Meshack-Kinyua/Omarichet_Versionngs/Omarichet EduSat/Electrical/PCB Designs v2/README.md

# Omarichet Edusat PCB Designs V2

This folder contains work related to the next set of designs for the Omarichet Edusat.
It takes into consideration feedback as well as test data on the previous work done on the version 1.
This designs are aimed at being close to the final product design as possible. 
Considerations will be taken on matters regarding the User experience and intuitive use of the kit.

## Objectives
* Make changes and improvements on the component choices.
* Make changes on the layout.
* Improve on the silkscreen labels.
* Added connectors to allow quick connection of the Boards to the various accessoriess.

**Note**
Specific Objectives and requirements will provided in the folders with the speccific board being worked on.
