Meshack-Kinyua/Omarichet_Versionngs/Omarichet EduSat/Electrical/PCB designs/Omarichet Sensor Shield v1.32 Gearbox Constraints/GearboxDesignConstraints.txt

Minimum Track width 0.7mm
Minimum clearance between tracks 0.8mm
Minimum Via size 0.3mm
