Meshack-Kinyua/Omarichet_Versionngs/EduSat v1/EPSv2/Project Outputs for EduSAT EPSv2/EduSAT-EPSv2_Pads_Top.pdf

EduSAT-EPSv2_Pads_Top (Current screen) Scale=1.00 Sat Jul 13 14:36:50 2024

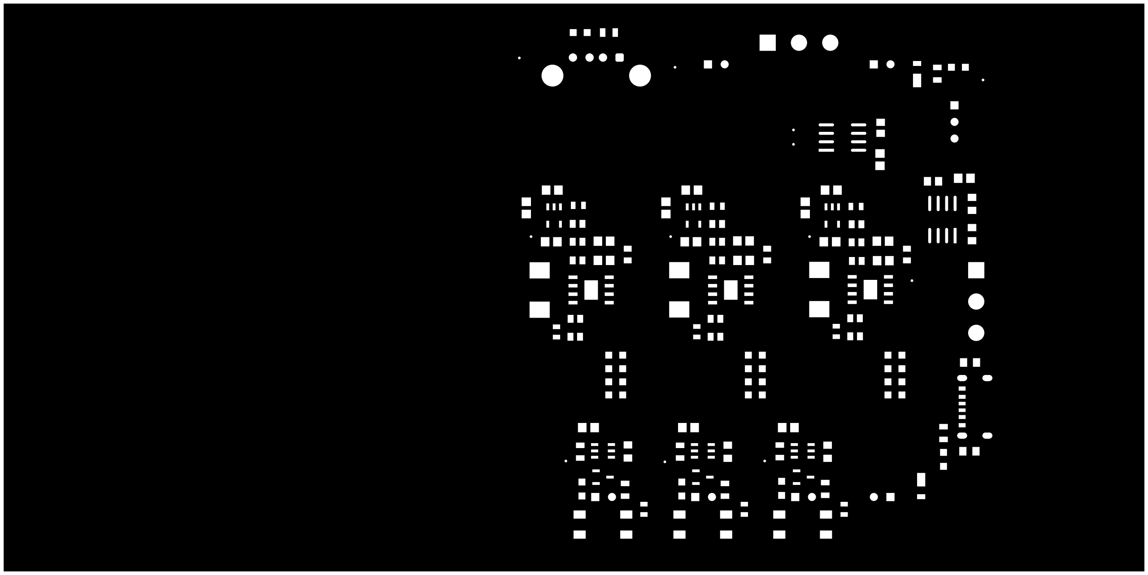
[picture p2: figure]
