Meshack-Kinyua/Omarichet_Versionngs/Omarichet EduSat/Electrical/Datasheets/Adafruit GPS/Schematic.png

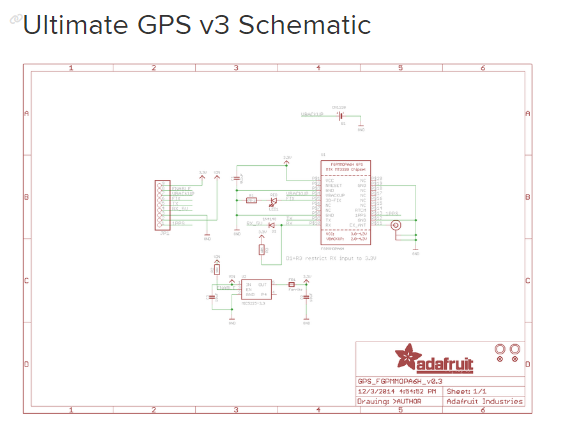
Omarichet EduSat/Electrical/Datasheets/Adafruit GPS/Schematic.png
