Meshack-Kinyua/Omarichet_Versionngs/Omarichet EduSat/Electrical/Omarichet Sensor Shield 2.png

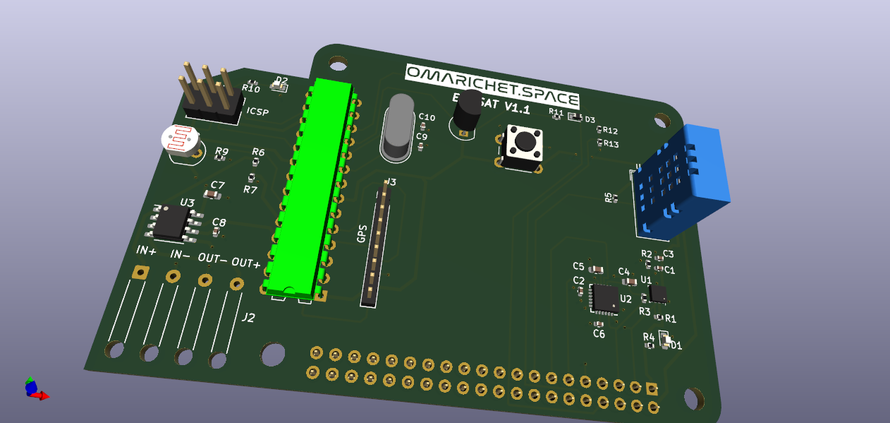
Omarichet EduSat/Electrical/Omarichet Sensor Shield 2.png
