Meshack-Kinyua/Omarichet_Versionngs/Omarichet EduSat/Electrical/PCB designs/Omarichet Sensor Shield v1.32 Gearbox Constraints/Omarichet Sensor Shield 1.3.png

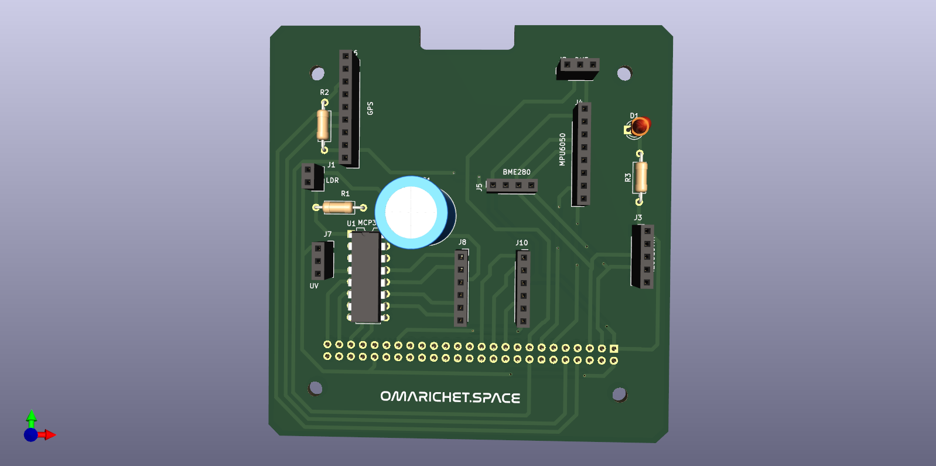
Omarichet EduSat/Electrical/PCB designs/Omarichet Sensor Shield v1.32 Gearbox Constraints/Omarichet Sensor Shield 1.3.png
