Meshack-Kinyua/Omarichet_Versionngs/Omarichet EduSat/Electrical/PCB designs/PCB Images/Omarichet Sensor shield Design.png

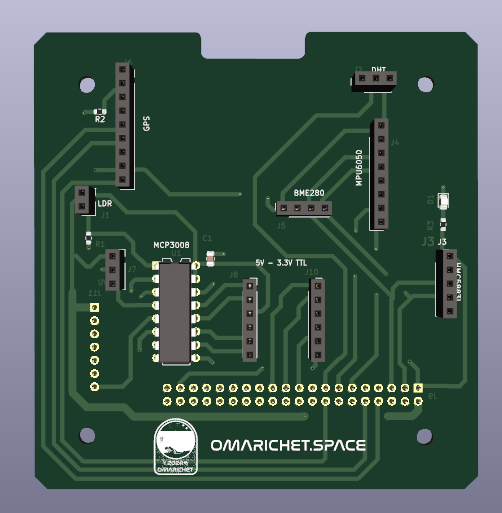
Omarichet EduSat/Electrical/PCB designs/PCB Images/Omarichet Sensor shield Design.png
