Meshack-Kinyua/Omarichet_Versionngs/Omarichet EduSat/Electrical/Simulations/RPI UART voltage divider/TX to TXD.png

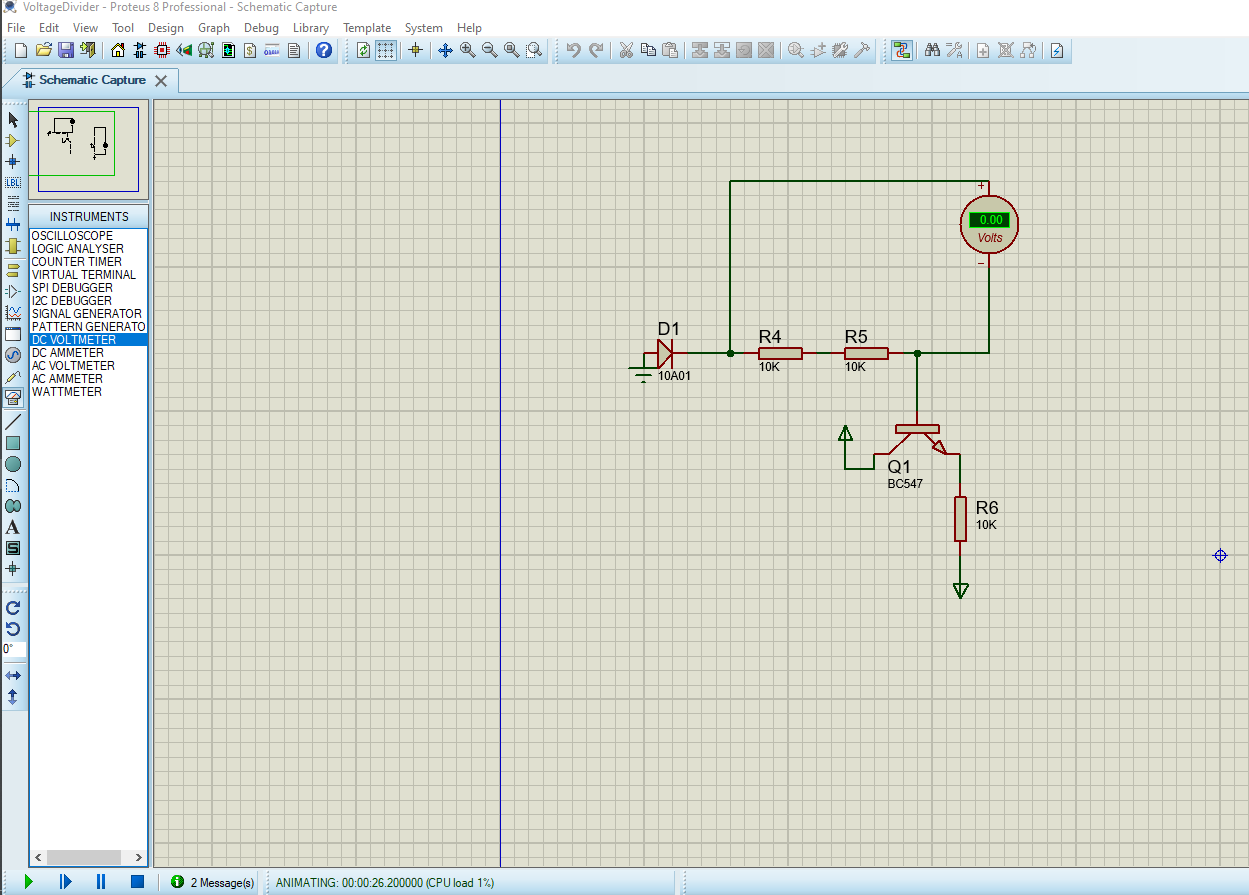
Omarichet EduSat/Electrical/Simulations/RPI UART voltage divider/TX to TXD.png
