Meshack-Kinyua/Omarichet_Versionngs/Omarichet EduSat/Electrical/Simulations/RPI UART voltage divider/TXD to TX.png

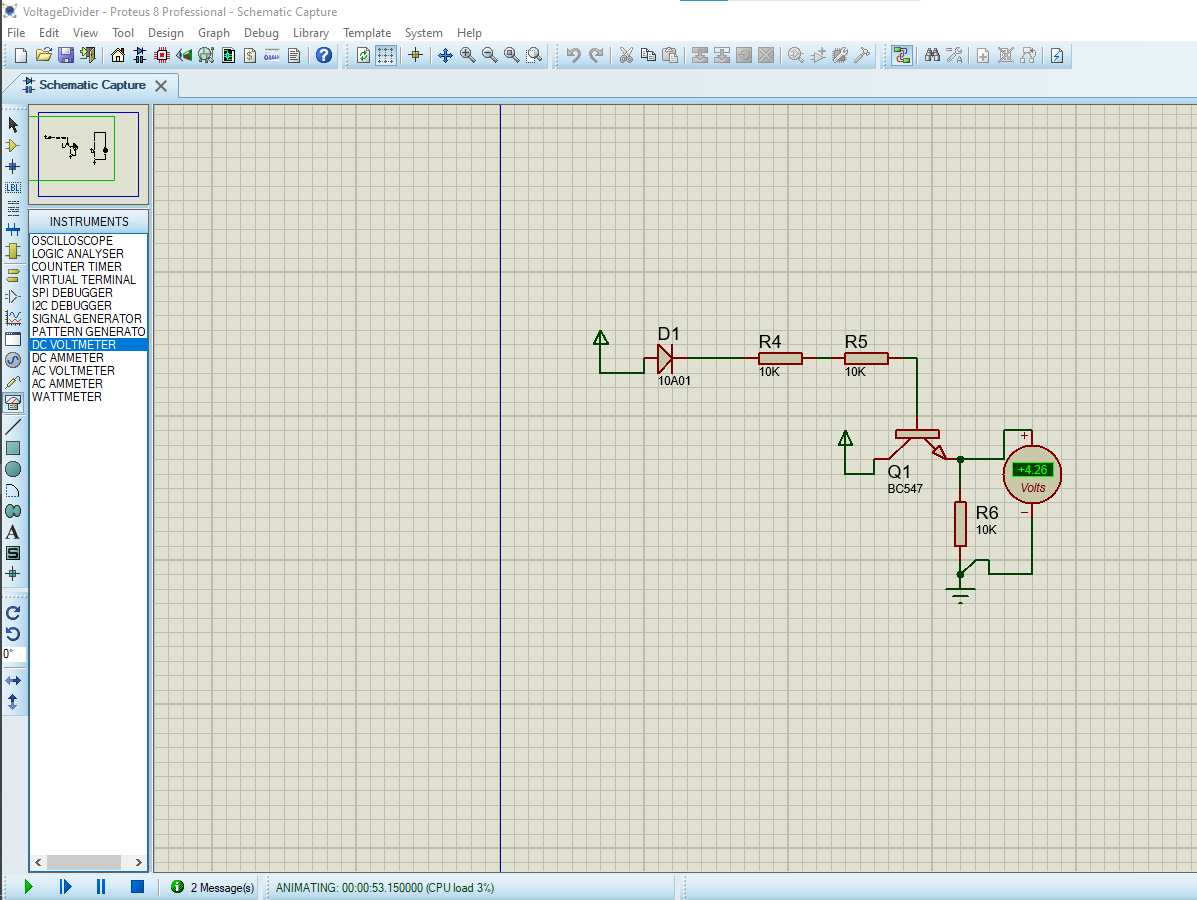
Omarichet EduSat/Electrical/Simulations/RPI UART voltage divider/TXD to TX.png
