Meshack-Kinyua/Omarichet_Versionngs/EduSat v1/EPSv2/Project Outputs for EduSAT EPSv2/BOM.PDF

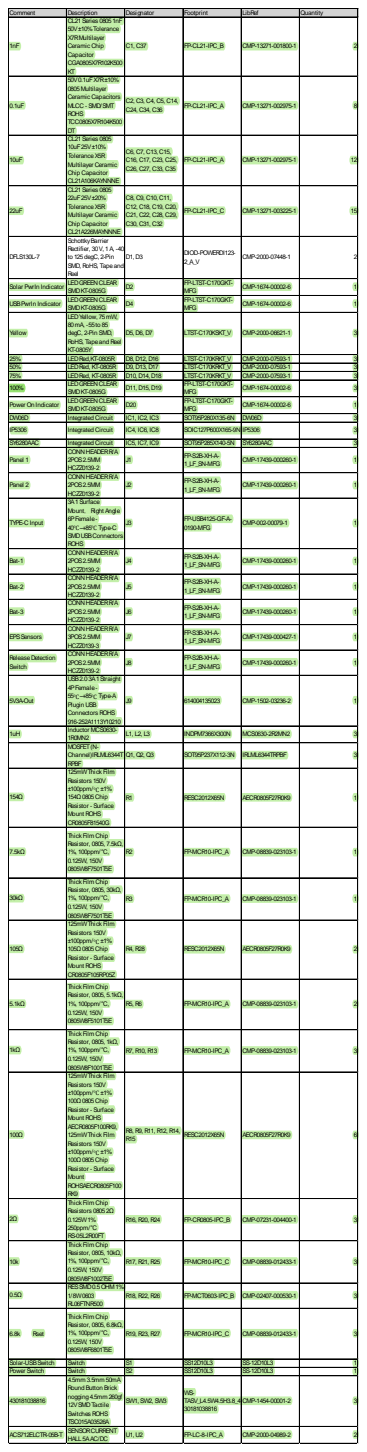
[picture p9: page 1]

0.1uF | 50V0.1uFX7R±10% 0805Multilayer Ceramic Capacitors MLCC - SMD/SMT ROHS TCC0805X7R104K500 DT | C2, C3, C4, C5, C14, C24, C34, C36 | FP-CL21-IPC_A | CMP-13271-002975-1 | | 8

10uF | CL21Series 0805 10uF25V±10% ToleranceX5R Multilayer Ceramic Chip Capacitor CL21A106KAYNNNE | C6, C7, C13, C15, C16, C17, C23, C25, C26, C27, C33, C35 | FP-CL21-IPC_A | CMP-13271-002975-1 | 12

22uF | CL21Series 0805 22uF25V±20% ToleranceX5R Multilayer Ceramic Chip Capacitor CL21A226MAYNNNE | C8, C9, C10, C11, C12, C18, C19, C20, C21, C22, C28, C29, C30, C31, C32 | FP-CL21-IPC_C | CMP-13271-003225-1 | 15

DFLS130L-7 | SchottkyBarrier Rectifier, 30V, 1A, -40 to 125degC, 2-Pin SMD, RoHS, Tapeand Reel | D1, D3 | DIOD-POWERDI123-2_A_V | CMP-2000-07448-1 | | 2

Solar PwrIn Indicator | LEDGREEN CLEAR SMDKT-0805G | D2 | FP-LTST-C170GKT-MFG | CMP-1674-00002-6 | | 1

USBPwrIn Indicator | LEDGREEN CLEAR SMDKT-0805G | D4 | FP-LTST-C170GKT-MFG | CMP-1674-00002-6 | | 1

Yellow | LEDYellow, 75mW, 80mA, -55to 85 degC, 2-Pin SMD, RoHS, Tapeand Reel KT-0805Y | D5, D6, D7 | LTST-C170KSKT_V | CMP-2000-06621-1 | | 3

25% | LEDRed,KT-0805R | D8, D12, D16 | LTST-C170KRKT_V | CMP-2000-07593-1 | | 3
50% | LEDRed, KT-0805R | D9, D13, D17 | LTST-C170KRKT_V | CMP-2000-07593-1 | | 3
75% | LEDRed, KT-0805R | D10, D14, D18 | LTST-C170KRKT_V | CMP-2000-07593-1 | | 3
100% | LEDGREEN CLEAR SMDKT-0805G | D11, D15, D19 | FP-LTST-C170GKT-MFG | CMP-1674-00002-6 | | 3

Power On Indicator | LEDGREEN CLEAR SMDKT-0805G | D20 | FP-LTST-C170GKT-MFG | CMP-1674-00002-6 | | 1

DW06D | Integrated Circuit | IC1, IC2, IC3 | SOT95P280X135-6N | DW06D | | 3

IP5306 | Integrated Circuit | IC4, IC6, IC8 | SOIC127P600X165-9N IP5306 | | | 3

SY6280AAC | Integrated Circuit | IC5, IC7, IC9 | SOT95P285X140-5N | SY6280AAC | | 3
Panel 1 | CONN HEADERR/A 2POS2.5MM HCZZ0139-2 | J1 | FP-S2B-XH-A-1_LF_SN-MFG | CMP-17439-000260-1 | | 1

Panel 2 | CONN HEADERR/A 2POS2.5MM HCZZ0139-2 | J2 | FP-S2B-XH-A-1_LF_SN-MFG | CMP-17439-000260-1 | | 1

TYPE-C Input | 3A1Surface Mount，Right Angle 6PFemale-40℃~+85℃ Type-C SMDUSBConnectors ROHS | J3 | FP-USB4125-GF-A-0190-MFG | CMP-002-00079-1 | | 1

Bat-1 | CONN HEADERR/A 2POS2.5MM HCZZ0139-2 | J4 | FP-S2B-XH-A-1_LF_SN-MFG | CMP-17439-000260-1 | | 1

Bat-2 | CONN HEADERR/A 2POS2.5MM HCZZ0139-2 | J5 | FP-S2B-XH-A-1_LF_SN-MFG | CMP-17439-000260-1 | | 1

Bat-3 | CONN HEADERR/A 2POS2.5MM HCZZ0139-2 | J6 | FP-S2B-XH-A-1_LF_SN-MFG | CMP-17439-000260-1 | | 1

EPSSensors | CONN HEADERR/A 3POS2.5MM HCZZ0139-3 | J7 | FP-S3B-XH-A-1_LF_SN-MFG | CMP-17439-000427-1 | | 1

ReleaseDetection Switch | CONN HEADERR/A 2POS2.5MM HCZZ0139-2 | J8 | FP-S2B-XH-A-1_LF_SN-MFG | CMP-17439-000260-1 | | 1

5V3A-Out | USB2.03A1Straight 4PFemale-55℃~+85℃ Type-A Plugin USB Connectors ROHS 916-252A1113Y10210 | J9 | 614004135023 | CMP-1502-03236-2 | | 1

1uH | Inductor MCS0630-1R0MN2 | L1, L2, L3 | INDPM7366X300N | MCS0630-2R2MN2 | | 3

MOSFET(N-Channel)IRLML6344T RPBF | Q1, Q2, Q3 | SOT95P237X112-3N | IRLML6344TRPBF | | 3

154Ω | 125mWThick Film Resistors 150V ±100ppm/℃ ±1% 154Ω0805Chip Resistor - Surface Mount ROHS CR0805F81540G | R1 | RESC2012X65N | AECR0805F27R0K9 | | 1

7.5kΩ | Thick Film Chip Resistor, 0805, 7.5kΩ, 1%, 100ppm/°C, 0.125W, 150V 0805W8F7501T5E | R2 | FP-MCR10-IPC_A | CMP-08839-023103-1 | | 1

30kΩ | Thick Film Chip Resistor, 0805, 30kΩ, 1%, 100ppm/°C, 0.125W, 150V 0805W8F7501T5E | R3 | FP-MCR10-IPC_A | CMP-08839-023103-1 | | 1

105Ω | 125mWThick Film Resistors 150V ±100ppm/℃ ±1% 105Ω0805Chip Resistor - Surface Mount ROHS CR0805F105RP05Z | R4, R28 | RESC2012X65N | AECR0805F27R0K9 | | 2

5.1kΩ | Thick Film Chip Resistor, 0805, 5.1kΩ, 1%, 100ppm/°C, 0.125W, 150V 0805W8F5101T5E | R5, R6 | FP-MCR10-IPC_A | CMP-08839-023103-1 | | 2

1kΩ | Thick Film Chip Resistor, 0805, 1kΩ, 1%, 100ppm/°C, 0.125W, 150V 0805W8F1001T5E | R7, R10, R13 | FP-MCR10-IPC_A | CMP-08839-023103-1 | | 3

100Ω | 125mWThick Film Resistors 150V ±100ppm/℃ ±1% 100Ω0805Chip Resistor - Surface Mount ROHS AECR0805F100RK9, 125mWThick Film Resistors 150V ±100ppm/℃ ±1% 100Ω0805Chip Resistor - Surface Mount ROHSAECR0805F100 RK9 | R8, R9, R11, R12, R14, R15 | RESC2012X65N | AECR0805F27R0K9 | | 6

2Ω | Thick Film Chip Resistors 08052Ω 0.125W1% 250ppm/°C RS-05L2R00FT | R16, R20, R24 | FP-CR0805-IPC_B | CMP-07231-004400-1 | | 3

10k | Thick Film Chip Resistor, 0805, 10kΩ, 1%, 100ppm/°C, 0.125W, 150V 0805W8F1002T5E | R17, R21, R25 | FP-MCR10-IPC_C | CMP-08839-012433-1 | | 3

0.5Ω | RESSMD0.5OHM1% 1/8W0603 RL06FTNR500 | R18, R22, R26 | FP-MCT0603-IPC_B | CMP-02407-000530-1 | | 3

6.8k Rset | Thick Film Chip Resistor, 0805, 6.8kΩ, 1%, 100ppm/°C, 0.125W, 150V 0805W8F6801T5E | R19, R23, R27 | FP-MCR10-IPC_C | CMP-08839-012433-1 | | 3

Solar-USBSwitch | Switch | S1 | SS12D10L3 | SS-12D10L3 | | 1
Power Switch | Switch | S2 | SS12D10L3 | SS-12D10L3 | | 1
430181038816 | 4.5mm 3.5mm 50mA Round Button Brick nogging4.5mm 260gf 12VSMDTactile Switches ROHS TSC015A03526A | SW1, SW2, SW3 | WS-TASV_L4.5W4.5H3.8_4 30181038816 | CMP-1454-00001-2 | | 3

ACS712ELCTR-05B-T | SENSORCURRENT HALL5AAC/DC | U1, U2 | FP-LC-8-IPC_A | CMP-2000-04989-2 | | 2
