Meshack-Kinyua/Omarichet_Versionngs/EduSat v2/EPSv3/Resources/Footprints/1043/1043.step

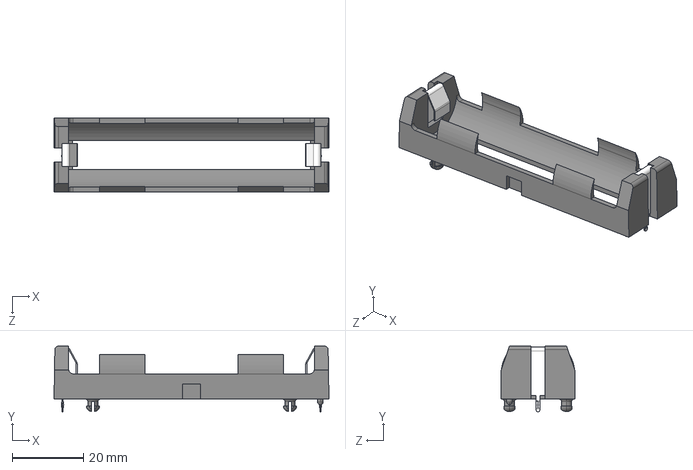
[picture p10: CAD file, 2024-10-04]
EduSat v2/EPSv3/Resources/Footprints/1043/1043.step
77.1 x 18.4 x 20.7 mm
