Meshack-Kinyua/Omarichet_Versionngs/EduSat v2/EPSv3/Resources/Footprints/DFLS130L-7/DFLS130L-7.step

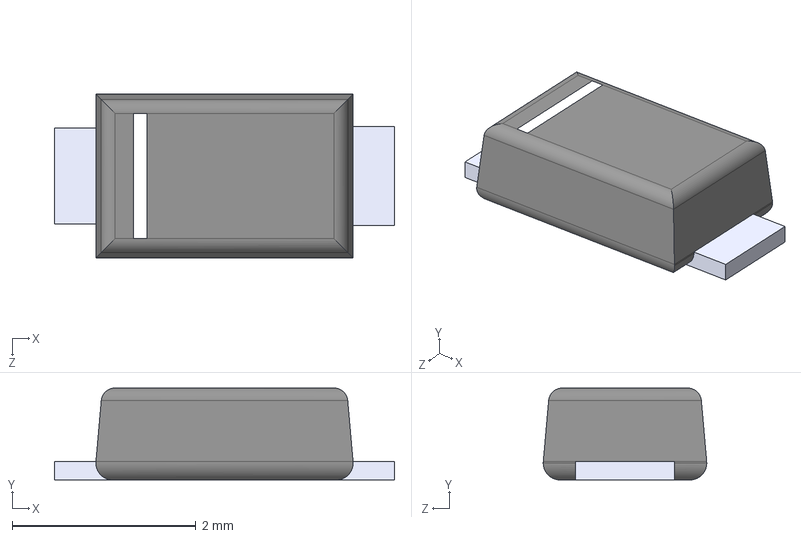
[picture p11: CAD file, 2024-10-02]
EduSat v2/EPSv3/Resources/Footprints/DFLS130L-7/DFLS130L-7.step
3.70 x 1.00 x 1.78 mm
