Meshack-Kinyua/Omarichet_Versionngs/EduSat v2/EPSv3/Resources/Footprints/IP5306/IP5306.step

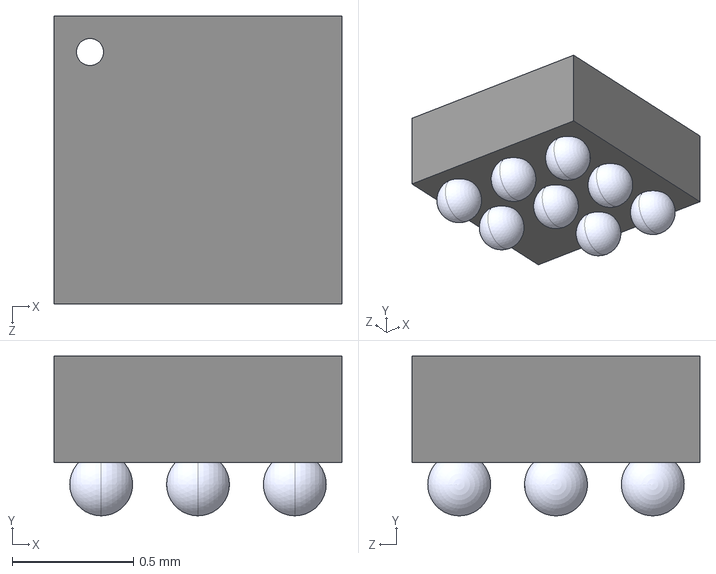
[picture p12: CAD file, 2024-10-02]
EduSat v2/EPSv3/Resources/Footprints/IP5306/IP5306.step
1.19 x 0.66 x 1.19 mm
