Meshack-Kinyua/Omarichet_Versionngs/EduSat v2/EPSv3/Resources/Footprints/LIB_MCS0630-100MN1/MCS0630-100MN1/3D/MCS0630-100MN1.stp

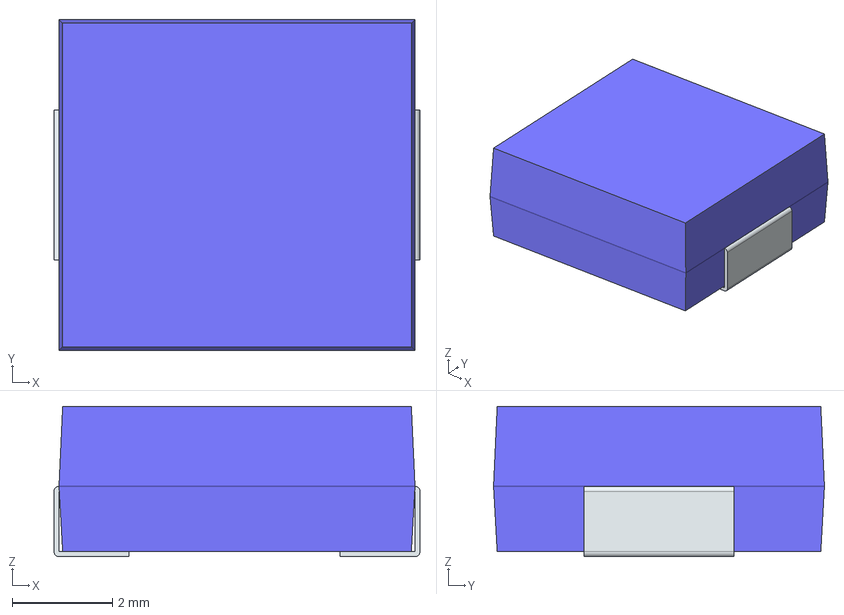
[picture p13: CAD file, 2024-10-02]
EduSat v2/EPSv3/Resources/Footprints/LIB_MCS0630-100MN1/MCS0630-100MN1/3D/MCS0630-100MN1.stp
7.30 x 6.60 x 3.00 mm
FilletPin1
FilletPin2
