Meshack-Kinyua/Omarichet_Versionngs/EduSat v2/EPSv3/Resources/Footprints/LIB_PTS647SM50SMTR2LFS/PTS647SM50SMTR2LFS/3D/PTS647SM50SMTR2LFS.stp

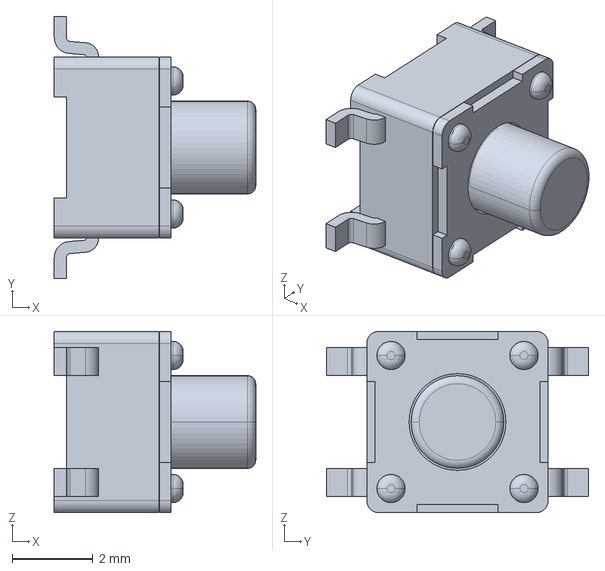
[picture p14: CAD file, 2024-10-02]
EduSat v2/EPSv3/Resources/Footprints/LIB_PTS647SM50SMTR2LFS/PTS647SM50SMTR2LFS/3D/PTS647SM50SMTR2LFS.stp
5.00 x 6.50 x 4.50 mm
