Meshack-Kinyua/Omarichet_Versionngs/EduSat v2/EPSv3/Resources/Footprints/LIB_SS-12D10L3/SS-12D10L3/3D/SS-12D10L3.stp

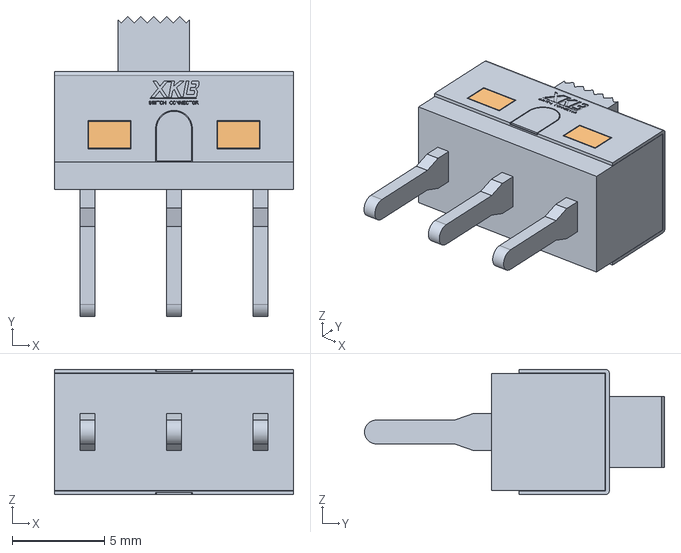
[picture p15: CAD file, 2024-08-22]
EduSat v2/EPSv3/Resources/Footprints/LIB_SS-12D10L3/SS-12D10L3/3D/SS-12D10L3.stp
13.0 x 16.3 x 6.80 mm
