Meshack-Kinyua/Omarichet_Versionngs/EduSat v2/EPSv3/Resources/STEP Files/DW06D.stp

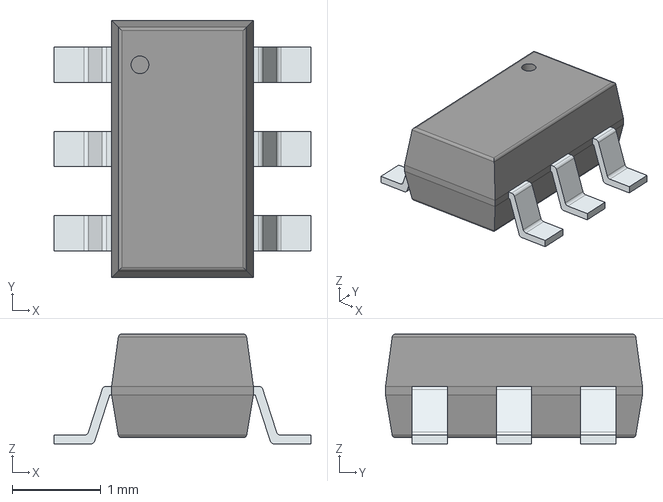
[picture p16: CAD file, 2024-10-02]
EduSat v2/EPSv3/Resources/STEP Files/DW06D.stp
2.90 x 2.90 x 1.24 mm
PinsArrayLR
