Meshack-Kinyua/Omarichet_Versionngs/EduSat v2/OBCv1/Resources/ESP32-WROOM-32E__4MB_/ESP32-WROOM-32E__4MB_.step

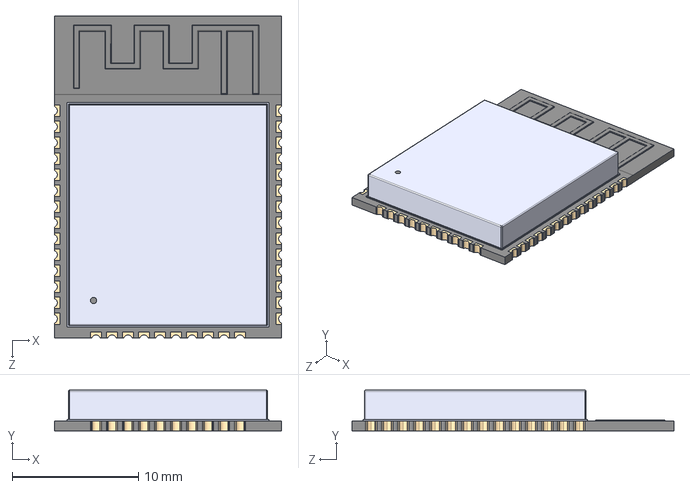
[picture p17: CAD file, 2024-08-21]
EduSat v2/OBCv1/Resources/ESP32-WROOM-32E__4MB_/ESP32-WROOM-32E__4MB_.step
18.0 x 3.25 x 25.5 mm
