Meshack-Kinyua/Omarichet_Versionngs/EduSat v2/OBCv1/Resources/RA-02--3DModel-STEP-269445.STEP

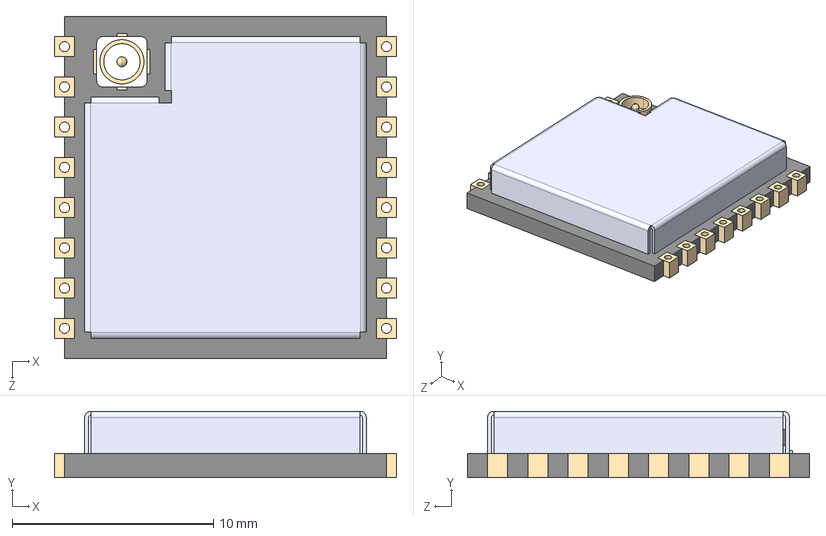
[picture p18: CAD file, 2024-08-21]
EduSat v2/OBCv1/Resources/RA-02--3DModel-STEP-269445.STEP
17.0 x 3.30 x 17.0 mm
