Meshack-Kinyua/Omarichet_Versionngs/EduSat v2/OBCv1/Resources/TF-01A/TF-01A.step

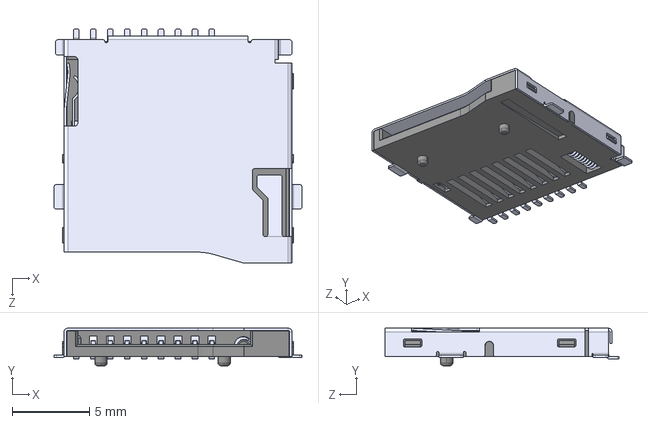
[picture p19: CAD file, 2024-08-21]
EduSat v2/OBCv1/Resources/TF-01A/TF-01A.step
16.1 x 2.45 x 15.2 mm
