Meshack-Kinyua/Omarichet_Versionngs/Omarichet EduSat/Electrical/PCB designs/Omarichet Sensor Shield V1.5/Resources/Kicad resources/TP4366E/3D/TP4366E.stp

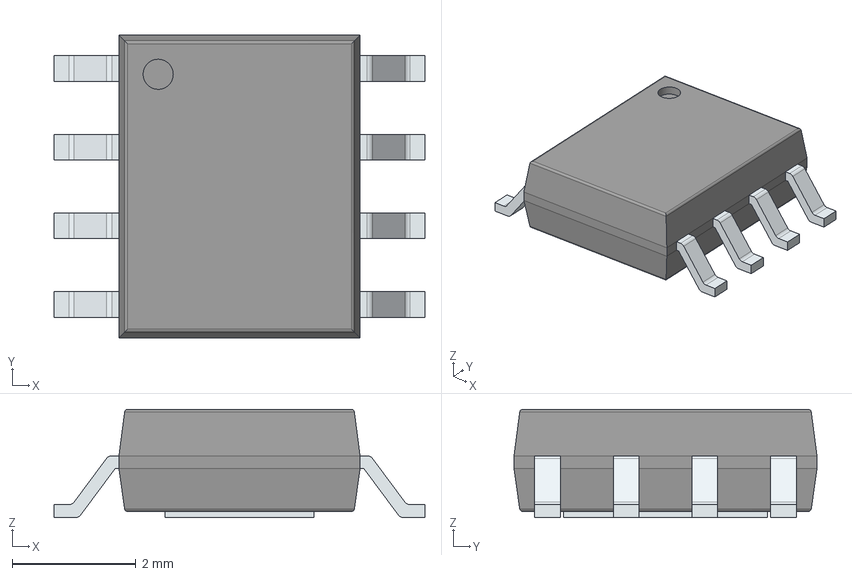
[picture p20: CAD file, 2024-07-20]
Omarichet EduSat/Electrical/PCB designs/Omarichet Sensor Shield V1.5/Resources/Kicad resources/TP4366E/3D/TP4366E.stp
6.00 x 4.90 x 1.75 mm
PinsArrayLR
ThermalPad
