Meshack-Kinyua/Omarichet_Versionngs/Omarichet EduSat/Electrical/PCB designs/Omarichet Sensor Shield V1.5/Resources/Kicad resources/XB7608AJ/3D/XB7608A.stp

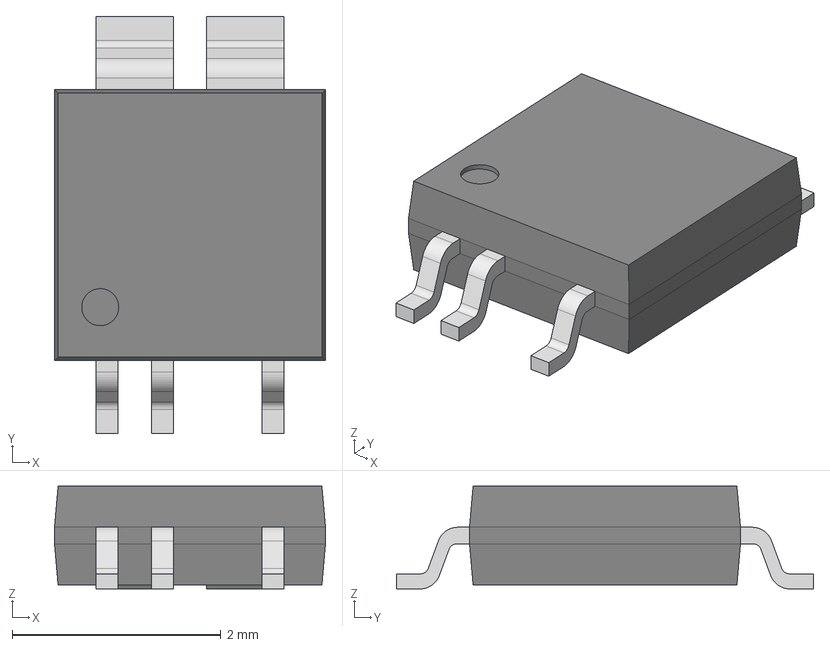
[picture p21: CAD file, 2024-07-20]
Omarichet EduSat/Electrical/PCB designs/Omarichet Sensor Shield V1.5/Resources/Kicad resources/XB7608AJ/3D/XB7608A.stp
2.60 x 4.00 x 0.988 mm
