Meshack-Kinyua/Omarichet_Versionngs/Omarichet EduSat/Mechanical/HEPTA-based/spacer_women_25 v2 v1.stl

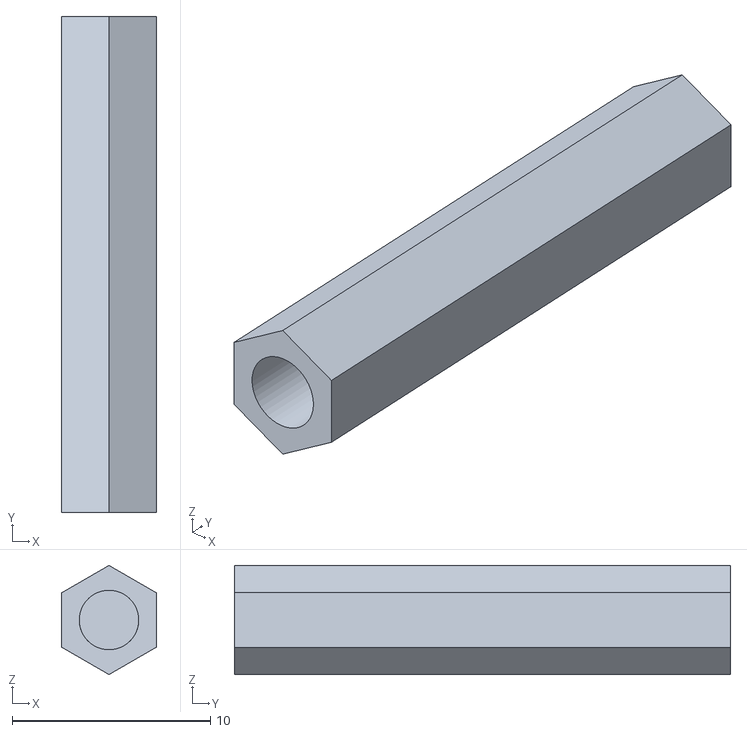
[picture p22: CAD file, 2024-07-20]
Omarichet EduSat/Mechanical/HEPTA-based/spacer_women_25 v2 v1.stl
4.76 x 25.0 x 5.50
