Meshack-Kinyua/Omarichet_Versionngs/Omarichet EduSat/Mechanical/Omarichet v1/Session 7 CubeSat_Body_2.stl

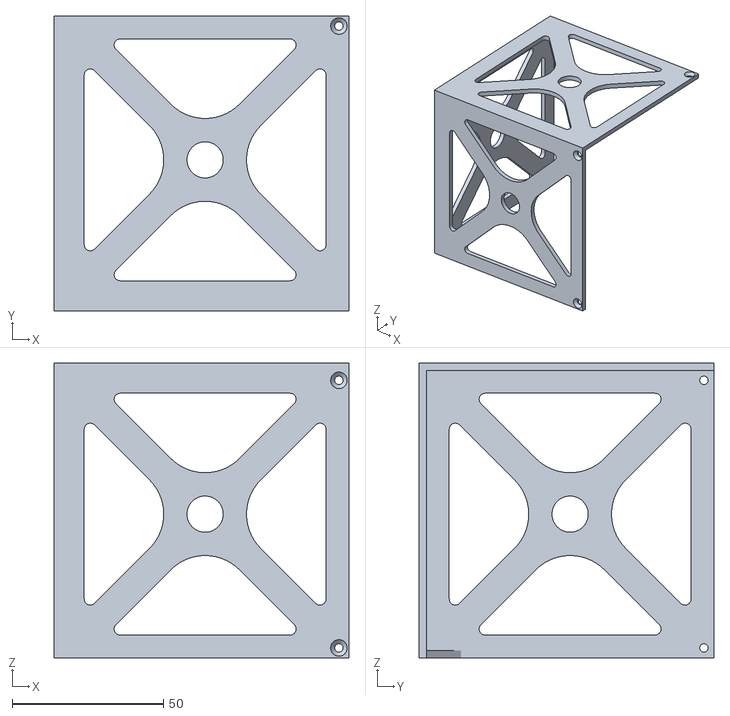
[picture p23: CAD file, 2024-07-20]
Omarichet EduSat/Mechanical/Omarichet v1/Session 7 CubeSat_Body_2.stl
97.6 x 97.6 x 97.6
