Meshack-Kinyua/Omarichet_Versionngs/EduSat v2/OBCv1/Resources/USB4105-GF-A--3DModel-STEP-510211.STEP

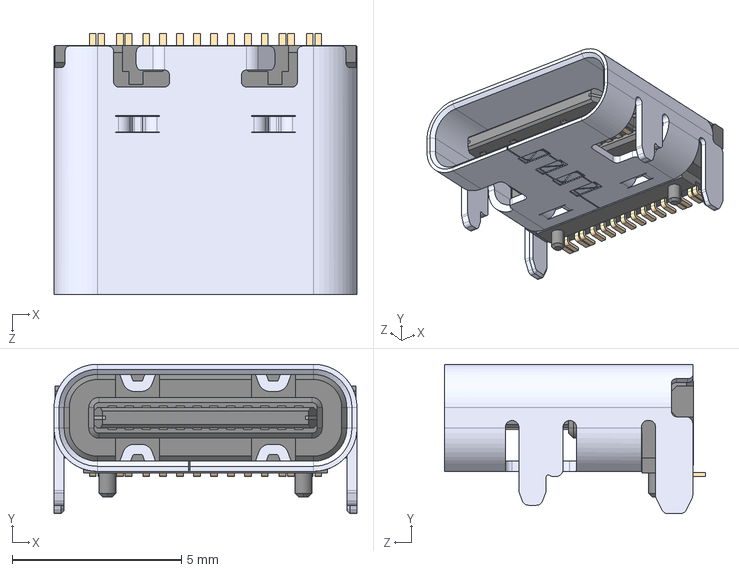
[picture p24: CAD file, 2024-08-21]
EduSat v2/OBCv1/Resources/USB4105-GF-A--3DModel-STEP-510211.STEP
8.94 x 4.41 x 7.71 mm
