Meshack-Kinyua/Omarichet_Versionngs/Omarichet EduSat/Mechanical/HEPTA-based/bottom_Panel v5.stl

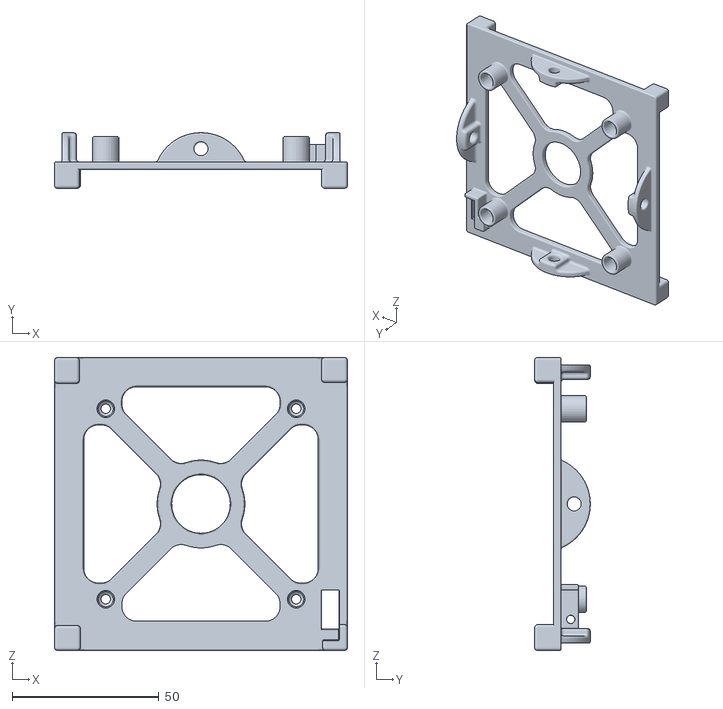
[picture p25: CAD file, 2024-07-20]
Omarichet EduSat/Mechanical/HEPTA-based/bottom_Panel v5.stl
100.0 x 19.0 x 100.0
