Meshack-Kinyua/Omarichet_Versionngs/Omarichet EduSat/Mechanical/Omarichet v1/Session 7 CubeSat.stl

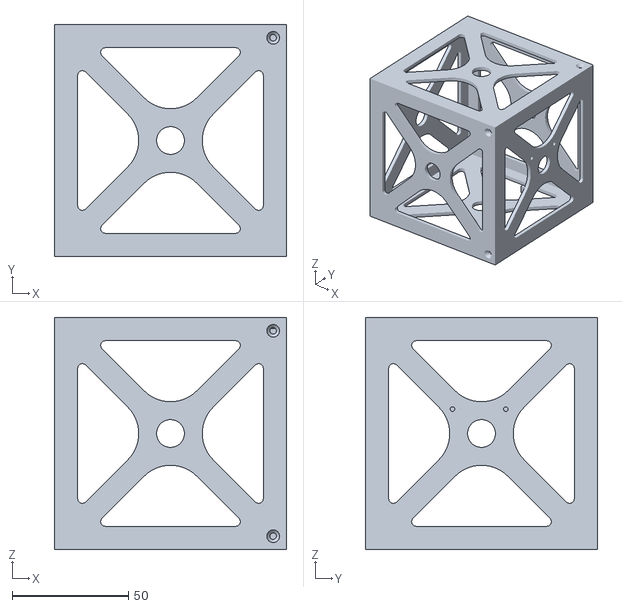
[picture p26: CAD file, 2024-07-20]
Omarichet EduSat/Mechanical/Omarichet v1/Session 7 CubeSat.stl
100.0 x 100.0 x 100.0
