Meshack-Kinyua/Omarichet_Versionngs/EduSat v2/EPSv3/Resources/STEP Files/IRLML6344TRPBF.step

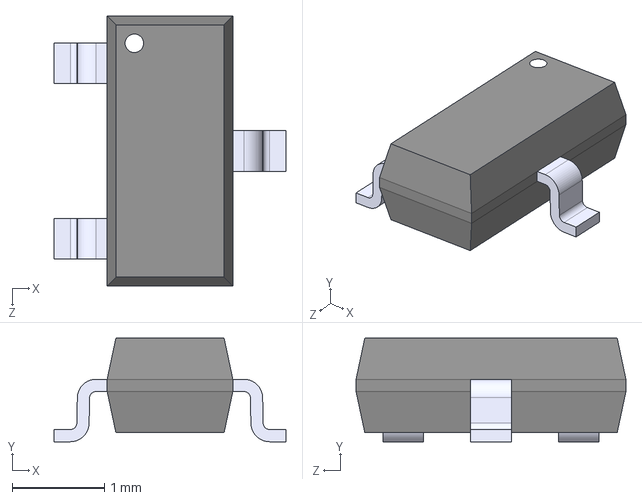
[picture p27: CAD file, 2024-09-27]
EduSat v2/EPSv3/Resources/STEP Files/IRLML6344TRPBF.step
2.51 x 1.12 x 2.92 mm
