Meshack-Kinyua/Omarichet_Versionngs/Omarichet EduSat/Electrical/PCB designs/Omarichet Sensor Shield V1.5/Resources/Kicad resources/USB Micro B -629105150521 (rev1).stp

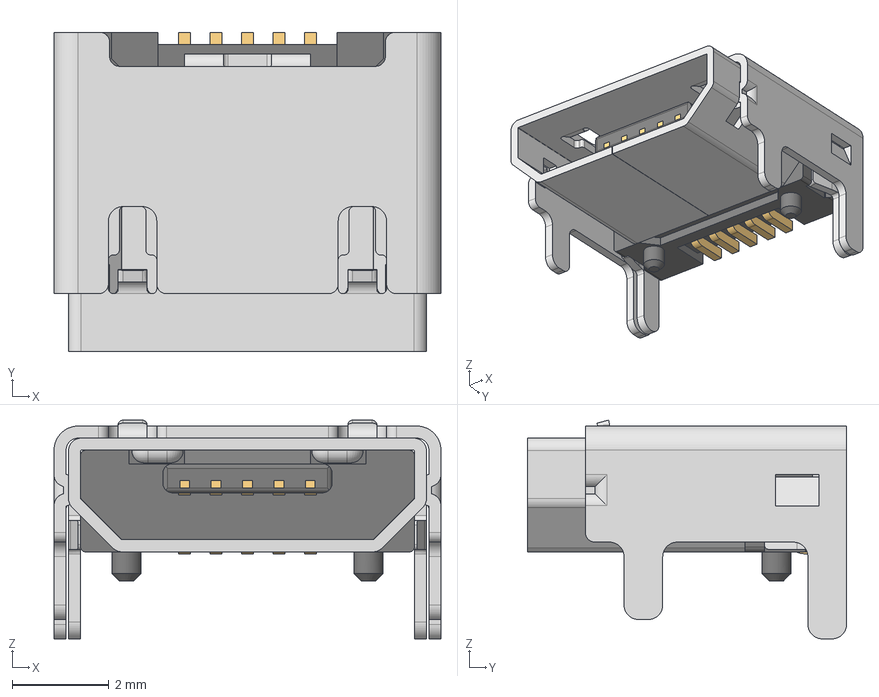
[picture p28: CAD file, 2024-07-20]
Omarichet EduSat/Electrical/PCB designs/Omarichet Sensor Shield V1.5/Resources/Kicad resources/USB Micro B -629105150521 (rev1).stp
8.00 x 6.60 x 4.52 mm
629105150521_Housing
629105150521_Pin1 x 4
629105150521_Pin2
629105150521_Shielding2
629105150521_Shielding
