Meshack-Kinyua/Omarichet_Versionngs/Omarichet EduSat/Mechanical/HEPTA-based/spacer_men_25 v2 v1.stl

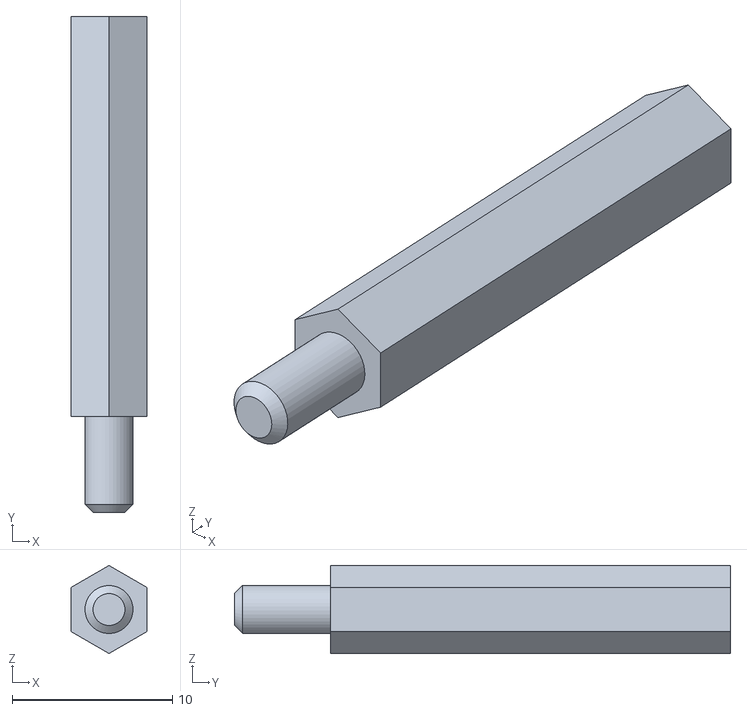
[picture p29: CAD file, 2024-07-20]
Omarichet EduSat/Mechanical/HEPTA-based/spacer_men_25 v2 v1.stl
4.76 x 31.0 x 5.50
