Meshack-Kinyua/Omarichet_Versionngs/Omarichet EduSat/Mechanical/Omarichet v1/Session 7 CubeSat_Body_1.stl

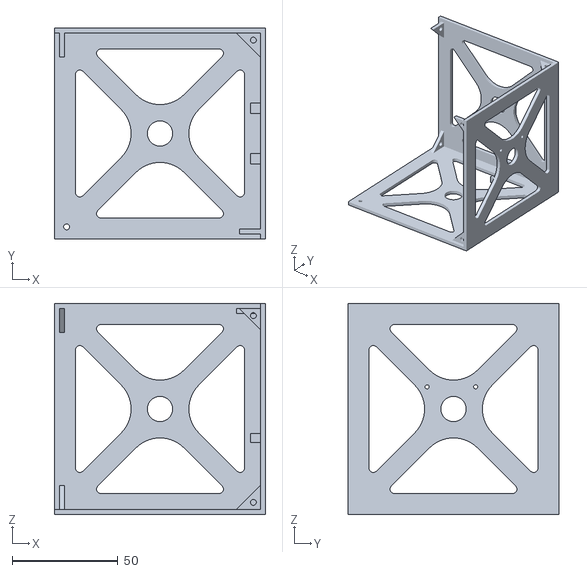
[picture p30: CAD file, 2024-07-20]
Omarichet EduSat/Mechanical/Omarichet v1/Session 7 CubeSat_Body_1.stl
100.0 x 100.0 x 100.0
