Meshack-Kinyua/Omarichet_Versionngs/EduSat v2/EPSv3/Resources/STEP Files/1042.step

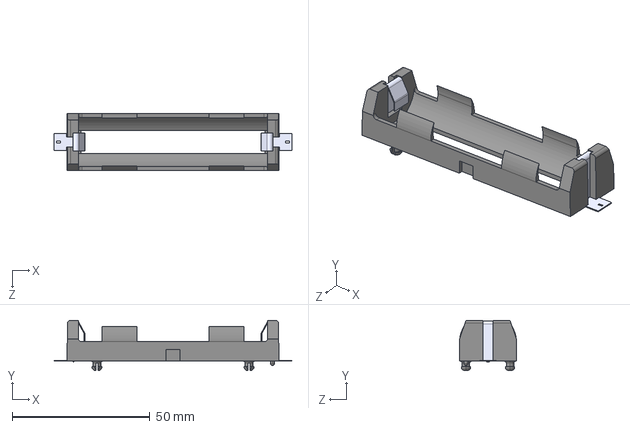
[picture p31: CAD file, 2024-09-27]
EduSat v2/EPSv3/Resources/STEP Files/1042.step
86.5 x 18.3 x 20.7 mm
