Meshack-Kinyua/Omarichet_Versionngs/Omarichet EduSat/Mechanical/HEPTA-based/upper_Panel v5.stl

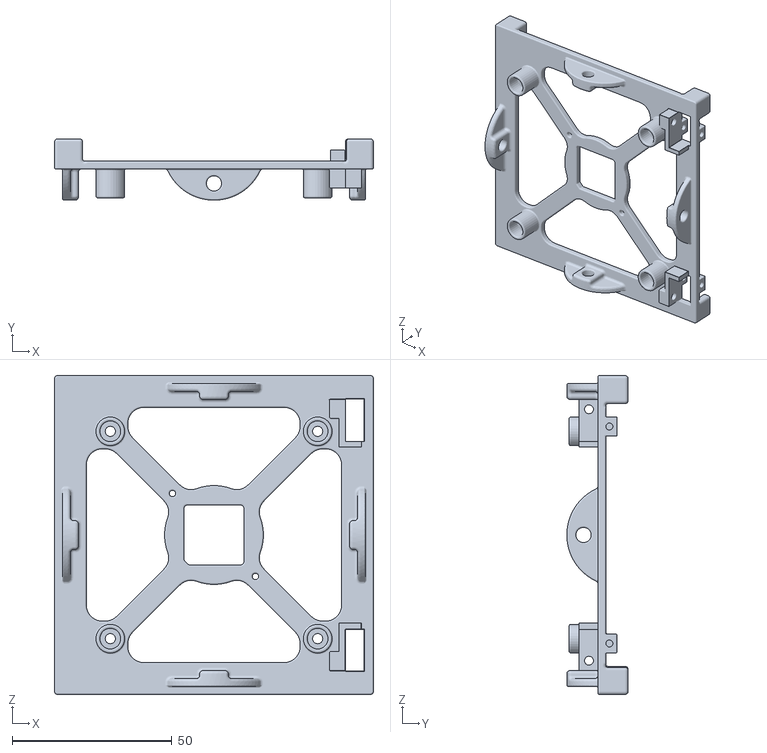
[picture p32: CAD file, 2024-07-20]
Omarichet EduSat/Mechanical/HEPTA-based/upper_Panel v5.stl
100.0 x 19.2 x 100.0
