Meshack-Kinyua/Omarichet_Versionngs/EduSat v2/EPSv3/Resources/STEP Files/IP5306.stp

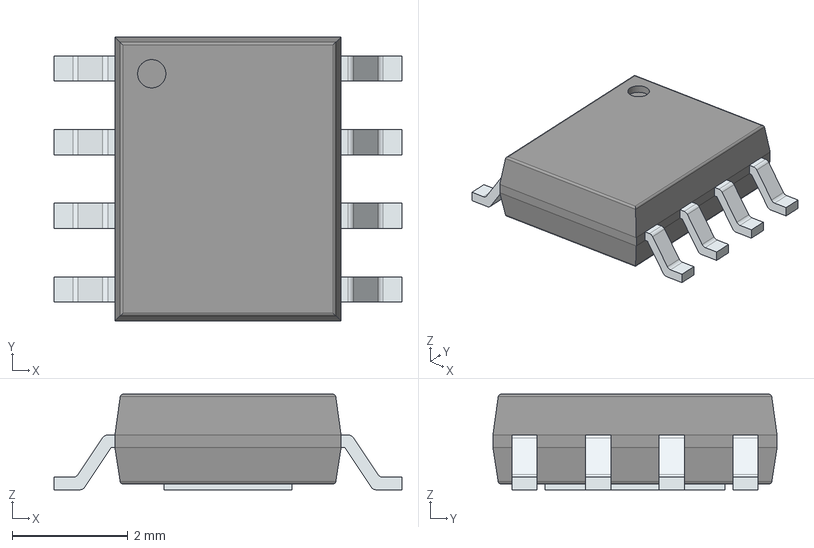
[picture p33: CAD file, 2024-08-22]
EduSat v2/EPSv3/Resources/STEP Files/IP5306.stp
6.00 x 4.90 x 1.65 mm
PinsArrayLR
ThermalPad
