Meshack-Kinyua/Omarichet_Versionngs/Omarichet EduSat/Mechanical/HEPTA-based/spacer_men_16 v2 v1.stl

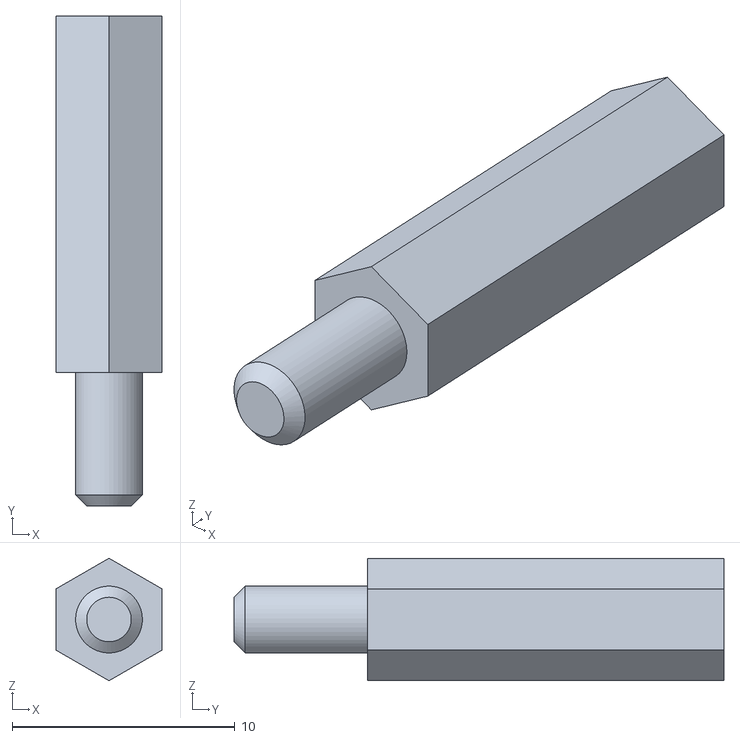
[picture p34: CAD file, 2024-07-20]
Omarichet EduSat/Mechanical/HEPTA-based/spacer_men_16 v2 v1.stl
4.76 x 22.0 x 5.50
