Meshack-Kinyua/Omarichet_Versionngs/Omarichet EduSat/Mechanical/HEPTA-based/Onebody_SidePanel v3.stl

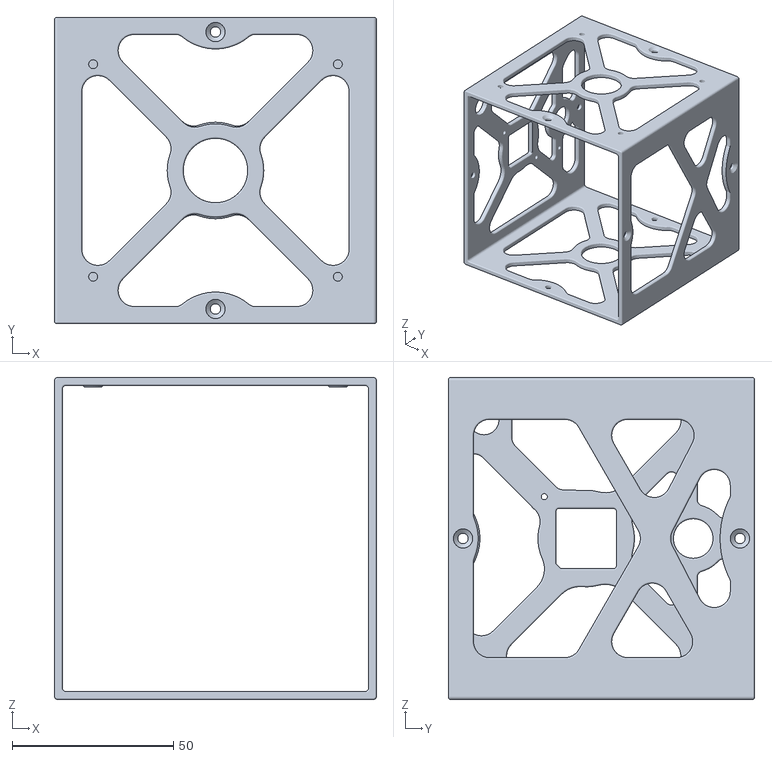
[picture p35: CAD file, 2024-07-20]
Omarichet EduSat/Mechanical/HEPTA-based/Onebody_SidePanel v3.stl
100.0 x 95.0 x 100.0
