Meshack-Kinyua/Omarichet_Versionngs/(list of files, cad)

Other CAD files:
EduSat v1/EPSv2/ALTIUM_EMBEDDED_MODELS/430181038816.stp
EduSat v1/EPSv2/ALTIUM_EMBEDDED_MODELS/614004135023.stp
EduSat v1/EPSv2/ALTIUM_EMBEDDED_MODELS/AECR0805F27R0K9.stp
EduSat v1/EPSv2/ALTIUM_EMBEDDED_MODELS/Cap_Samsung_CL21B273KBANNNC_eec.STEP
EduSat v1/EPSv2/ALTIUM_EMBEDDED_MODELS/Conn_GCT_USB4125-GF-A-0190_eec.STEP
EduSat v1/EPSv2/ALTIUM_EMBEDDED_MODELS/Conn_JST_S2B-XH-A-1_LF_SN_eec.STEP
EduSat v1/EPSv2/ALTIUM_EMBEDDED_MODELS/Conn_JST_S3B-XH-A-1_LF_SN_eec.STEP
EduSat v1/EPSv2/ALTIUM_EMBEDDED_MODELS/DW06D.stp
EduSat v1/EPSv2/ALTIUM_EMBEDDED_MODELS/Diode_Lite-On_LTST-C170GKT_eec.STEP
EduSat v1/EPSv2/ALTIUM_EMBEDDED_MODELS/IC_Allegro_MicroSystems_LLC_ACS713ELCTR-30A-T_eec.STEP
EduSat v1/EPSv2/ALTIUM_EMBEDDED_MODELS/IRLML6344TRPBF.stp
EduSat v1/EPSv2/ALTIUM_EMBEDDED_MODELS/MCS0630-2R2MN2.stp
EduSat v1/EPSv2/ALTIUM_EMBEDDED_MODELS/Res_Bourns_CR0805AFW-22R1EAS_eec.STEP
EduSat v1/EPSv2/ALTIUM_EMBEDDED_MODELS/Res_Rohm_MCR10ERTJ510_eec.STEP
EduSat v1/EPSv2/ALTIUM_EMBEDDED_MODELS/SY6280AAC.stp
EduSat v1/EPSv2/PCBModel.dxf
EduSat v1/EPSv2/Project Outputs for EduSAT EPSv2/Top_pads.dxf
EduSat v1/SensorBoardv2/ALTIUM_EMBEDDED_MODELS/61300311821.stp
EduSat v1/SensorBoardv2/ALTIUM_EMBEDDED_MODELS/61300511821.stp
EduSat v1/SensorBoardv2/ALTIUM_EMBEDDED_MODELS/61300611821.stp
EduSat v1/SensorBoardv2/ALTIUM_EMBEDDED_MODELS/61300811821.stp
EduSat v1/SensorBoardv2/ALTIUM_EMBEDDED_MODELS/61300911821.stp
EduSat v1/SensorBoardv2/ALTIUM_EMBEDDED_MODELS/61301221821.stp
EduSat v1/SensorBoardv2/ALTIUM_EMBEDDED_MODELS/AECR0805F27R0K9.stp
EduSat v1/SensorBoardv2/ALTIUM_EMBEDDED_MODELS/Cap_Samsung_CL21B273KBANNNC_eec.STEP
EduSat v1/SensorBoardv2/ALTIUM_EMBEDDED_MODELS/Conn_JST_B2B-XH-A_LF_SN_eec.STEP
EduSat v1/SensorBoardv2/ALTIUM_EMBEDDED_MODELS/Conn_JST_S3B-XH-A-1_LF_SN_eec.STEP
EduSat v1/SensorBoardv2/ALTIUM_EMBEDDED_MODELS/Conn_TE_Connectivity_7-534206-0_eec.STEP
EduSat v1/SensorBoardv2/ALTIUM_EMBEDDED_MODELS/Res_Rohm_MCR10ERTJ510_eec.STEP
EduSat v1/SensorBoardv2/ALTIUM_EMBEDDED_MODELS/step_temp.STEP
EduSat v2/EPSv3/Resources/Footprints/LIB_MCS0630-100MN1/MCS0630-100MN1/Allegro/indpm7366x300n.psm
EduSat v2/EPSv3/Resources/Footprints/LIB_MCS0630-100MN1/MCS0630-100MN1/DEHDL/mcs0630_100mn1/chips/chips.prt
EduSat v2/EPSv3/Resources/Footprints/LIB_PTS647SM50SMTR2LFS/PTS647SM50SMTR2LFS/Allegro/pts647sm50smtr2lfs.psm
EduSat v2/EPSv3/Resources/Footprints/LIB_PTS647SM50SMTR2LFS/PTS647SM50SMTR2LFS/DEHDL/pts647sm50smtr2lfs/chips/chips.prt
EduSat v2/EPSv3/Resources/Footprints/LIB_SS-12D10L3/SS-12D10L3/Allegro/ss12d10l3.psm
EduSat v2/EPSv3/Resources/Footprints/LIB_SS-12D10L3/SS-12D10L3/DEHDL/ss_12d10l3/chips/chips.prt
Omarichet EduSat/Electrical/PCB designs/Omarichet Sensor Shield V1.5/Resources/Kicad resources/105057-0001.stp
Omarichet EduSat/Electrical/PCB designs/Omarichet Sensor Shield V1.5/Resources/Kicad resources/67643-3911.stp
