Meshack-Kinyua/Omarichet_Versionngs/Omarichet EduSat/Electrical/SolderedComponents.docx

Component | No. | Unit Price | Total Price
10u Capacitor | 3 | 10 | 30
Lm7805 Regulator | 1 | 30 | 30
ACS712-05B | 1 | 300 | 300
LED | 2 | 5 | 10
1x40 Male Pin Header Connectors | 2 | 25 | 50
2x40 Male Pin Header connectors | 1 | 30 | 30
2x50 Female Pin Socket connectors (Stackable) | 2 | 30 | 60
2x50 Female Pin Socket connectors | 1 | 30 | 30
10u Capacitor | 3 | 10 | 30
Total | | | 570/=

Soldered Components for 1 unit of the Edusat
