Meshack-Kinyua/Omarichet_Versionngs/Omarichet EduSat/Electrical/Datasheets/Adafruit GPS/Fabrication Print.png

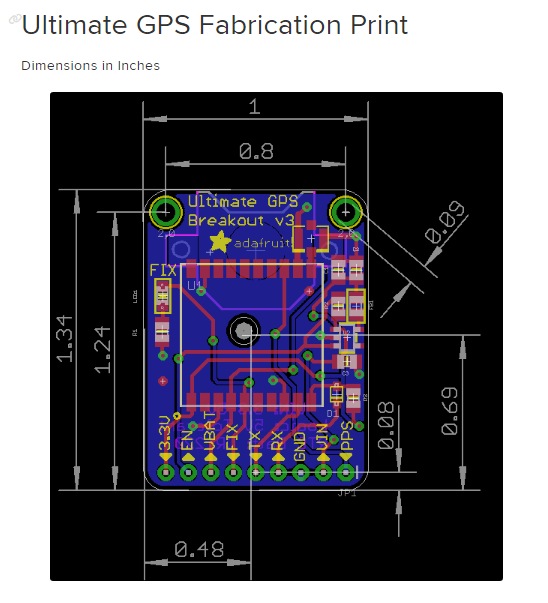
Omarichet EduSat/Electrical/Datasheets/Adafruit GPS/Fabrication Print.png
