Meshack-Kinyua/Omarichet_Versionngs/EduSat v1/system-diagrams/edusat-sensor-board-block-diagram-v1.pdf

# EduSat Sensor Board Block Diagrams v1

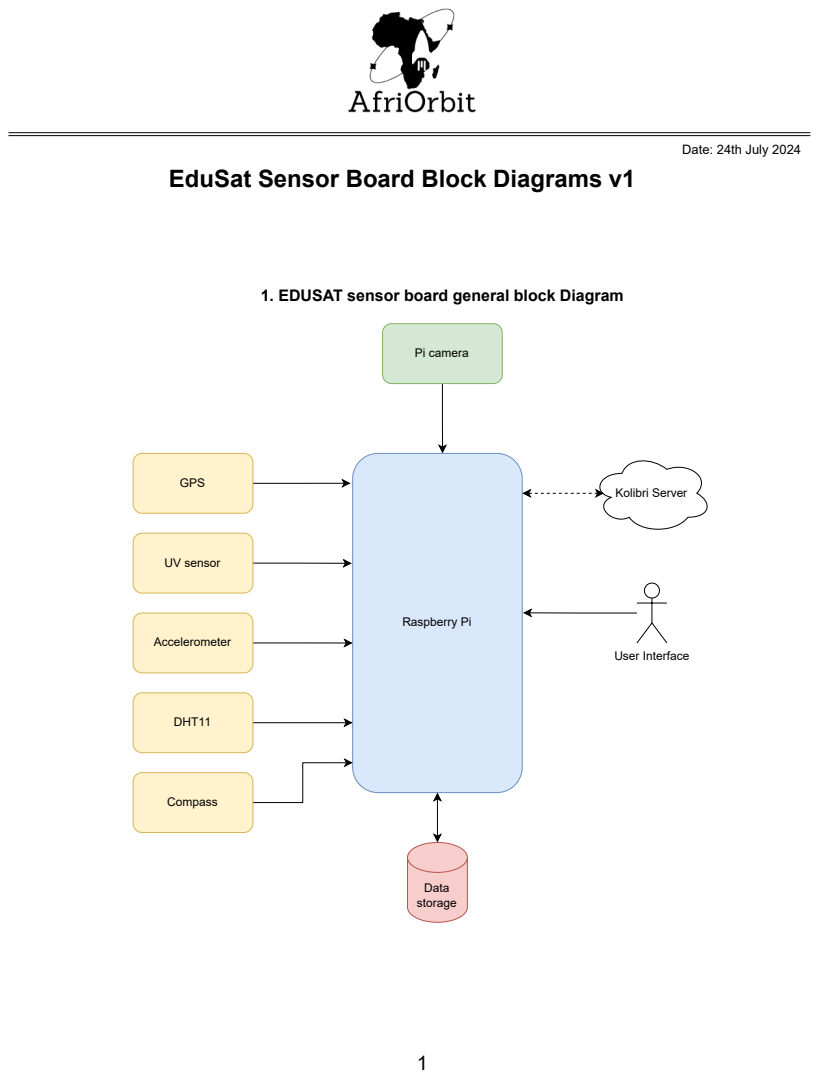
[picture p37: page 1]
Raspberry Pi; Pi camera; GPS; UV sensor; Accelerometer; Kolibri Server; DHT11; Data storage; User Interface; Compass; Date: 24th July 2024

1. EDUSAT sensor board general block Diagram

# 2. Sensor board functional block diagram

5V

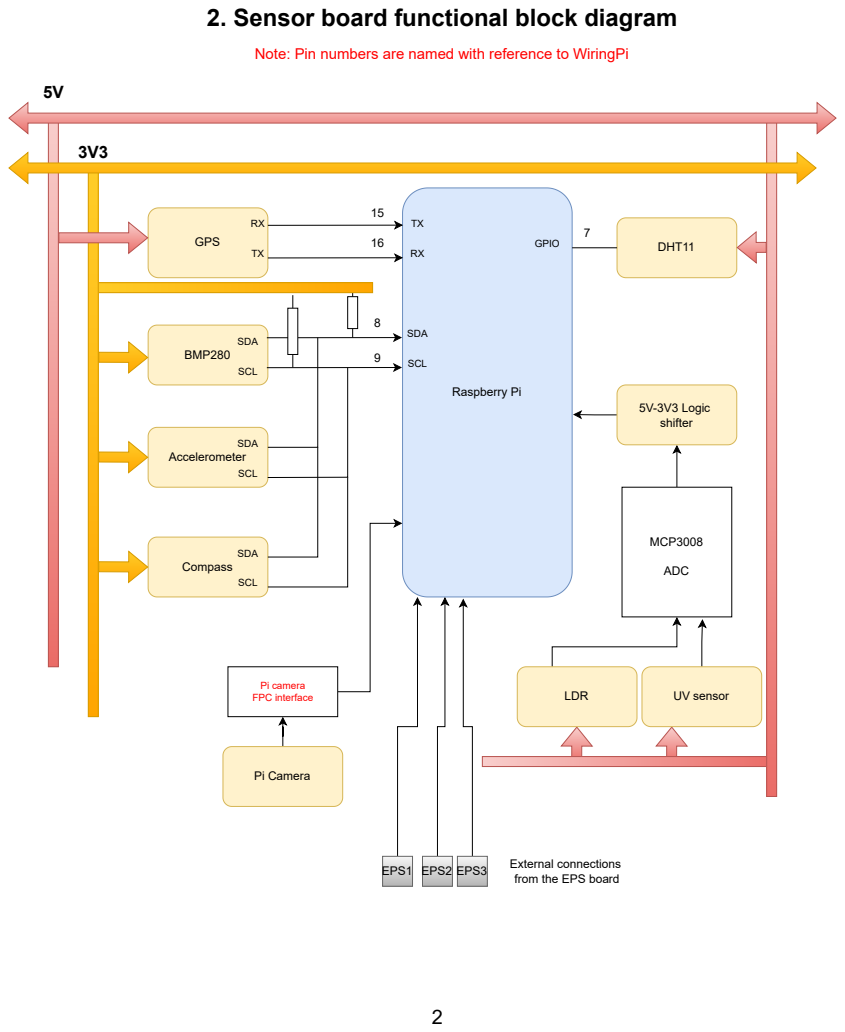
[picture p38: page 2]
BMP280; Raspberry Pi; GPS; Accelerometer; Compass; SDA; SCL; DHT11 GPIO; Pi Camera; Pi camera FPC interface; LDR; MCP3008; ADC; 5V-3V3 Logic shifter; UV sensor; EPS1; EPS2; EPS3; External connections

Note: Pin numbers are named with reference to WiringPi

from the EPS board

## Method 1: Raspberry Pi Mosquitto server

# EduSat sensor-data presentation schemes

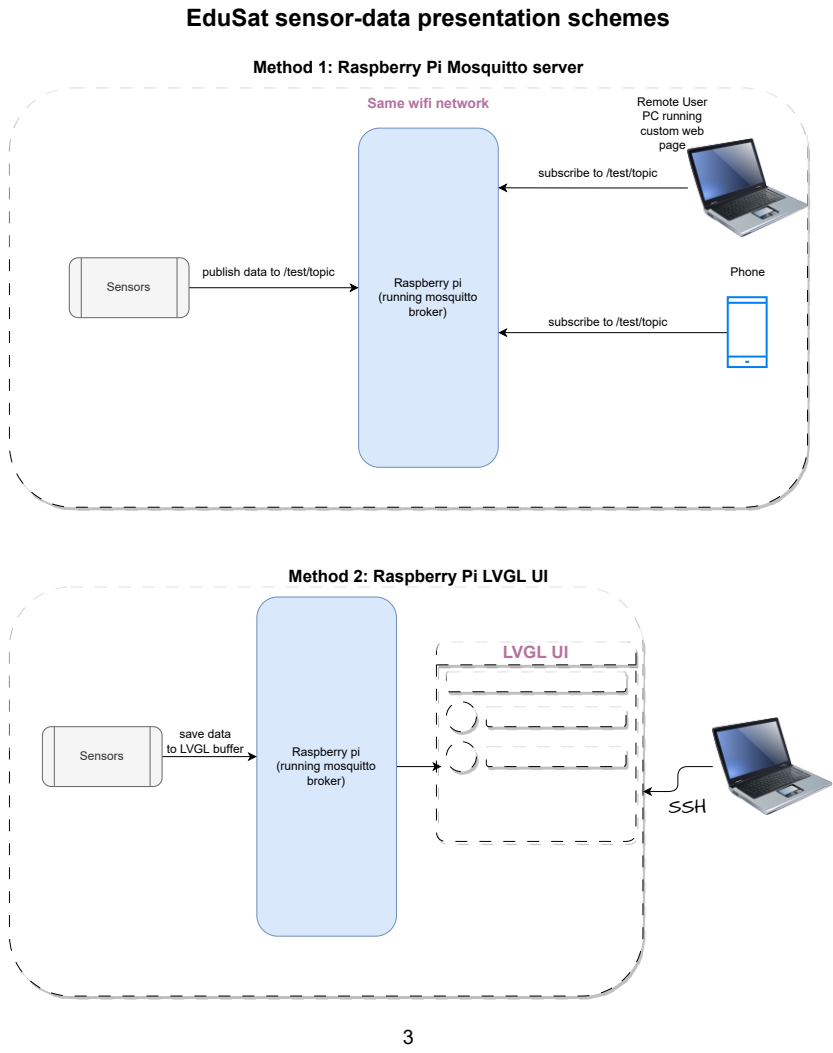
[picture p39: page 3]
Raspberry pi (running mosquitto broker); Sensors; Remote User PC running custom web page; Phone; LVGL UI; SSH

Same wifi network

subscribe to /test/topic

publish data to /test/topic

Method 2: Raspberry Pi LVGL UI

save data
to LVGL buffer
