Meshack-Kinyua/Omarichet_Versionngs/EduSat v1/EPSv2/Project Outputs for EduSAT EPSv2/Top_pads.pdf

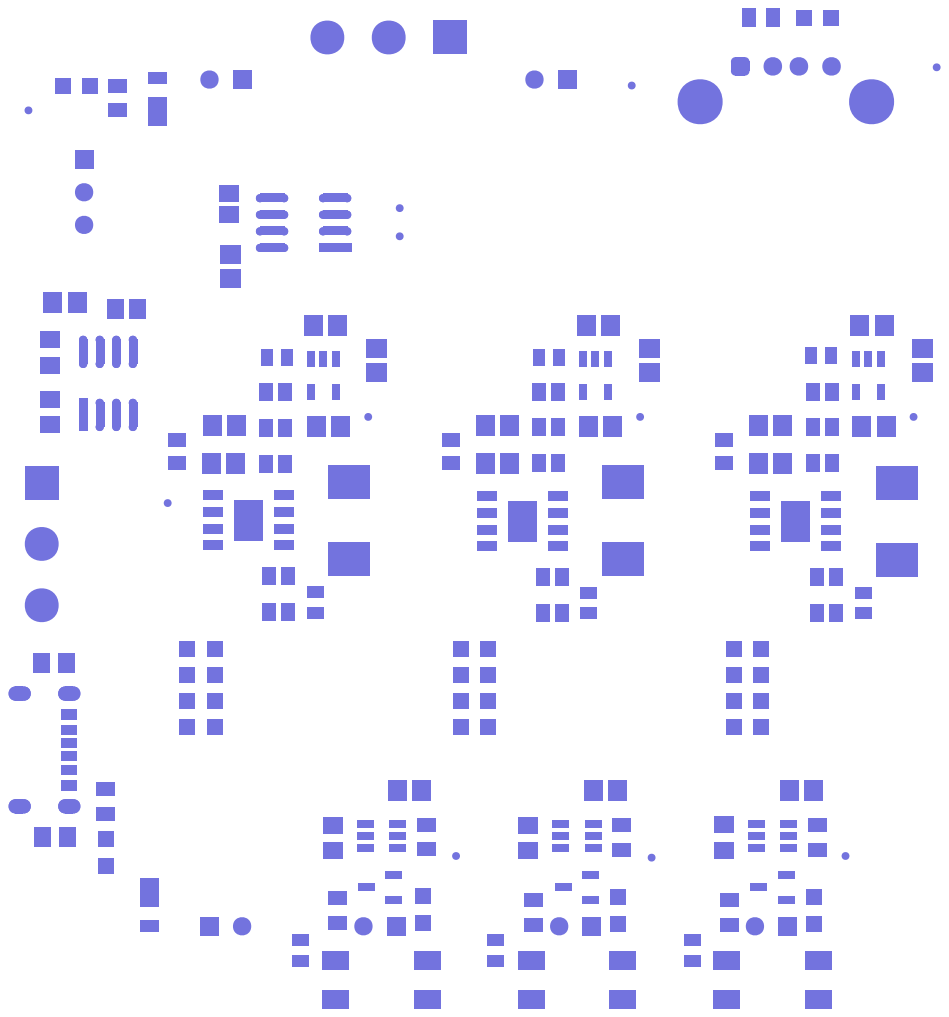
[picture p40: page 1]
