Meshack-Kinyua/Omarichet_Versionngs/(list of files, drawings)

Other design files:
EduSat v1/EPSv2/BatteryConn&Protection.SchDoc
EduSat v1/EPSv2/Charging&1AOut1.SchDoc
EduSat v1/EPSv2/Charging&1AOut2.SchDoc
EduSat v1/EPSv2/Charging&1AOut3.SchDoc
EduSat v1/EPSv2/EduSAT EPSv2.PrjPcb
EduSat v1/EPSv2/EduSAT-EPSv2.SchDoc
EduSat v1/EPSv2/PowerInput&Switch.SchDoc
EduSat v1/EPSv2/PowerOutput&Switch.SchDoc
EduSat v1/SensorBoardv2/EduSAT-Sensor.PrjPcb
EduSat v1/SensorBoardv2/SensorBoard.PcbDoc
EduSat v1/SensorBoardv2/SensorSchem.SchDoc
EduSat v2/EPSv3/Resources/Footprints/LIB_MCS0630-100MN1/MCS0630-100MN1/Altium/INDPM7366X300N.PcbLib
EduSat v2/EPSv3/Resources/Footprints/LIB_MCS0630-100MN1/MCS0630-100MN1/Altium/MCS0630-100MN1.SchLib
EduSat v2/EPSv3/Resources/Footprints/LIB_PTS647SM50SMTR2LFS/PTS647SM50SMTR2LFS/Altium/PTS647SM50SMTR2LFS.PcbLib
EduSat v2/EPSv3/Resources/Footprints/LIB_PTS647SM50SMTR2LFS/PTS647SM50SMTR2LFS/Altium/PTS647SM50SMTR2LFS.SchLib
EduSat v2/EPSv3/Resources/Footprints/LIB_SS-12D10L3/SS-12D10L3/Altium/SS12D10L3.PcbLib
EduSat v2/EPSv3/Resources/Footprints/LIB_SS-12D10L3/SS-12D10L3/Altium/SS-12D10L3.SchLib
