Meshack-Kinyua/Omarichet_Versionngs/EduSat v2/EPSv3/EPSv3.kicad_pcb

## KiCad design EduSat v2/EPSv3/EPSv3.kicad_pcb (2024-11-27)

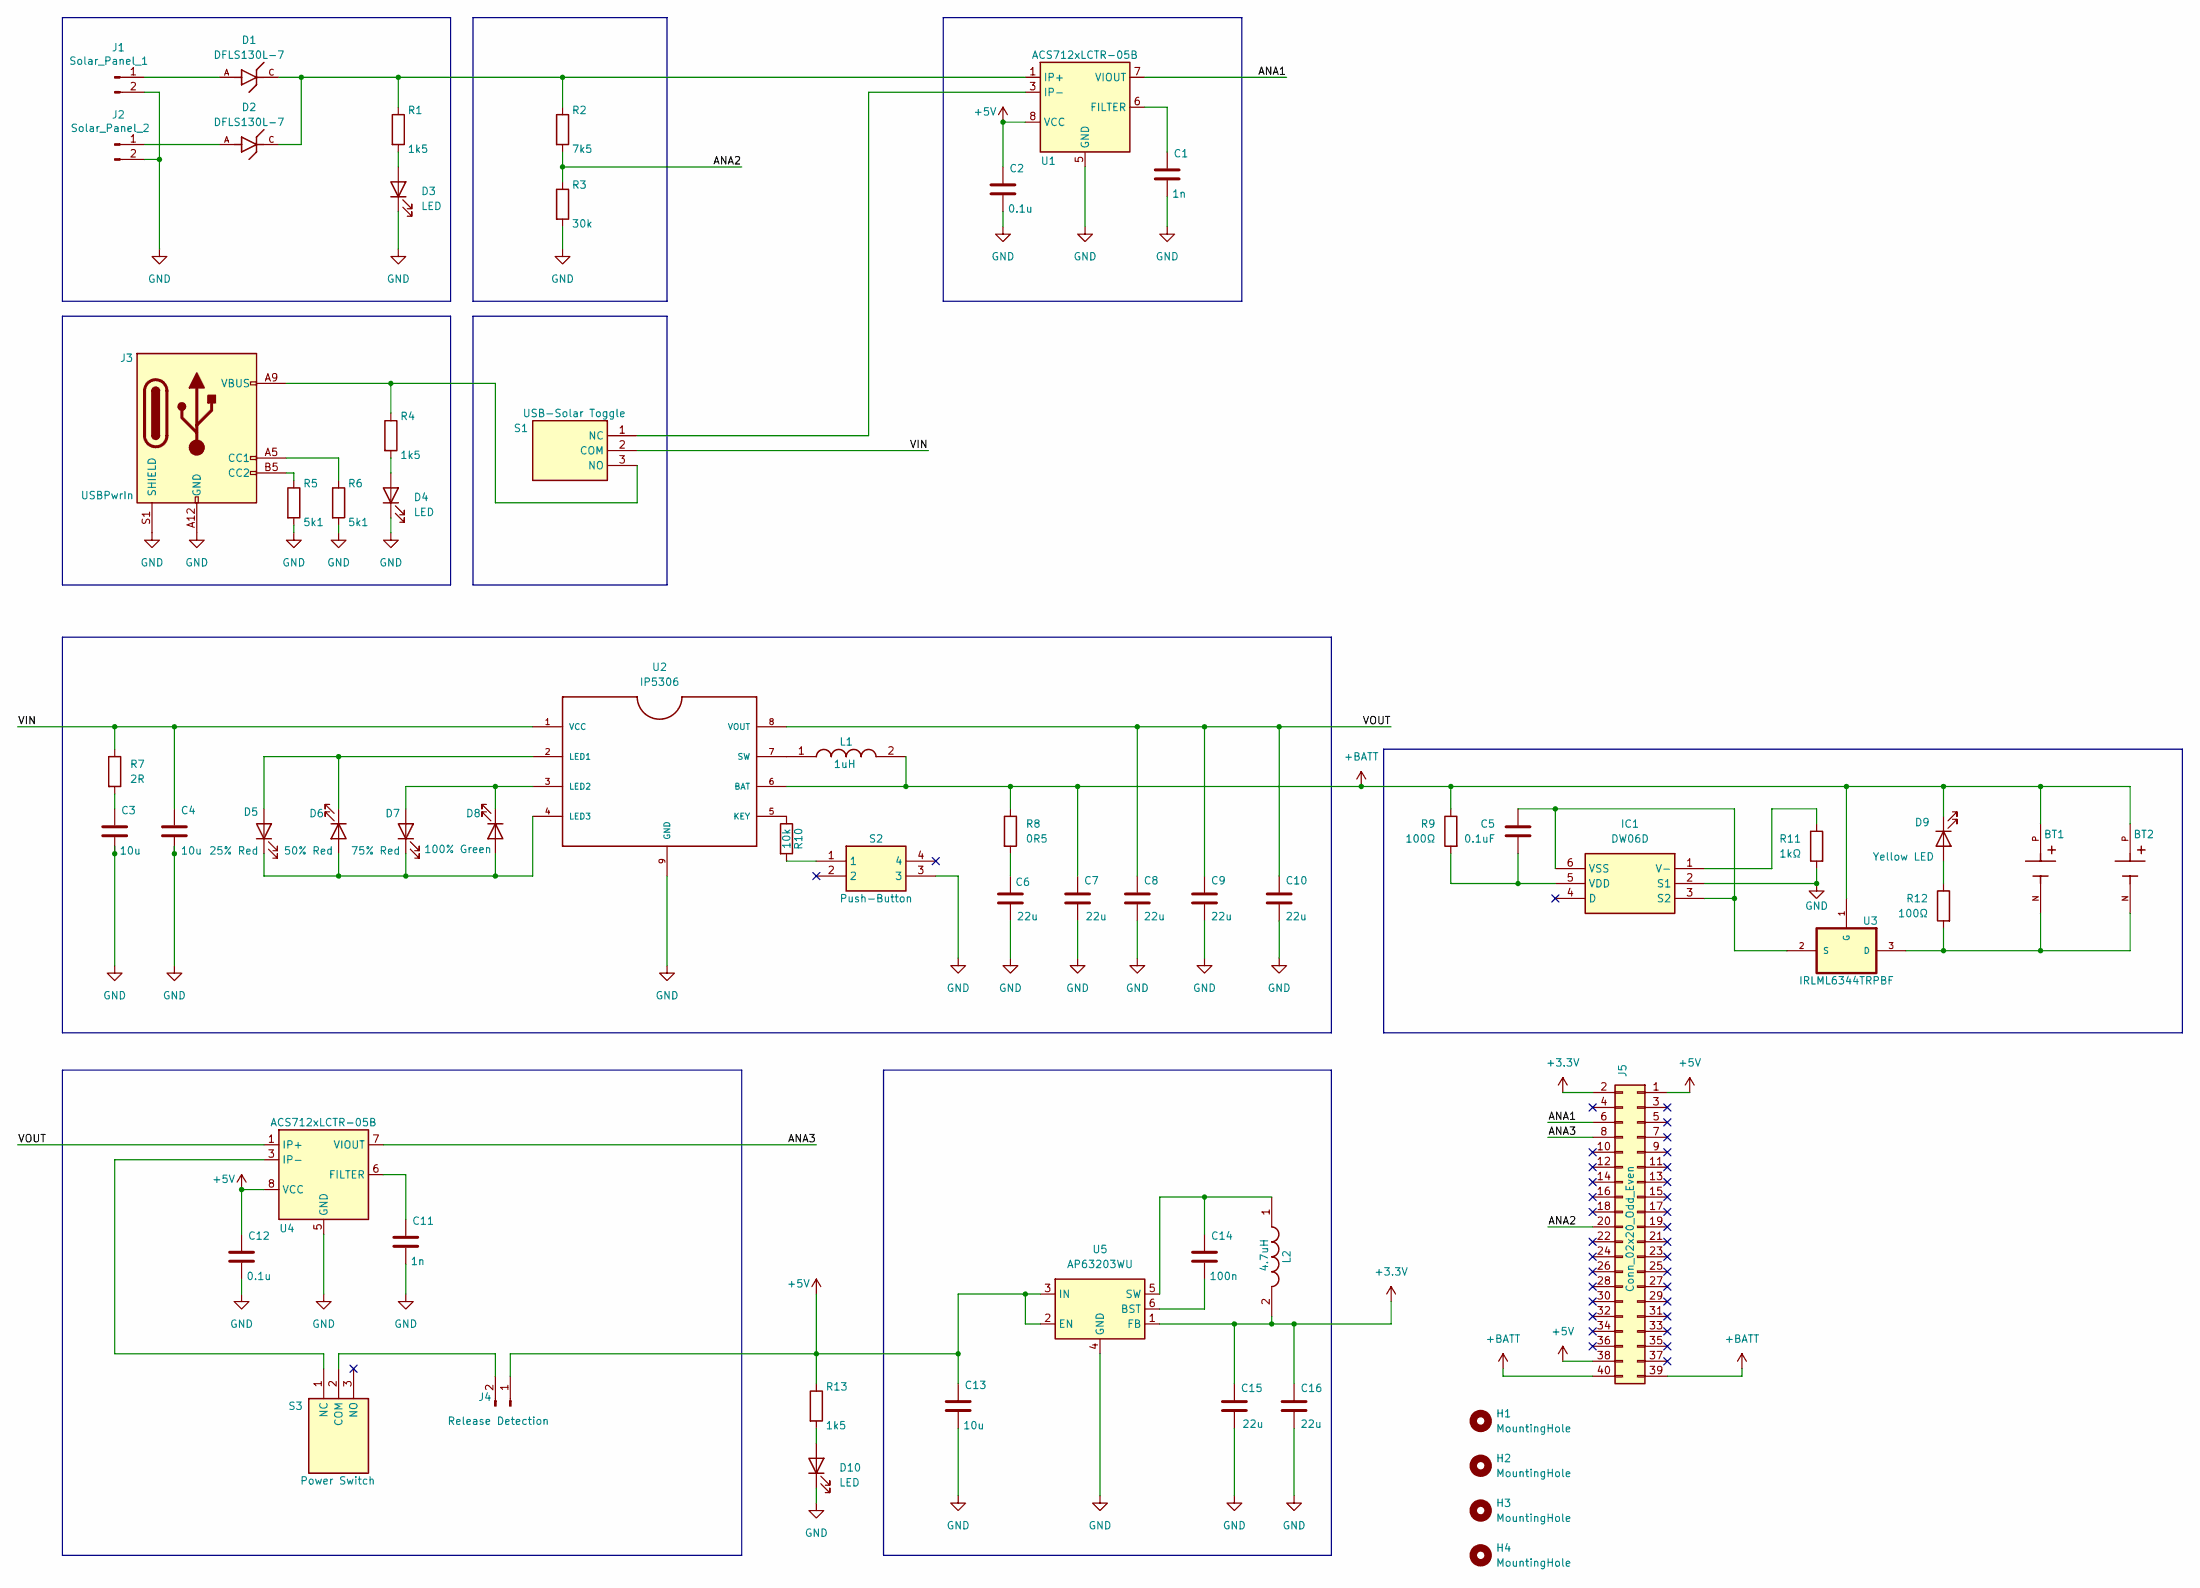
[picture p41: schematic EPSv3.kicad_sch]

Parts:
BT1, BT2: 1043; BAT_1043; PARTREV J
C1, C11: 1n; C_0805_2012Metric_Pad1.18x1.45mm_HandSolder
C2, C12: 0.1u; C_0805_2012Metric_Pad1.18x1.45mm_HandSolder
C3, C4, C13: 10u; C_0805_2012Metric_Pad1.18x1.45mm_HandSolder
C5: 0.1uF; C_0805_2012Metric_Pad1.18x1.45mm_HandSolder
C6, C7, C8, C9, C10, C15, C16: 22u; C_0805_2012Metric_Pad1.18x1.45mm_HandSolder
C14: 100n; C_0805_2012Metric_Pad1.18x1.45mm_HandSolder
D1, D2: DFLS130L-7; DIO_DFLS130L-7; PARTREV 5 - 2
D3, D4, D10: LED; LED_0805_2012Metric_Pad1.15x1.40mm_HandSolder
D5: 25% Red; LED_0805_2012Metric_Pad1.15x1.40mm_HandSolder
D6: 50% Red; LED_0805_2012Metric_Pad1.15x1.40mm_HandSolder
D7: 75% Red; LED_0805_2012Metric_Pad1.15x1.40mm_HandSolder
D8: 100% Green; LED_0805_2012Metric_Pad1.15x1.40mm_HandSolder
D9: Yellow LED; LED_0805_2012Metric_Pad1.15x1.40mm_HandSolder
H1, H2, H3, H4: MountingHole; MountingHole_3.2mm_M3
IC1: DW06D; DW06D_SFE; Manufacturer_Part_Number DW06D
J1: Solar_Panel_1; JST_XH_S2B-XH-A_1x02_P2.50mm_Horizontal
J2: Solar_Panel_2; JST_XH_S2B-XH-A_1x02_P2.50mm_Horizontal
J3: USBPwrIn; USB_C_Receptacle_GCT_USB4125-xx-x_6P_TopMnt_Horizontal
J4: Release Detection; JST_XH_S2B-XH-A_1x02_P2.50mm_Horizontal
J5: Conn_02x20_Odd_Even; PinSocket_2x20_P2.54mm_Vertical
L1: 1uH; INDPM7366X300N; Manufacturer_Part_Number MCS0630-100MN1
L2: 4.7uH; INDPM7366X300N; Manufacturer_Part_Number MCS0630-100MN1
R1, R4, R13: 1k5; R_0805_2012Metric_Pad1.20x1.40mm_HandSolder
R2: 7k5; R_0805_2012Metric_Pad1.20x1.40mm_HandSolder
R3: 30k; R_0805_2012Metric_Pad1.20x1.40mm_HandSolder
R5, R6: 5k1; R_0805_2012Metric_Pad1.20x1.40mm_HandSolder
R7: 2R; R_0805_2012Metric_Pad1.20x1.40mm_HandSolder
R8: 0R5; R_0805_2012Metric_Pad1.20x1.40mm_HandSolder
R9, R12: 100Ω; R_0805_2012Metric_Pad1.20x1.40mm_HandSolder
R10: 10k; R_0805_2012Metric_Pad1.20x1.40mm_HandSolder
R11: 1kΩ; R_0805_2012Metric_Pad1.20x1.40mm_HandSolder
S1: USB-Solar Toggle; SS12D10L3; Manufacturer_Part_Number SS-12D10L3
S2: Push-Button; PTS647SM50SMTR2LFS; Manufacturer_Part_Number PTS647SM50SMTR2LFS; Mouser Part Number 611-PTS647SM50SMTR2L
S3: Power Switch; SS12D10L3; Manufacturer_Part_Number SS-12D10L3
U1, U4: ACS712xLCTR-05B; SOIC-8_3.9x4.9mm_P1.27mm
U2: IP5306; SOIC9P127_490X600X170L84X42T330X241N
U3: IRLML6344TRPBF; SOT95P240X112-3N; MPN IRLML6344TRPBF
U5: AP63203WU; TSOT-23-6

Connections:
+3.3V: C15.1, C16.1, J5.2, L2.2, U5.1 (FB)
+5V: C2.1, C12.1, C13.1, J4.1, J5.1, J5.38, R13.1, U1.8 (VCC), U4.8 (VCC), U5.2 (EN), U5.3 (IN)
+BATT: BT1.P, BT2.P, C7.1, D9.1 (K), J5.39, J5.40, L1.2, R8.1, R9.1, U2.6 (BAT), U3.1 (G)
/ANA1: J5.6, U1.7 (VIOUT)
/ANA2: J5.20, R2.2, R3.1
/ANA3: J5.8, U4.7 (VIOUT)
/VIN: C4.1, R7.1, S1.2 (COM), U2.1 (VCC)
/VOUT: C8.1, C9.1, C10.1, U2.8 (VOUT), U4.1 (IP+), U4.2 (IP+)
GND: C1.2, C2.2, C3.2, C4.2, C6.2, C7.2, C8.2, C9.2, C10.2, C11.2, C12.2, C13.2, C15.2, C16.2, D3.1 (K), D4.1 (K), D10.1 (K), IC1.2 (S1), J1.2, J2.2, J3.A12 (GND), J3.B12 (GND), J3.S1 (SHIELD), R3.2, R5.2, R6.2, R11.2, S2.3, U1.5 (GND), U2.9 (GND), U4.5 (GND), U5.4 (GND)
unnamed: C3.1, R7.2
unnamed: C6.1, R8.2
unnamed: D1.C, D2.C, R1.1, R2.1, U1.1 (IP+), U1.2 (IP+)
unnamed: D3.2 (A), R1.2
unnamed: D4.2 (A), R4.2
unnamed: D5.2 (A), D6.1 (K), U2.2 (LED1)
unnamed: D5.1 (K), D6.2 (A), D7.1 (K), D8.2 (A), U2.4 (LED3)
unnamed: D7.2 (A), D8.1 (K), U2.3 (LED2)
unnamed: D9.2 (A), R12.1
unnamed: D10.2 (A), R13.2
unnamed: C5.1, IC1.3 (S2), IC1.6 (VSS), U3.2 (S)
unnamed: IC1.1 (V-), R11.1
unnamed: C5.2, IC1.5 (VDD), R9.2
unnamed: D1.A, J1.1
unnamed: D2.A, J2.1
unnamed: J3.A5 (CC1), R6.1
unnamed: J3.B5 (CC2), R5.1
unnamed: J4.2, S3.2 (COM)
unnamed: R10.2, S2.1
unnamed: S1.1 (NC), U1.3 (IP-), U1.4 (IP-)
unnamed: J3.A9 (VBUS), J3.B9 (VBUS), R4.1, S1.3 (NO)
unnamed: S3.1 (NC), U4.3 (IP-), U4.4 (IP-)
unnamed: C1.1, U1.6 (FILTER)
unnamed: R10.1, U2.5 (KEY)
unnamed: L1.1, U2.7 (SW)
unnamed: BT1.N, BT2.N, R12.2, U3.3 (D)
unnamed: C11.1, U4.6 (FILTER)
unnamed: C14.2, U5.6 (BST)
unnamed: C14.1, L2.1, U5.5 (SW)

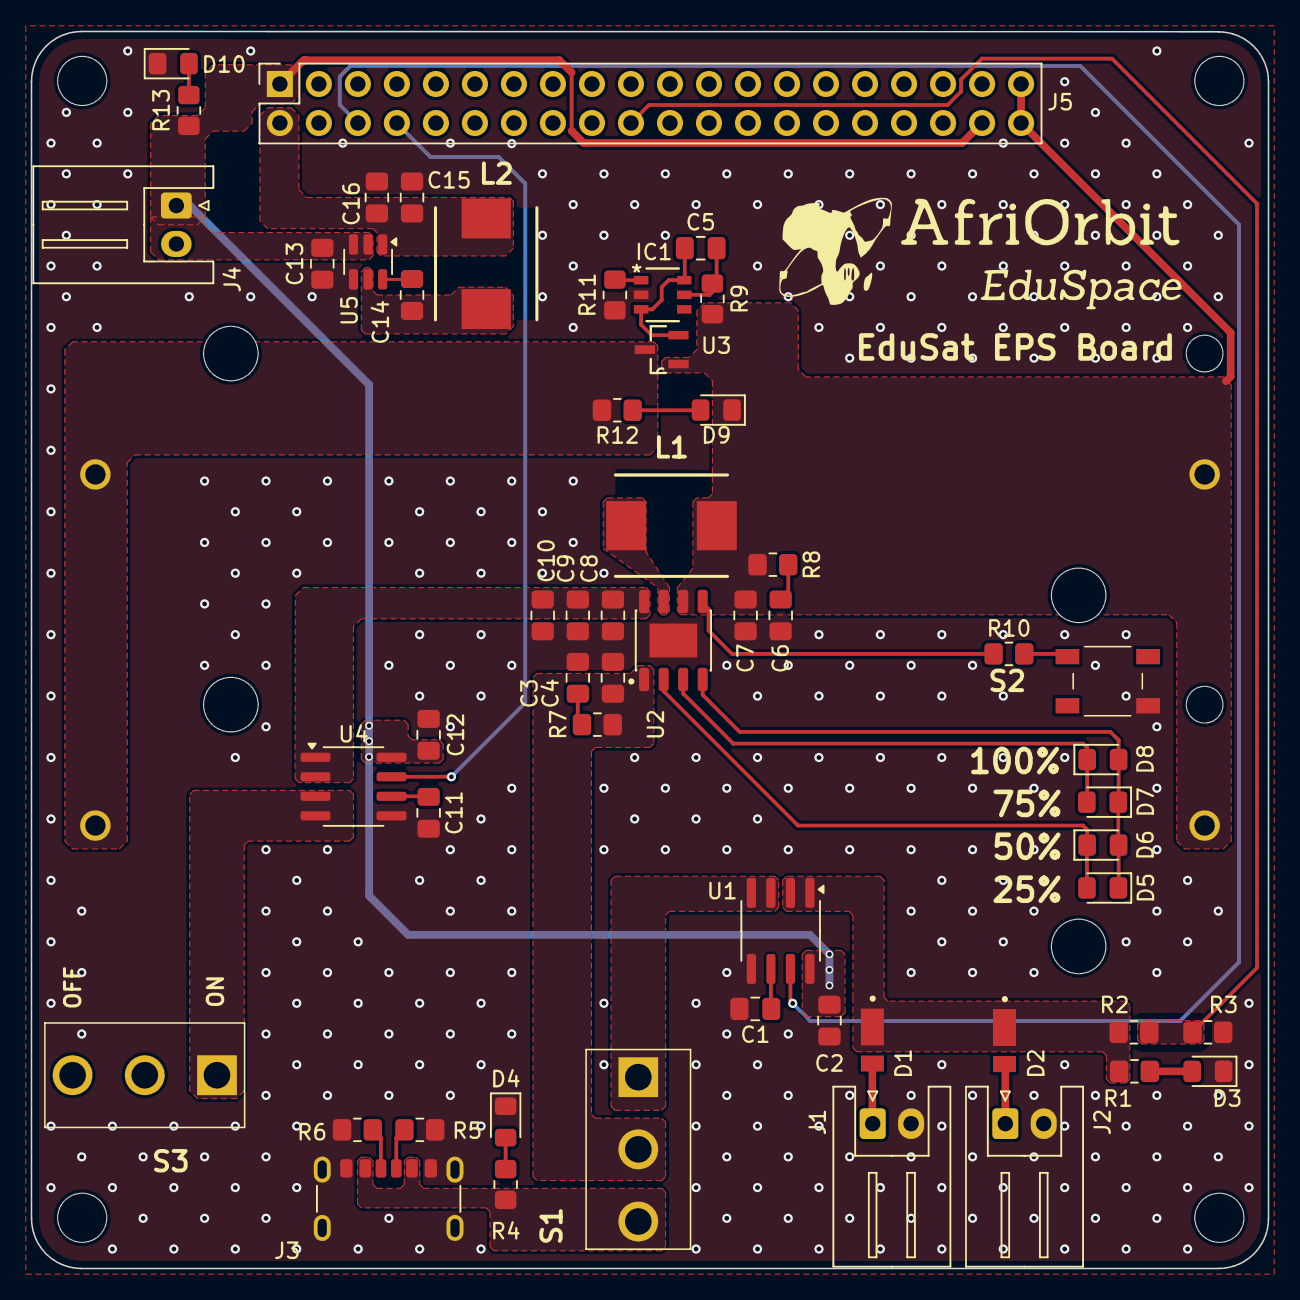
[picture p42: board EPSv3.kicad_pcb from above]

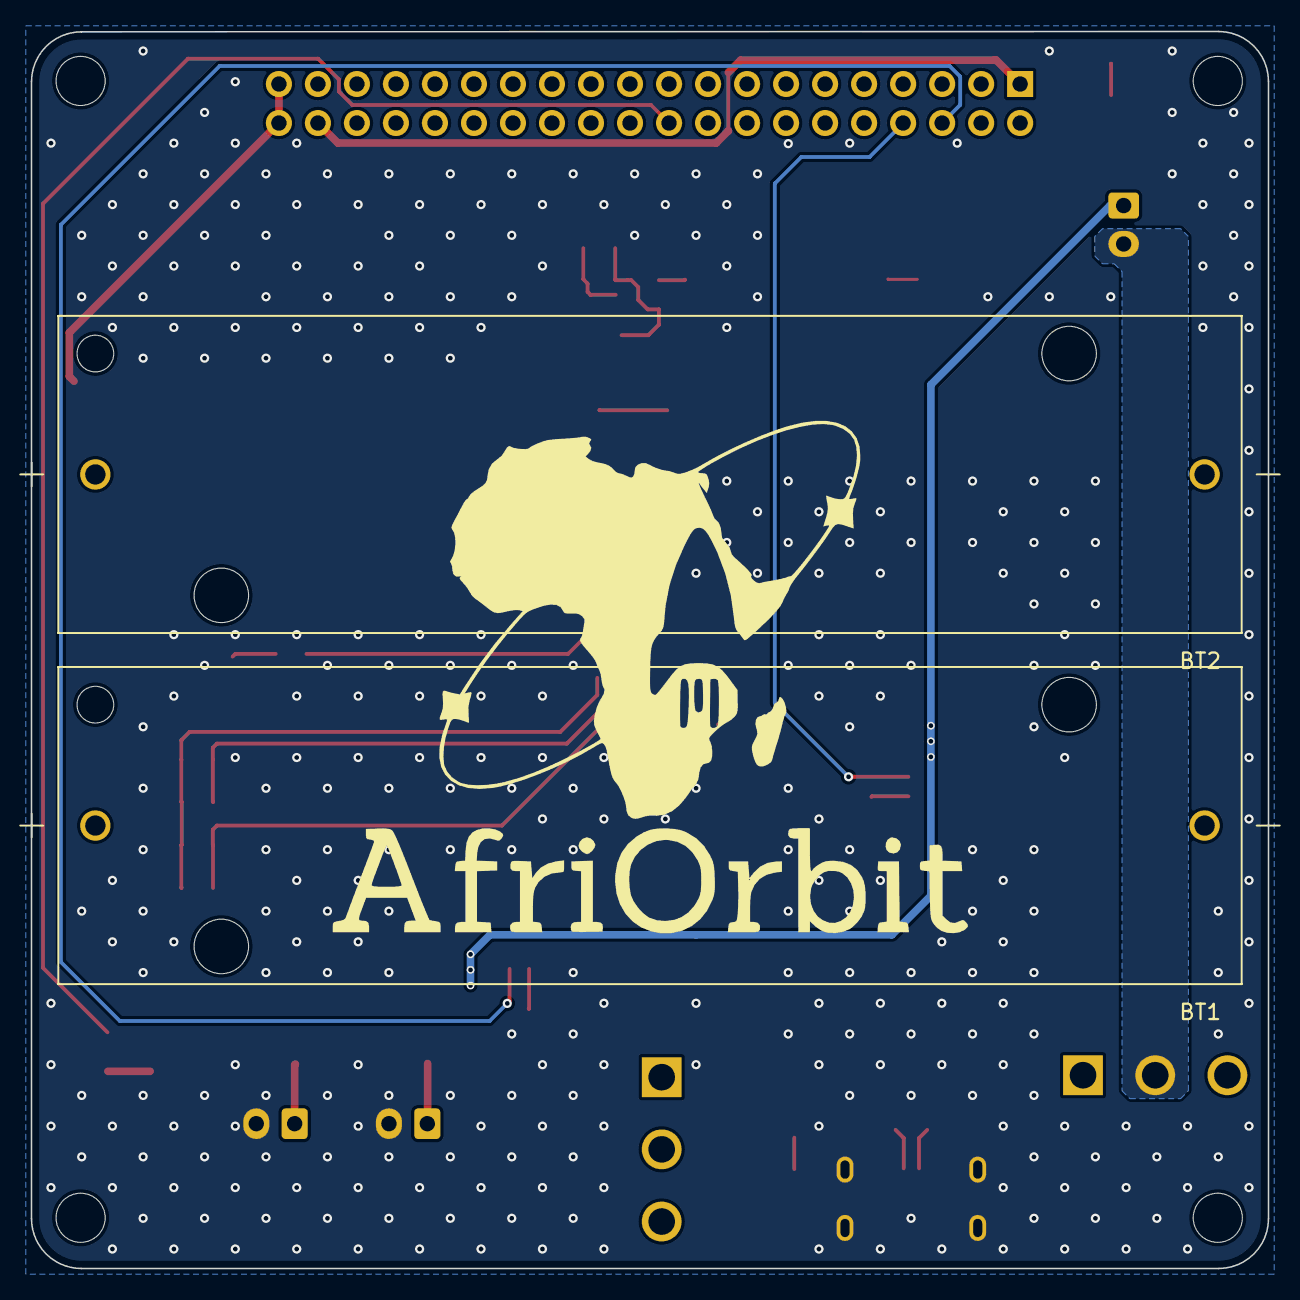
[picture p43: board EPSv3.kicad_pcb from below]

Board: 2 copper layers, 80.5 x 80.5 mm, 61 parts (2 on the bottom side), 38 nets.
