Meshack-Kinyua/Omarichet_Versionngs/EduSat v2/OBCv1/OBCv1.kicad_pcb

## KiCad design EduSat v2/OBCv1/OBCv1.kicad_pcb (2024-11-27)

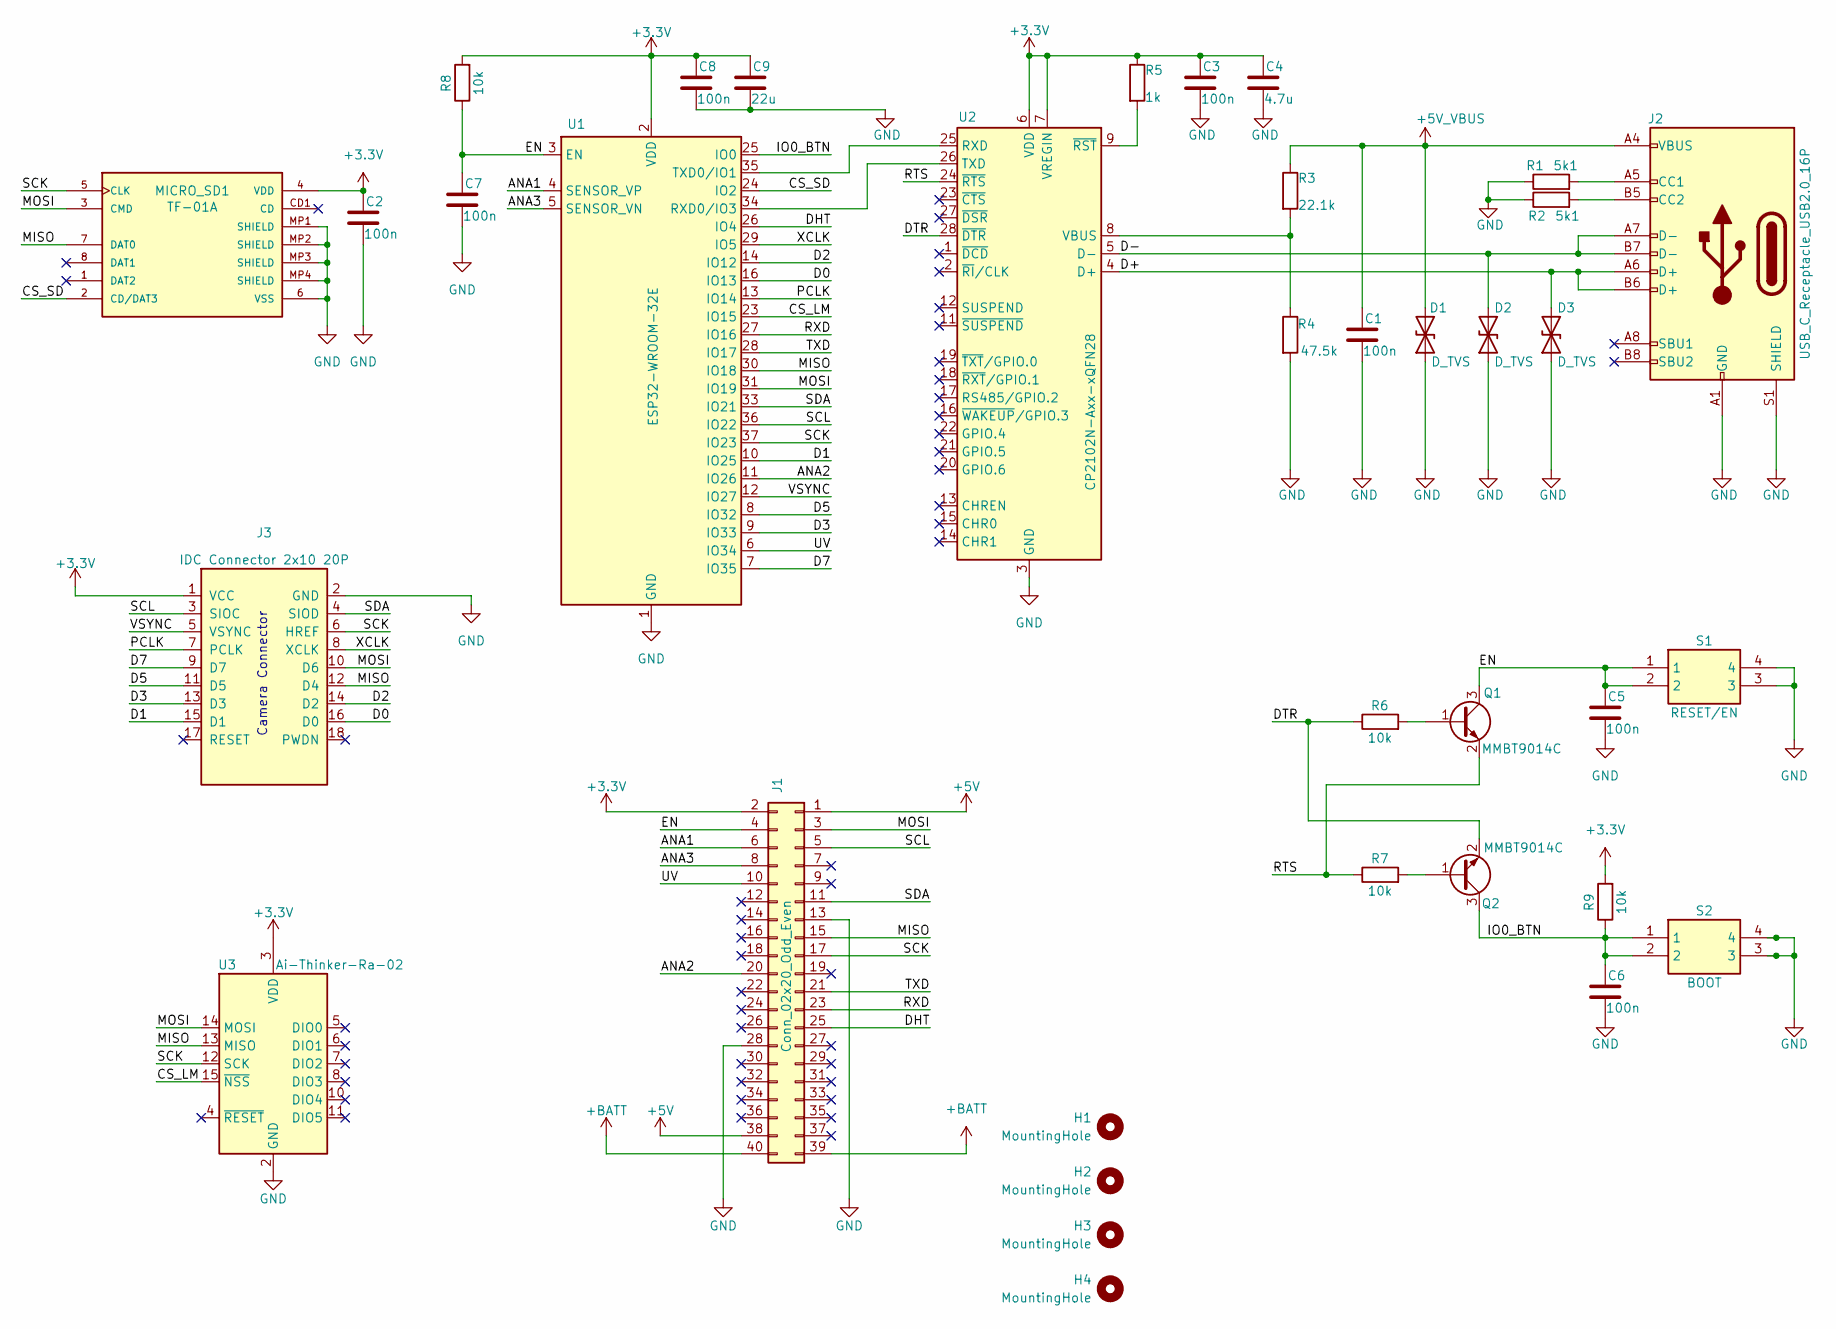
[picture p44: schematic OBCv1.kicad_sch, EduSat OBC & Communications Board]

Parts:
C1, C2, C3, C5, C6, C7, C8: 100n; C_0805_2012Metric
C4: 4.7u; C_0805_2012Metric
C9: 22u; C_0805_2012Metric
D1, D2, D3: D_TVS; D_0603_1608Metric
H1, H2, H3, H4: MountingHole; MountingHole_3.2mm_M3
J1: Conn_02x20_Odd_Even; PinSocket_2x20_P2.54mm_Vertical
J2: USB_C_Receptacle_USB2.0_16P; USB_C_Receptacle_XKB_U262-16XN-4BVC11
J3: IDC Connector 2x10 20P; IDC-Header_2x10_P2.54mm_Horizontal
MICRO_SD1: TF-01A
Q1, Q2: MMBT9014C; SOT-23
R1, R2: 5k1; R_0805_2012Metric
R3: 22.1k; R_0805_2012Metric_Pad1.20x1.40mm_HandSolder
R4: 47.5k; R_0805_2012Metric_Pad1.20x1.40mm_HandSolder
R5: 1k; R_0805_2012Metric_Pad1.20x1.40mm_HandSolder
R6, R7, R8, R9: 10k; R_0805_2012Metric_Pad1.20x1.40mm_HandSolder
S1: RESET/EN; PTS647SM50SMTR2LFS; Manufacturer_Part_Number PTS647SM50SMTR2LFS; Mouser Part Number 611-PTS647SM50SMTR2L
S2: BOOT; PTS647SM50SMTR2LFS; Manufacturer_Part_Number PTS647SM50SMTR2LFS; Mouser Part Number 611-PTS647SM50SMTR2L
U1: ESP32-WROOM-32E; ESP32-WROOM-32D
U2: CP2102N-Axx-xQFN28; QFN-28-1EP_5x5mm_P0.5mm_EP3.35x3.35mm
U3: Ai-Thinker-Ra-02; Ai-Thinker-Ra-01-LoRa

Connections:
+3.3V: C2.1, C3.1, C4.1, C8.1, C9.1, J1.2, J3.1 (VCC), MICRO_SD1.4 (VDD), R5.1, R8.2, R9.2, U1.2 (VDD), U2.6 (VDD), U2.7 (VREGIN), U3.3 (VDD)
+5V: J1.1, J1.38
+5V_VBUS: C1.1, D1.2 (A2), J2.A4 (VBUS), J2.A9 (VBUS), J2.B4 (VBUS), J2.B9 (VBUS), R3.1
+BATT: J1.39, J1.40
/ANA1: J1.6, U1.4 (SENSOR_VP)
/ANA2: J1.20, U1.11 (IO26)
/ANA3: J1.8, U1.5 (SENSOR_VN)
/CS_LM: U1.23 (IO15), U3.15 (~NSS)
/CS_SD: MICRO_SD1.2 (CD/DAT3), U1.24 (IO2)
/D0: J3.16 (D0), U1.16 (IO13)
/D1: J3.15 (D1), U1.10 (IO25)
/D2: J3.14 (D2), U1.14 (IO12)
/D3: J3.13 (D3), U1.9 (IO33)
/D5: J3.11 (D5), U1.8 (IO32)
/D7: J3.9 (D7), U1.7 (IO35)
/D+: D3.2 (A2), J2.A6 (D+), J2.B6 (D+), U2.4 (D+)
/D-: D2.2 (A2), J2.A7 (D-), J2.B7 (D-), U2.5 (D-)
/DHT: J1.25, U1.26 (IO4)
/DTR: Q2.2 (E), R6.1, U2.28 (~DTR)
/EN: C5.1, C7.1, J1.4, Q1.3 (C), R8.1, S1.1, S1.2, U1.3 (EN)
/IO0_BTN: C6.1, Q2.3 (C), R9.1, S2.1, S2.2, U1.25 (IO0)
/MISO: J1.15, J3.12 (D4), MICRO_SD1.7 (DAT0), U1.30 (IO18), U3.13 (MISO)
/MOSI: J1.3, J3.10 (D6), MICRO_SD1.3 (CMD), U1.31 (IO19), U3.14 (MOSI)
/PCLK: J3.7 (PCLK), U1.13 (IO14)
/RTS: Q1.2 (E), R7.1, U2.24 (~RTS)
/RXD: J1.23, U1.27 (IO16)
/SCK: J1.17, J3.6 (HREF), MICRO_SD1.5 (CLK), U1.37 (IO23), U3.12 (SCK)
/SCL: J1.5, J3.3 (SIOC), U1.36 (IO22)
/SDA: J1.11, J3.4 (SIOD), U1.33 (IO21)
/TXD: J1.21, U1.28 (IO17)
/UV: J1.10, U1.6 (IO34)
/VSYNC: J3.5 (VSYNC), U1.12 (IO27)
/XCLK: J3.8 (XCLK), U1.29 (IO5)
GND: C1.2, C2.2, C3.2, C4.2, C5.2, C6.2, C7.2, C8.2, C9.2, D1.1 (A1), D2.1 (A1), D3.1 (A1), J1.13, J1.28, J2.A1 (GND), J2.A12 (GND), J2.B1 (GND), J2.B12 (GND), J2.S1 (SHIELD), J3.2 (GND), MICRO_SD1.6 (VSS), MICRO_SD1.MP1 (SHIELD), MICRO_SD1.MP2 (SHIELD), MICRO_SD1.MP3 (SHIELD), MICRO_SD1.MP4 (SHIELD), R1.1, R2.1, R4.2, S1.3, S1.4, S2.3, S2.4, U1.1 (GND), U1.15 (GND), U1.38 (GND), U1.39 (GND), U2.3 (GND), U2.29 (GND), U3.1 (GND), U3.2 (GND), U3.9 (GND), U3.16 (GND)
unnamed: J2.A5 (CC1), R1.2
unnamed: J2.B5 (CC2), R2.2
unnamed: Q1.1 (B), R6.2
unnamed: Q2.1 (B), R7.2
unnamed: U1.34 (RXD0/IO3), U2.26 (TXD)
unnamed: U1.35 (TXD0/IO1), U2.25 (RXD)
unnamed: R3.2, R4.1, U2.8 (VBUS)
unnamed: R5.2, U2.9 (~RST)

Notes on the sheet:
Camera Connector

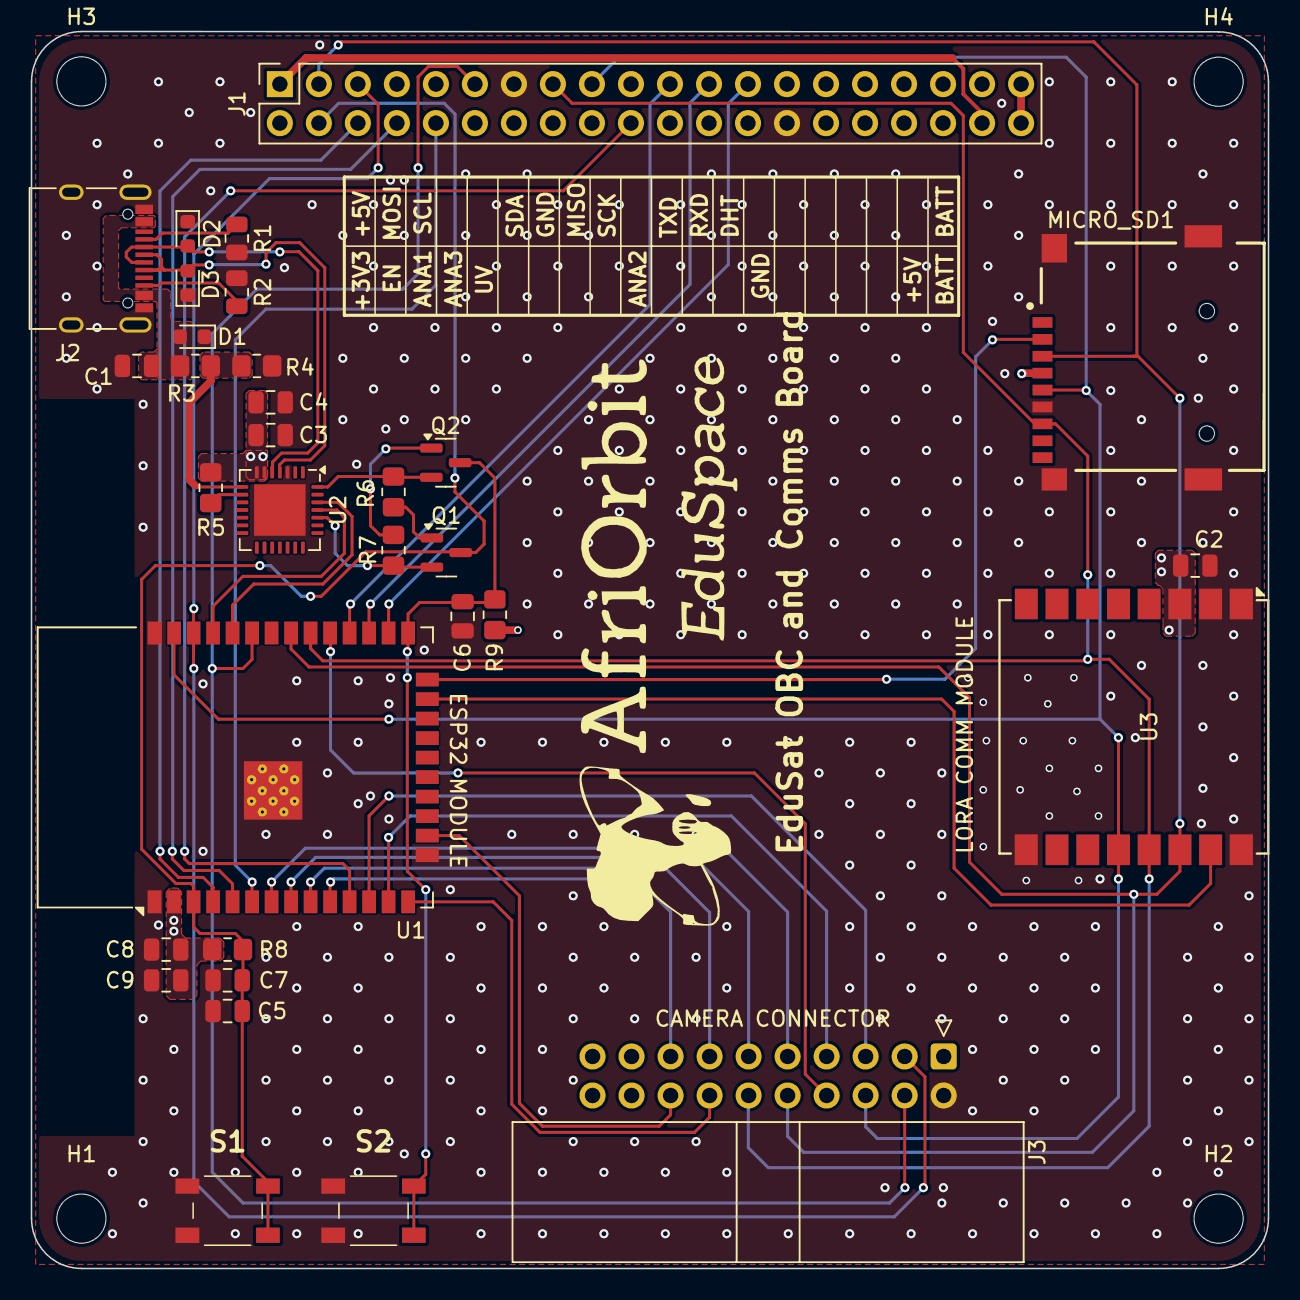
[picture p45: board OBCv1.kicad_pcb from above]

Board: 4 copper layers, 80.5 x 80.5 mm, 36 parts (0 on the bottom side), 42 nets.
