Meshack-Kinyua/Omarichet_Versionngs/Omarichet EduSat/Electrical/PCB designs/Omarichet Sensor Shield v1.4/Omarichet Sensor Shield 1.3.kicad_pcb

## KiCad design Omarichet EduSat/Electrical/PCB designs/Omarichet Sensor Shield v1.4/Omarichet Sensor Shield 1.3.kicad_pcb (2024-07-20, an earlier design)

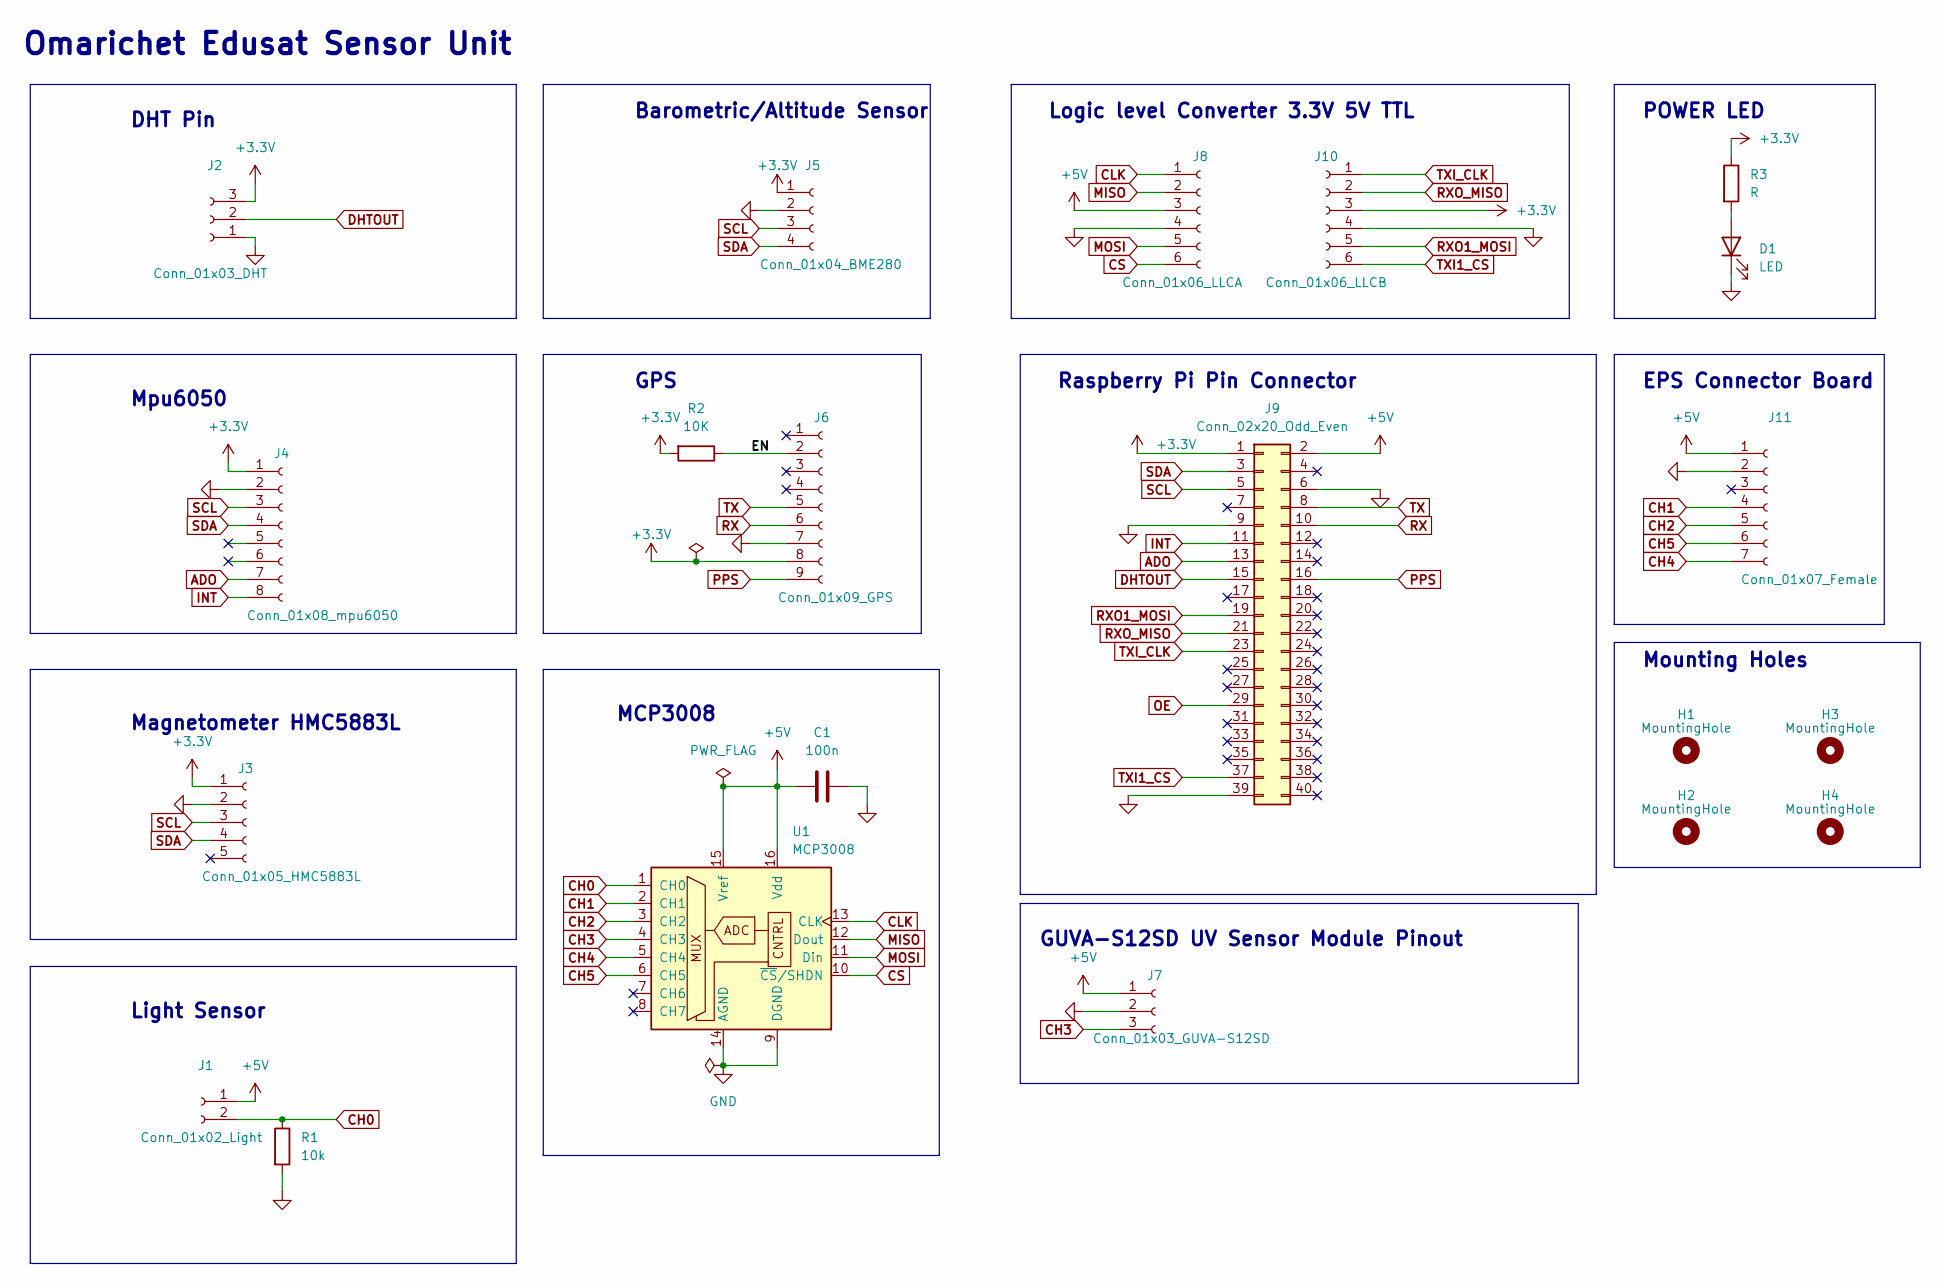
[picture p46: schematic Omarichet Sensor Shield 1.3.kicad_sch, Edusat Sensor Unit]

Parts:
C1: 100n; C_0805_2012Metric
D1: LED; LED_0805_2012Metric
H1, H2, H3, H4: MountingHole; MountingHole_3.2mm_M3
J1: Conn_01x02_Light; PinSocket_1x02_P2.54mm_Vertical
J2: Conn_01x03_DHT; PinSocket_1x03_P2.54mm_Vertical
J3: Conn_01x05_HMC5883L; PinSocket_1x05_P2.54mm_Vertical
J4: Conn_01x08_mpu6050; PinSocket_1x08_P2.54mm_Vertical
J5: Conn_01x04_BME280; PinSocket_1x04_P2.54mm_Vertical
J6: Conn_01x09_GPS; PinSocket_1x09_P2.54mm_Vertical
J7: Conn_01x03_GUVA-S12SD; PinSocket_1x03_P2.54mm_Vertical
J8: Conn_01x06_LLCA; PinSocket_1x06_P2.54mm_Vertical
J9: Conn_02x20_Odd_Even; PinSocket_2x20_P2.54mm_Vertical
J10: Conn_01x06_LLCB; PinSocket_1x06_P2.54mm_Vertical
J11: Conn_01x07_Female; PinSocket_1x07_P2.54mm_Vertical
R1: 10k; R_0603_1608Metric
R2: 10K; R_0603_1608Metric
R3: R; R_0603_1608Metric
U1: MCP3008; DIP-16_W7.62mm

Connections:
+3.3V: J2.3, J3.1, J4.1, J5.1, J6.8, J9.1, J10.3, R2.2, R3.1
+5V: C1.1, J1.1, J7.1, J8.3, J9.2, J11.1, U1.15 (Vref), U1.16 (Vdd)
/EN: J6.2, R2.1
ADO: J4.7, J9.13
CH0: J1.2, R1.1, U1.1 (CH0)
CH1: J11.4, U1.2 (CH1)
CH2: J11.5, U1.3 (CH2)
CH3: J7.3, U1.4 (CH3)
CH4: J11.7, U1.5 (CH4)
CH5: J11.6, U1.6 (CH5)
CLK: J8.1, U1.13 (CLK)
CS: J8.6, U1.10 (~CS/SHDN)
DHTOUT: J2.2, J9.15
GND: C1.2, D1.1 (K), J2.1, J3.2, J4.2, J5.2, J6.7, J7.2, J8.4, J9.6, J9.9, J9.39, J10.4, J11.2, R1.2, U1.9 (DGND), U1.14 (AGND)
INT: J4.8, J9.11
MISO: J8.2, U1.12 (Dout)
MOSI: J8.5, U1.11 (Din)
unnamed: D1.2 (A), R3.2
OE: J9.29
PPS: J6.9, J9.16
RX: J6.6, J9.10
RXO1_MOSI: J9.19, J10.5
RXO_MISO: J9.21, J10.2
SCL: J3.3, J4.3, J5.3, J9.5
SDA: J3.4, J4.4, J5.4, J9.3
TX: J6.5, J9.8
TXI1_CS: J9.37, J10.6
TXI_CLK: J9.23, J10.1

Notes on the sheet:
Light Sensor
Omarichet Edusat Sensor Unit
GUVA-S12SD UV Sensor Module Pinout
POWER LED
GPS
MCP3008
Barometric/Altitude Sensor
Mpu6050
Raspberry Pi Pin Connector
Logic level Converter 3.3V 5V TTL
Magnetometer HMC5883L
EPS Connector Board
Mounting Holes
DHT Pin

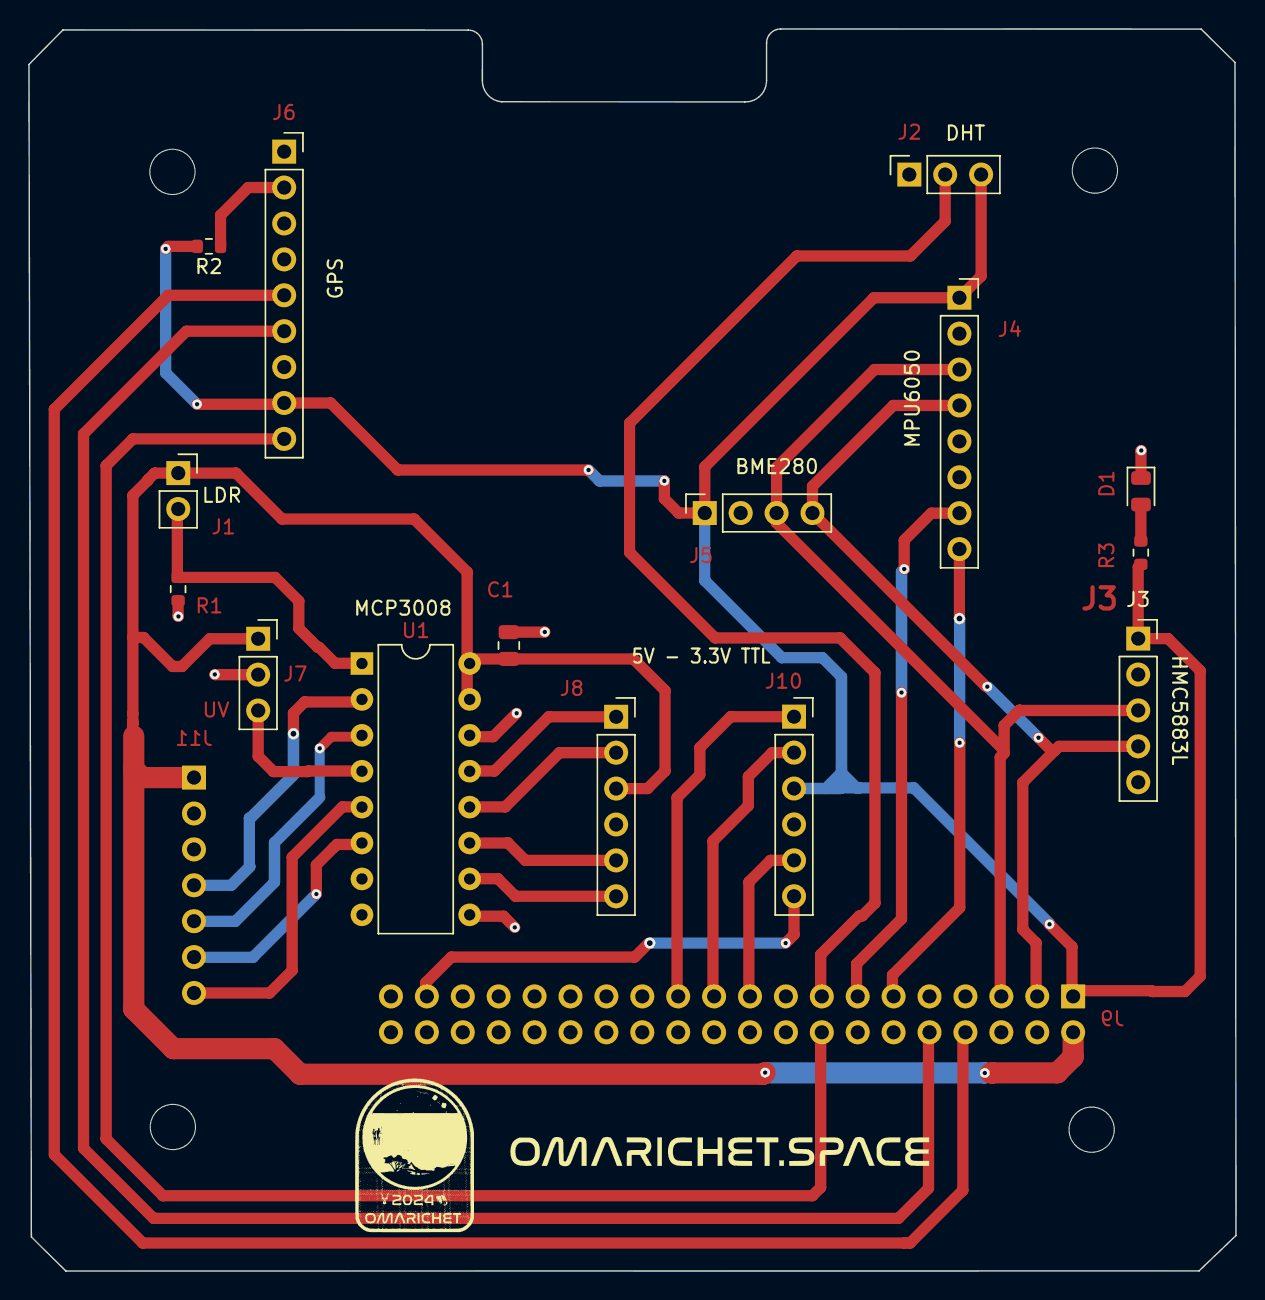
[picture p47: board Omarichet Sensor Shield 1.3.kicad_pcb from above]

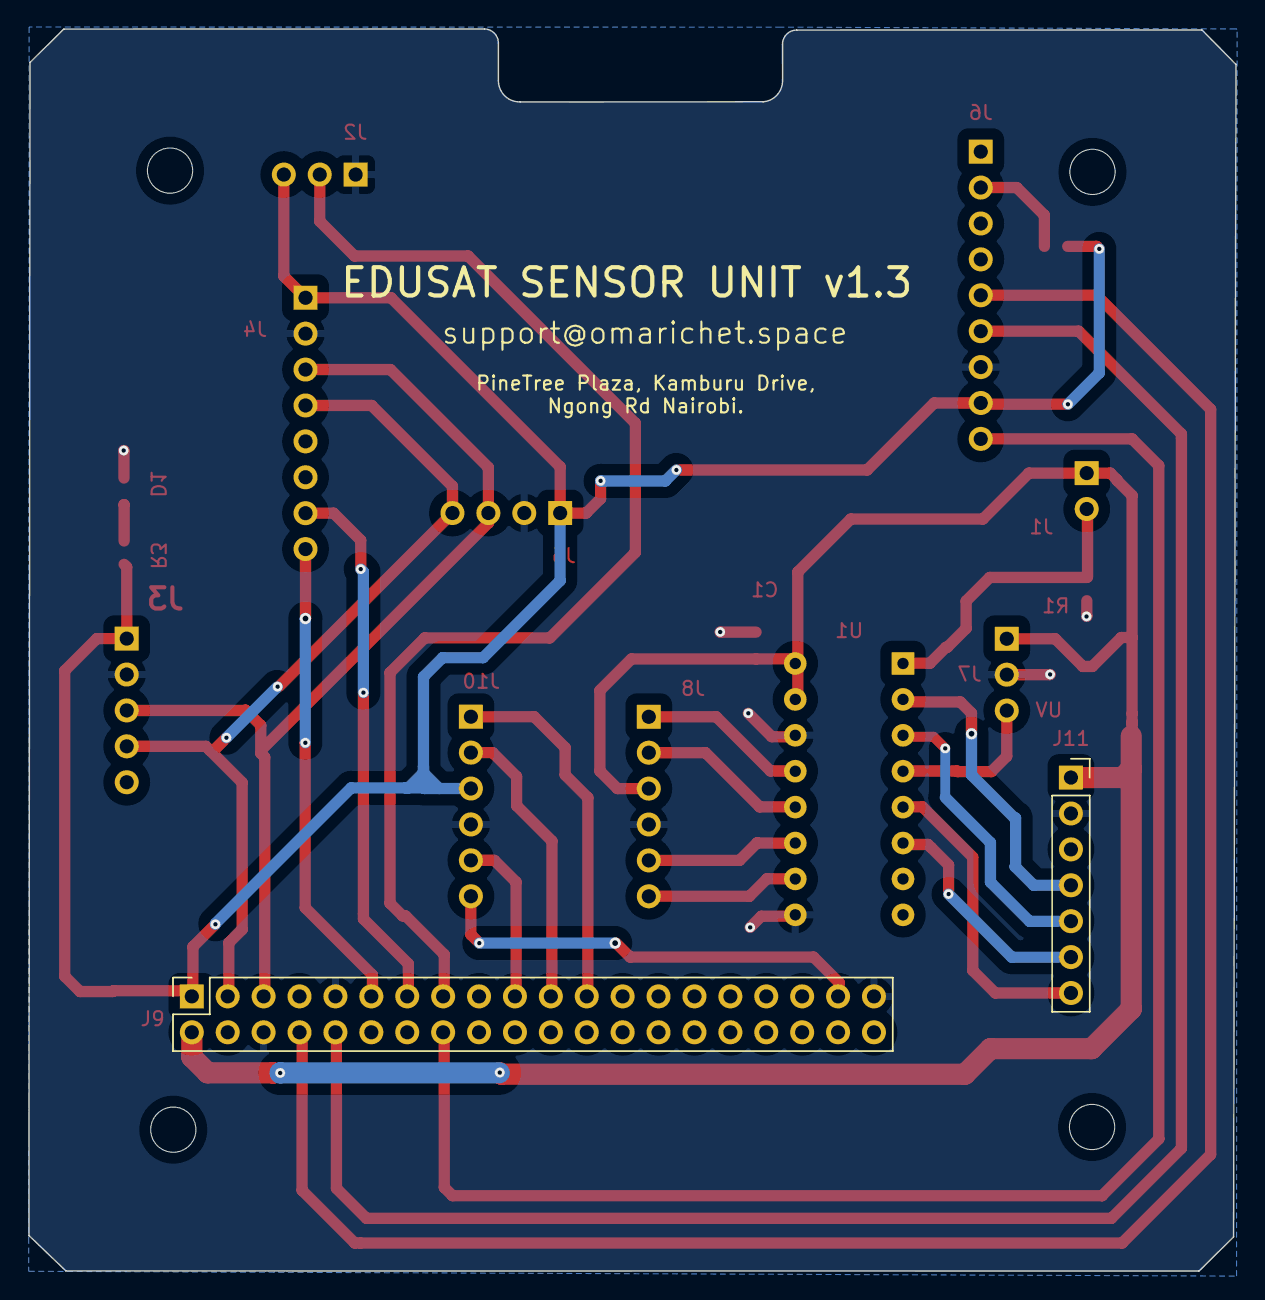
[picture p48: board Omarichet Sensor Shield 1.3.kicad_pcb from below]

Board: 2 copper layers, 85.4 x 87.9 mm, 21 parts (2 on the bottom side), 27 nets.
