Meshack-Kinyua/Omarichet_Versionngs/Omarichet EduSat/Electrical/PCB designs/Omarichet EPS Stack V1.5/Omarich EPS stack V1.5/Omarich EPS stack V1.5.kicad_pcb

## KiCad design Omarichet EduSat/Electrical/PCB designs/Omarichet EPS Stack V1.5/Omarich EPS stack V1.5/Omarich EPS stack V1.5.kicad_pcb (2024-07-20)

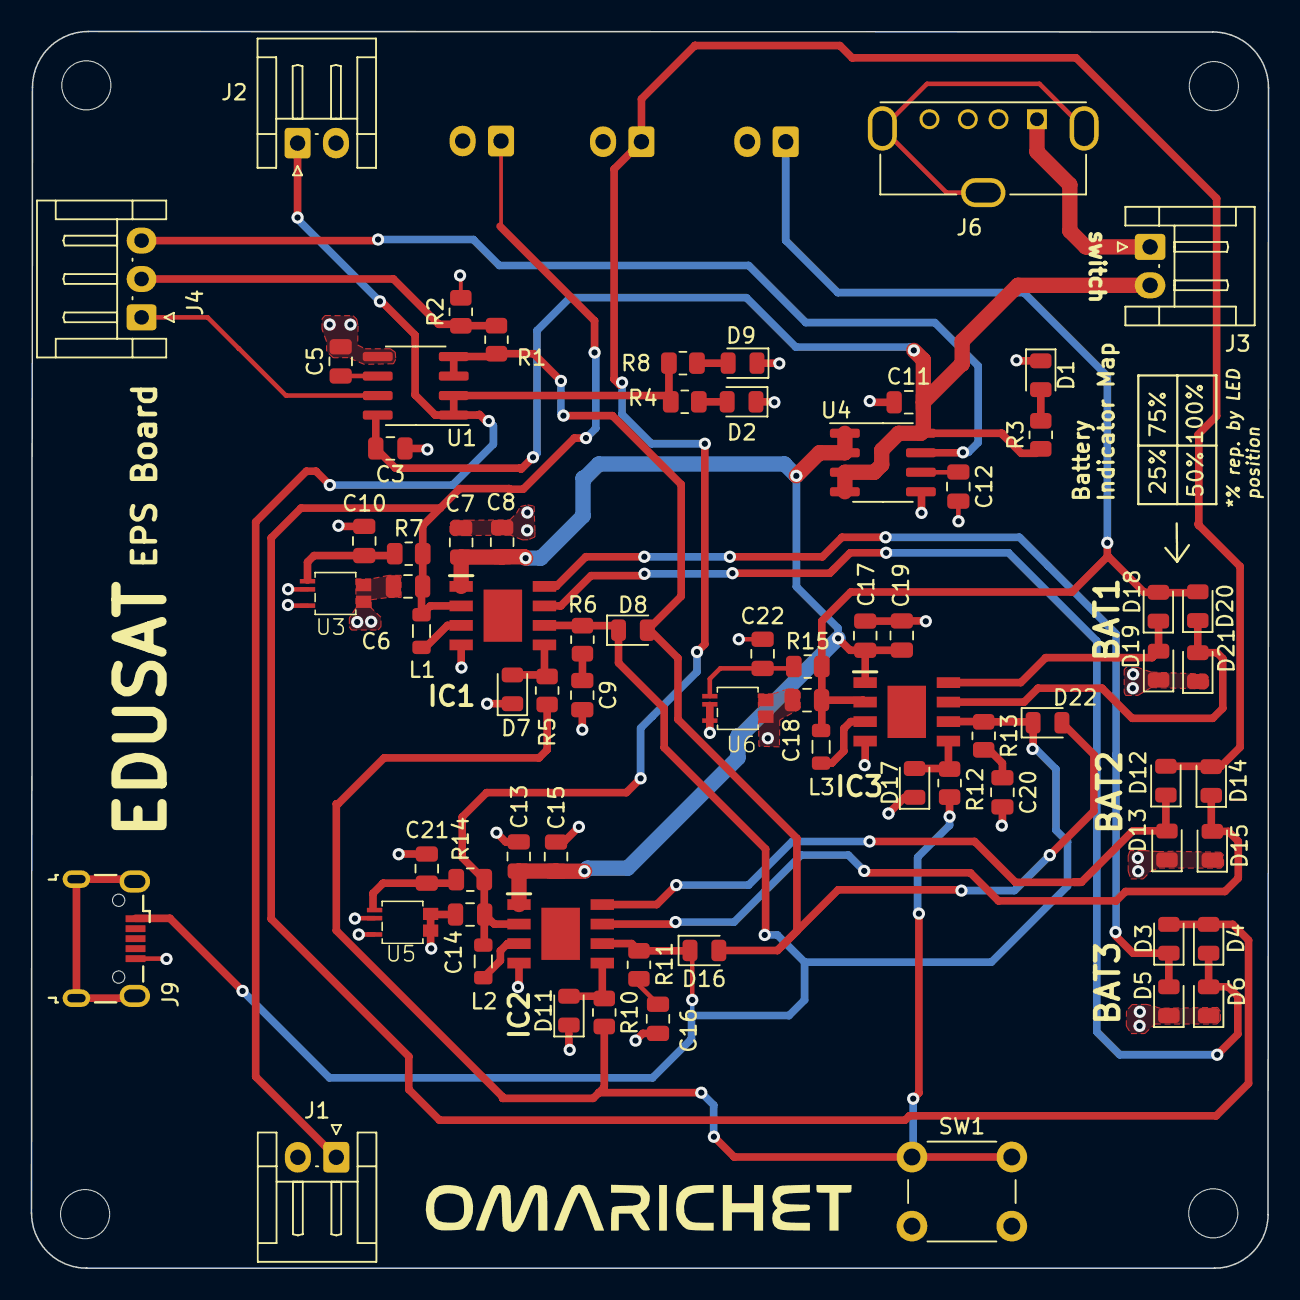
[picture p49: board Omarich EPS stack V1.5.kicad_pcb from above]

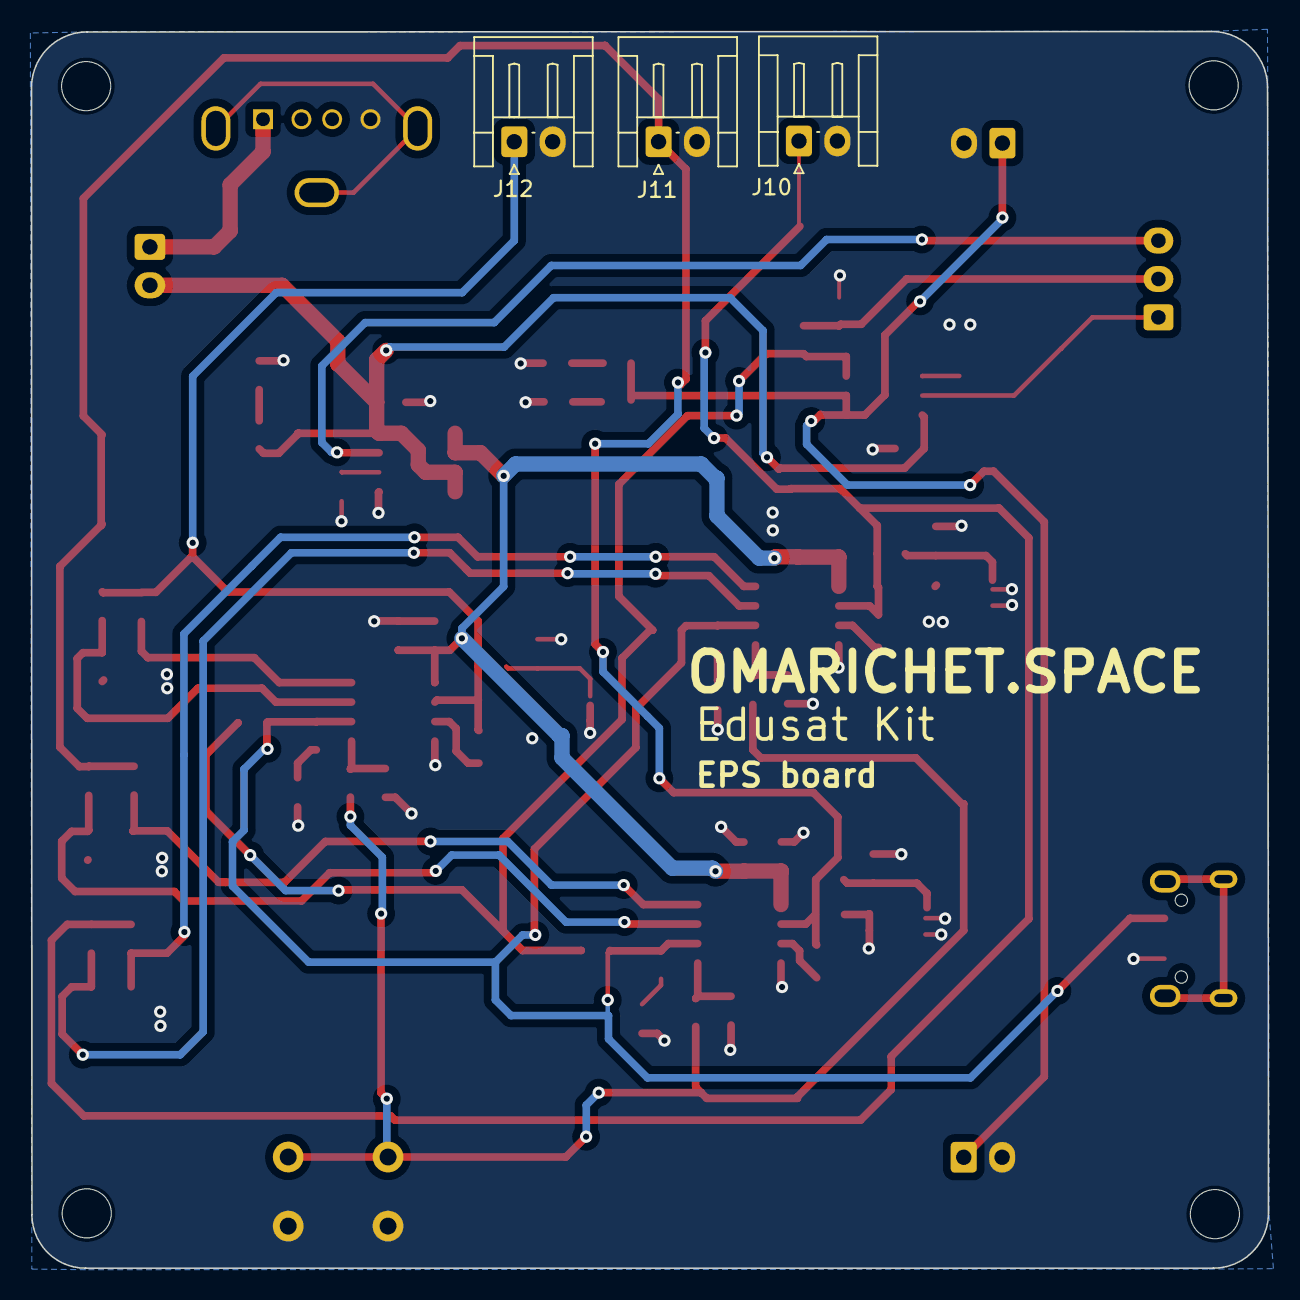
[picture p50: board Omarich EPS stack V1.5.kicad_pcb from below]

Board: 2 copper layers, 80.6 x 80.5 mm, 79 parts (3 on the bottom side), 37 nets.

Parts:
C3, C5, C11, C12: 1nF; C_0805_2012Metric
C6, C7, C8, C13, C14, C15, C17, C18, C19: 10uF; C_0805_2012Metric
C9, C16, C20: 2.2uF; C_0805_2012Metric
C10, C21, C22: 0.1uF; C_0805_2012Metric
D1, D2, D3, D4, D5, D6, D7, D9, D11, D12, D13, D14, D15, D17, D18, D19, D20, D21: LED; LED_0805_2012Metric
D8, D16, D22: D; D_0805_2012Metric
H1, H2, H3, H4: MountingHole; MountingHole_3.2mm_M3
IC1, IC2, IC3: TP4366E
J1, J2, J3, J10, J11, J12: Conn_01x02_Pin; JST_EH_S2B-EH_1x02_P2.50mm_Horizontal
J4: Conn_01x03_Pin; JST_EH_S3B-EH_1x03_P2.50mm_Horizontal
J6: USB_A; USB_A_Molex_105057_Vertical
J9: USB_B_Micro; USB_Micro-B_Wuerth_629105150521
L1, L2, L3: 1.5uH; L_0805_2012Metric
R1: 7.5k; R_0805_2012Metric
R2: 30k; R_0805_2012Metric
R3, R4, R7, R8, R14, R15: 1k; R_0805_2012Metric
R5, R10, R12: 10K; R_0805_2012Metric
R6, R11, R13: 1k5; R_0805_2012Metric
SW1: SW_Push; SW_PUSH_6mm_H5mm
U1, U4: ACS712xLCTR-05B; SOIC-8_3.9x4.9mm_P1.27mm
U3, U5, U6: XB7608AJ

Connections:
5V: C7.2, C8.2, C13.2, C15.2, C17.2, C19.2, IC1.1 (OUT), IC2.1 (OUT), IC3.1 (OUT), U4.1 (IP+), U4.2 (IP+)
+5V: C3.2, C11.2, J3.2, R3.1, U1.8 (VCC), U4.3 (IP-), U4.4 (IP-), U4.8 (VCC)
/SWT1: D7.2 (A), IC1.5 (SWT), R5.1
/SWT2: D11.2 (A), IC2.5 (SWT), R10.1
/SWT3: D17.2 (A), IC3.5 (SWT), R12.1
BAT-1: C6.1, D3.2 (A), D4.2 (A), IC1.2 (BAT), J10.1, L1.1, R7.2
BAT-2: C14.1, D12.2 (A), D14.2 (A), IC2.2 (BAT), J11.1, L2.1, R14.2
BAT-3: C18.1, D18.2 (A), D20.2 (A), IC3.2 (BAT), J12.1, L3.1, R15.2
BtnIn: R5.2, R10.2, R12.2, SW1.1
CH3: J4.3, U4.7 (VIOUT)
CH4: J4.2, R1.2, R2.1
CH5: J4.1, U1.7 (VIOUT)
GND: C3.1, C5.2, C6.2, C7.1, C8.1, C9.2, C10.2, C11.1, C12.2, C13.1, C14.2, C15.1, C16.2, C17.1, C18.2, C19.1, C20.2, C21.2, C22.2, D1.1 (K), D2.1 (K), D5.1 (K), D6.1 (K), D7.1 (K), D9.1 (K), D11.1 (K), D13.1 (K), D15.1 (K), D17.1 (K), D19.1 (K), D21.1 (K), IC1.4 (GND), IC2.4 (GND), IC3.4 (GND), J1.2, J2.2, J6.4 (GND), J9.5 (GND), J10.2, J11.2, J12.2, R2.2, SW1.2, U1.5 (GND), U3.2 (GND), U3.3 (GND), U3.4 (VM), U3.5 (VM), U4.5 (GND), U5.2 (GND), U5.3 (GND), U5.4 (VM), U5.5 (VM), U6.2 (GND), U6.3 (GND), U6.4 (VM), U6.5 (VM)
unnamed: C9.1, R6.2
unnamed: C16.1, R11.2
unnamed: C20.1, R13.2
unnamed: D1.2 (A), R3.2
unnamed: D2.2 (A), R4.2
unnamed: D3.1 (K), D5.2 (A), IC1.8 (LED1)
unnamed: D4.1 (K), D6.2 (A), IC1.7 (LED2)
unnamed: D9.2 (A), R8.2
unnamed: D12.1 (K), D13.2 (A), IC2.8 (LED1)
unnamed: D14.1 (K), D15.2 (A), IC2.7 (LED2)
unnamed: D18.1 (K), D19.2 (A), IC3.8 (LED1)
unnamed: D20.1 (K), D21.2 (A), IC3.7 (LED2)
unnamed: J3.1, J6.1 (VBUS)
unnamed: C5.1, U1.6 (FILTER)
unnamed: C10.1, R7.1, U3.1 (VDD)
unnamed: C12.1, U4.6 (FILTER)
unnamed: C21.1, R14.1, U5.1 (VDD)
unnamed: C22.1, R15.1, U6.1 (VDD)
SW1: IC1.3 (SW), L1.2
SW2: IC2.3 (SW), L2.2
SW3: IC3.3 (SW), L3.2
Solar1: J1.1, J2.1, R4.1, R8.1, U1.1 (IP+), U1.2 (IP+)
VBUS: D8.1 (K), D16.1 (K), D22.1 (K), IC1.6 (VDD), IC2.6 (VDD), IC3.6 (VDD), J9.1 (VBUS), R6.1, R11.1, R13.1
VDD: D8.2 (A), D16.2 (A), D22.2 (A), R1.1, U1.3 (IP-), U1.4 (IP-)
