Meshack-Kinyua/Omarichet_Versionngs/Omarichet EduSat/Electrical/PCB designs/Omarichet Sensor Shield V1.2/Omarichet Sensor Shield 1.2.kicad_pcb

## KiCad design Omarichet EduSat/Electrical/PCB designs/Omarichet Sensor Shield V1.2/Omarichet Sensor Shield 1.2.kicad_pcb (2024-07-20, an earlier design)

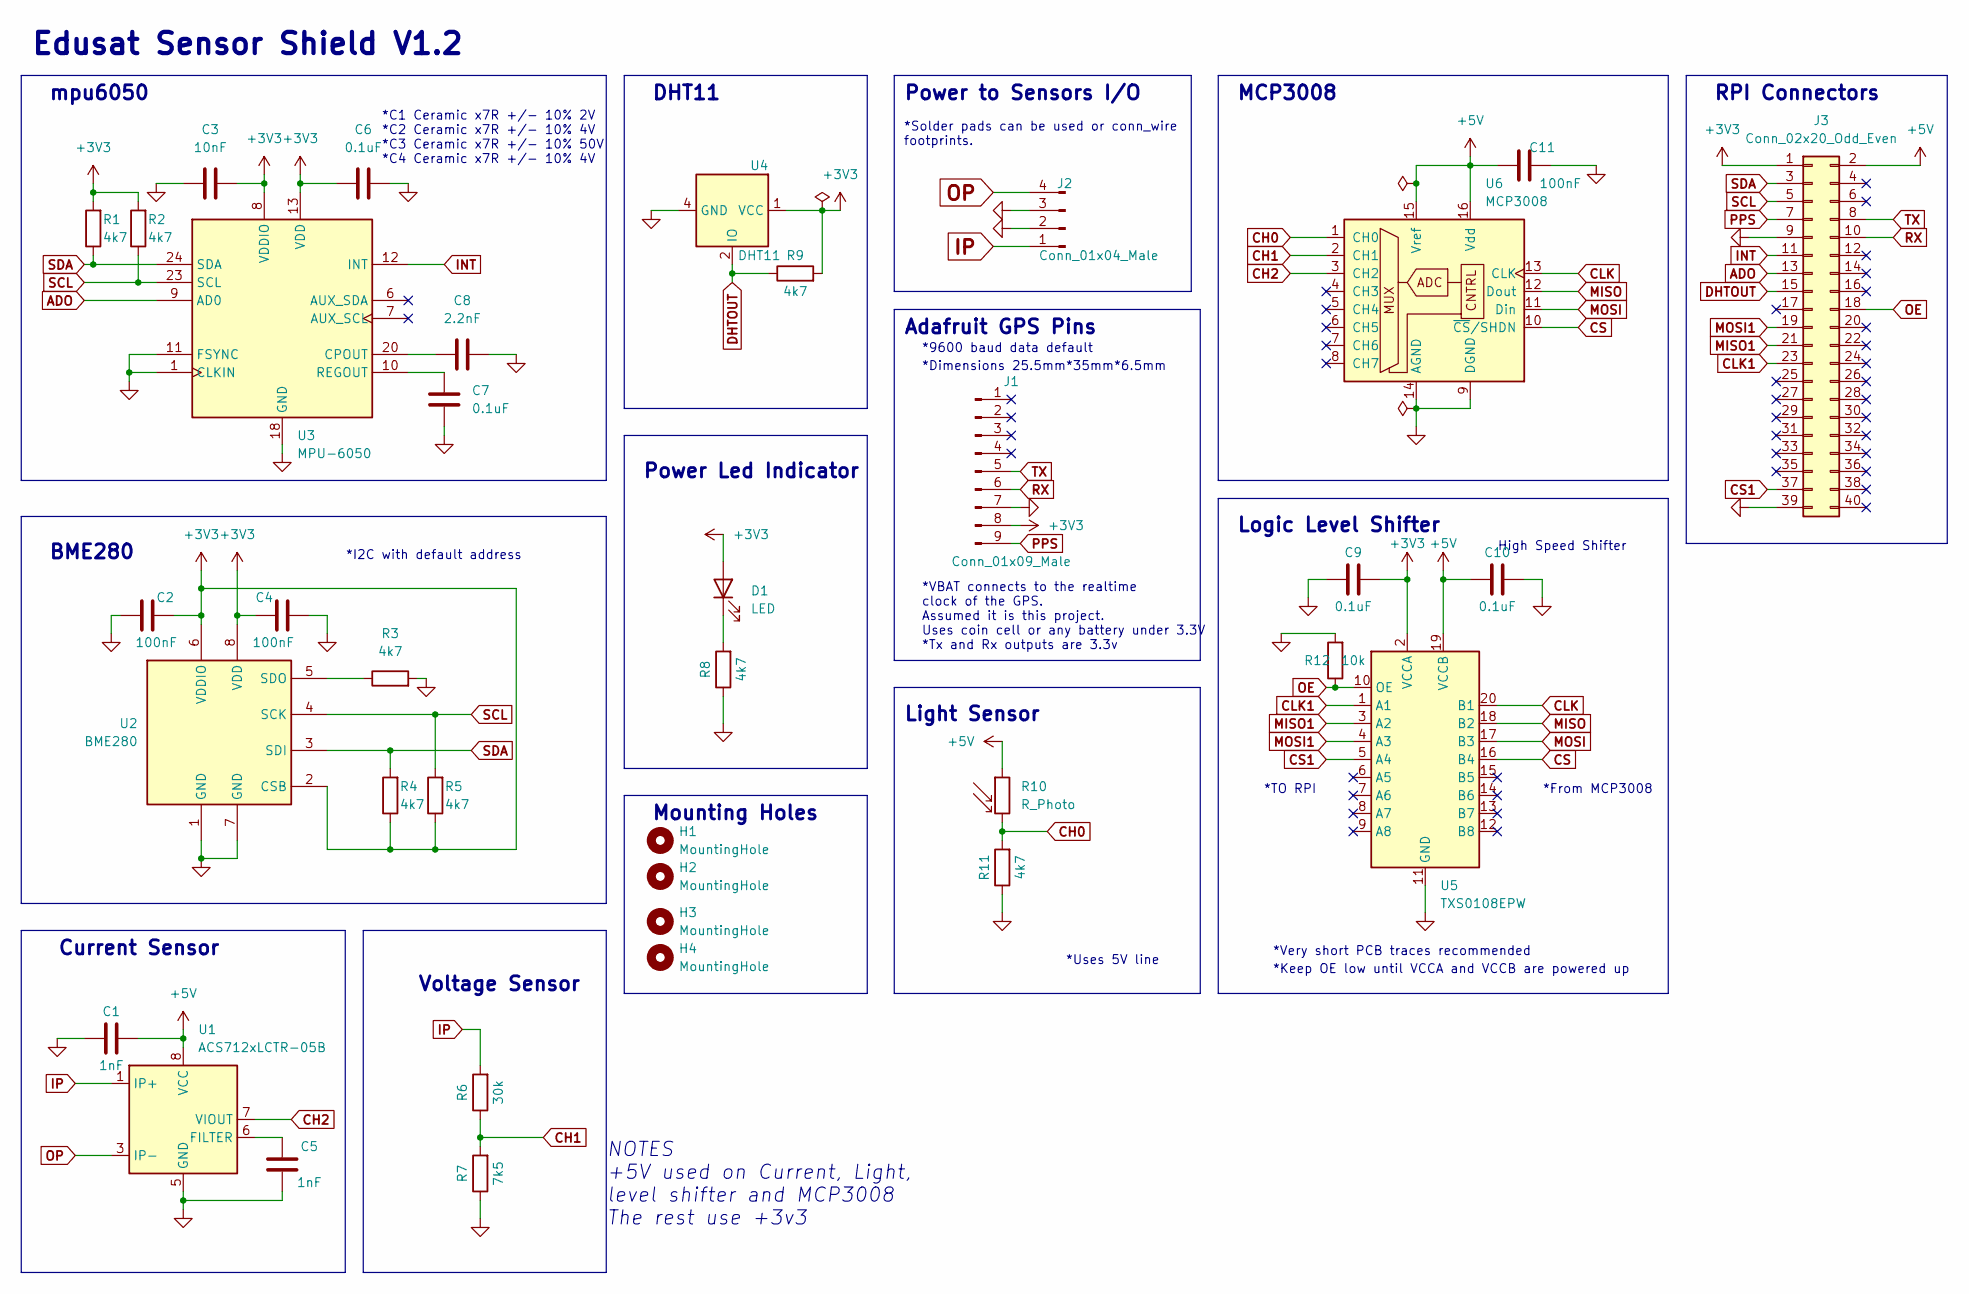
[picture p51: schematic Omarichet Sensor Shield 1.2.kicad_sch, Edusat Sensor Unit Shield]

Parts:
C1, C5: 1nF; C_0402_1005Metric
C2, C4, C11: 100nF; C_0402_1005Metric
C3: 10nF; C_0402_1005Metric
C6, C7, C9, C10: 0.1uF; C_0603_1608Metric
C8: 2.2nF; C_0402_1005Metric
D1: LED; LED_0603_1608Metric
H1, H2, H3, H4: MountingHole; MountingHole_3.2mm_M3
J1: Conn_01x09_Male; PinHeader_1x09_P2.54mm_Vertical
J2: Conn_01x04_Male; SolderWire-0.25sqmm_1x04_P4.2mm_D0.65mm_OD1.7mm_Relief
J3: Conn_02x20_Odd_Even; PinSocket_2x20_P2.54mm_Vertical
R1, R2, R3, R4, R5, R8, R9, R11: 4k7; R_0402_1005Metric
R6: 30k; R_0402_1005Metric
R7: 7k5; R_0402_1005Metric
R10: R_Photo; R_LDR_4.9x4.2mm_P2.54mm_Vertical
R12: 10k; R_0402_1005Metric
U1: ACS712xLCTR-05B; SOIC-8_3.9x4.9mm_P1.27mm
U2: BME280; Bosch_LGA-8_2.5x2.5mm_P0.65mm_ClockwisePinNumbering
U3: MPU-6050; InvenSense_QFN-24_4x4mm_P0.5mm
U4: DHT11; Aosong_DHT11_5.5x12.0_P2.54mm
U5: TXS0108EPW; TSSOP-20_4.4x6.5mm_P0.65mm
U6: MCP3008; DIP-16_W7.62mm

Connections:
+3V3: C2.2, C3.2, C4.1, C6.1, C9.2, D1.2 (A), J1.8, J3.1, R1.2, R2.2, R4.1, R5.1, R9.2, U2.2 (CSB), U2.6 (VDDIO), U2.8 (VDD), U3.8 (VDDIO), U3.13 (VDD), U4.1 (VCC), U5.2 (VCCA)
+5V: C1.1, C10.1, C11.1, J3.2, R10.1, U1.8 (VCC), U5.19 (VCCB), U6.15 (Vref), U6.16 (Vdd)
ADO: J3.13, U3.9 (AD0)
CH0: R10.2, R11.2, U6.1 (CH0)
CH1: R6.1, R7.2, U6.2 (CH1)
CH2: U1.7 (VIOUT), U6.3 (CH2)
CLK: U5.20 (B1), U6.13 (CLK)
CLK1: J3.23, U5.1 (A1)
CS: U5.16 (B4), U6.10 (~CS/SHDN)
CS1: J3.37, U5.5 (A4)
DHTOUT: J3.15, R9.1, U4.2 (IO)
GND: C1.2, C2.1, C3.1, C4.2, C5.1, C6.2, C7.1, C8.2, C9.1, C10.2, C11.2, J1.7, J2.2, J2.3, J3.9, J3.39, R3.2, R7.1, R8.1, R11.1, R12.2, U1.5 (GND), U2.1 (GND), U2.7 (GND), U3.1 (CLKIN), U3.11 (FSYNC), U3.18 (GND), U4.4 (GND), U5.11 (GND), U6.9 (DGND), U6.14 (AGND)
INT: J3.11, U3.12 (INT)
IP: J2.1, R6.2, U1.1 (IP+), U1.2 (IP+)
MISO: U5.18 (B2), U6.12 (Dout)
MISO1: J3.21, U5.3 (A2)
MOSI: U5.17 (B3), U6.11 (Din)
MOSI1: J3.19, U5.4 (A3)
unnamed: C5.2, U1.6 (FILTER)
unnamed: C7.2, U3.10 (REGOUT)
unnamed: C8.1, U3.20 (CPOUT)
unnamed: D1.1 (K), R8.2
unnamed: R3.1, U2.5 (SDO)
OE: J3.18, R12.1, U5.10 (OE)
OP: J2.4, U1.3 (IP-), U1.4 (IP-)
PPS: J1.9, J3.7
RX: J1.6, J3.10
SCL: J3.5, R2.1, R5.2, U2.4 (SCK), U3.23 (SCL)
SDA: J3.3, R1.1, R4.2, U2.3 (SDI), U3.24 (SDA)
TX: J1.5, J3.8

Notes on the sheet:
Voltage Sensor
DHT11
MCP3008
*Keep OE low until VCCA and VCCB are powered up
*Dimensions 25.5mm*35mm*6.5mm
Power Led Indicator
*9600 baud data default
Mounting Holes
Light Sensor
BME280
RPI Connectors
Edusat Sensor Shield V1.2
*TO RPI
Adafruit GPS Pins
*Very short PCB traces recommended
Current Sensor
Power to Sensors I/O
*Solder pads can be used or conn_wire footprints.
*VBAT connects to the realtime clock of the GPS. Assumed it is this project. Uses coin cell or any battery under 3.3V *Tx and Rx outputs are 3.3v
NOTES +5V used on Current, Light, level shifter and MCP3008 The rest use +3v3
mpu6050
*Uses 5V line
Logic Level Shifter
*C1 Ceramic x7R +/- 10% 2V *C2 Ceramic x7R +/- 10% 4V *C3 Ceramic x7R +/- 10% 50V *C4 Ceramic x7R +/- 10% 4V
*From MCP3008
High Speed Shifter
*I2C with default address

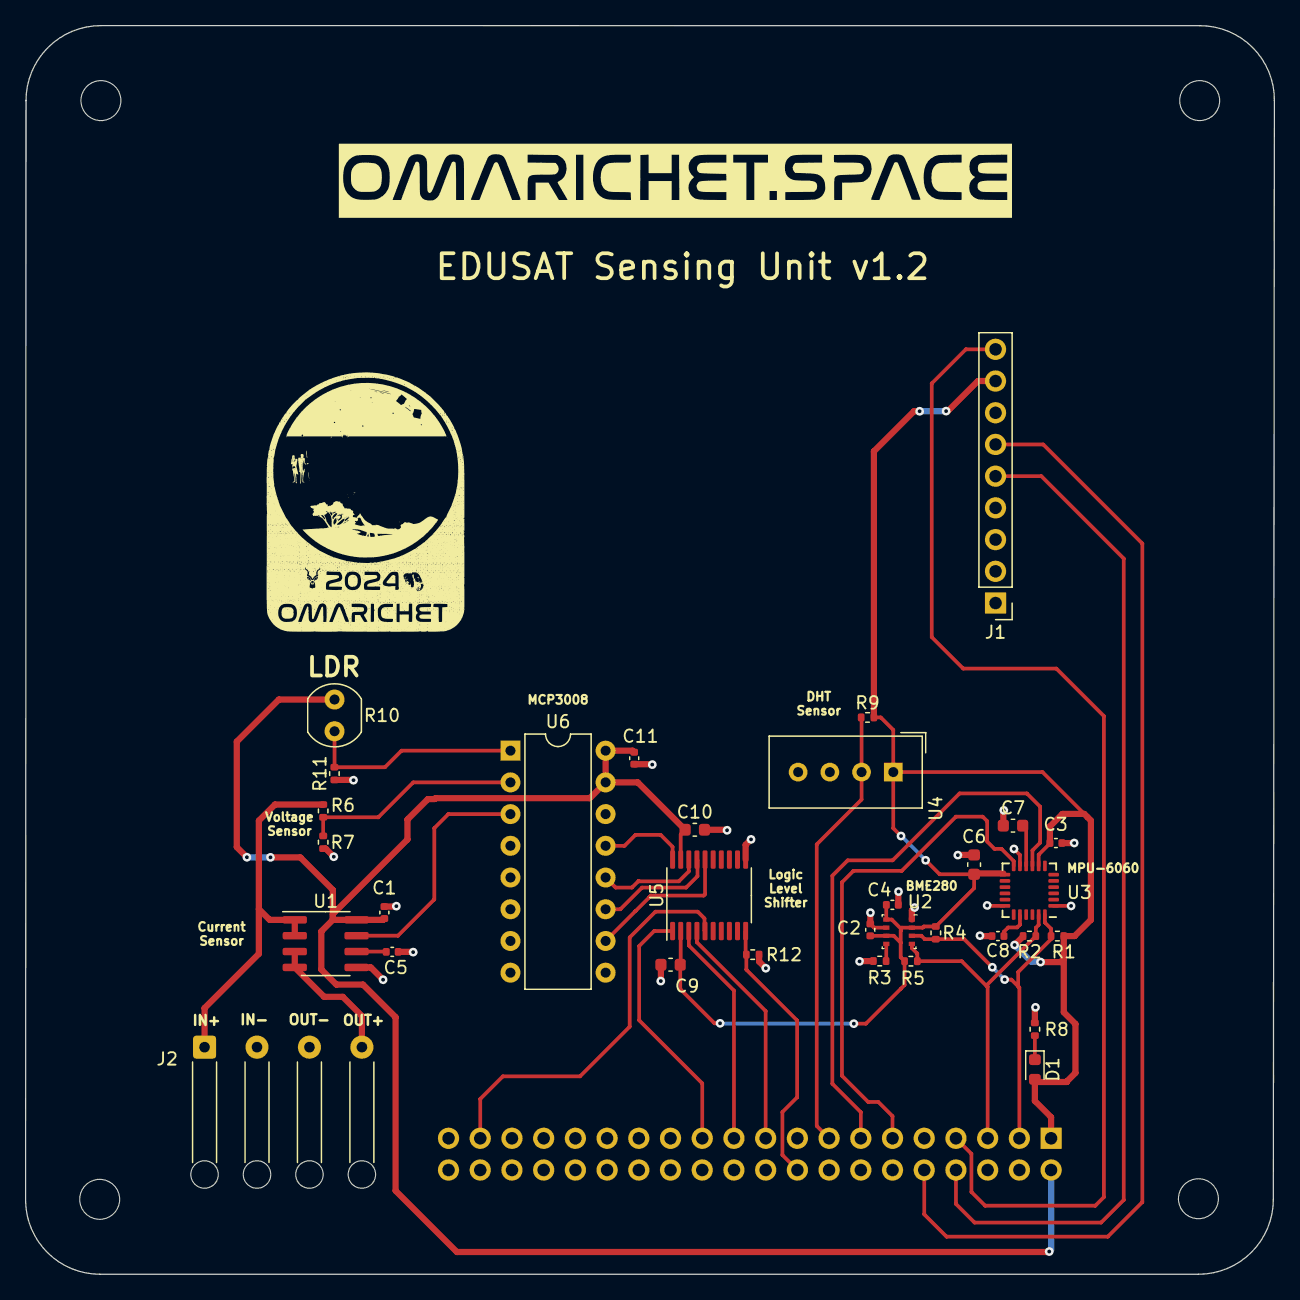
[picture p52: board Omarichet Sensor Shield 1.2.kicad_pcb from above]

Board: 2 copper layers, 100.0 x 100.0 mm, 37 parts (1 on the bottom side), 30 nets.
