Meshack-Kinyua/Omarichet_Versionngs/Omarichet EduSat/Electrical/PCB designs/Omarichet EPS Stack/Omarichet EPS Stack.kicad_pcb

## KiCad design Omarichet EduSat/Electrical/PCB designs/Omarichet EPS Stack/Omarichet EPS Stack.kicad_pcb (2024-07-20)

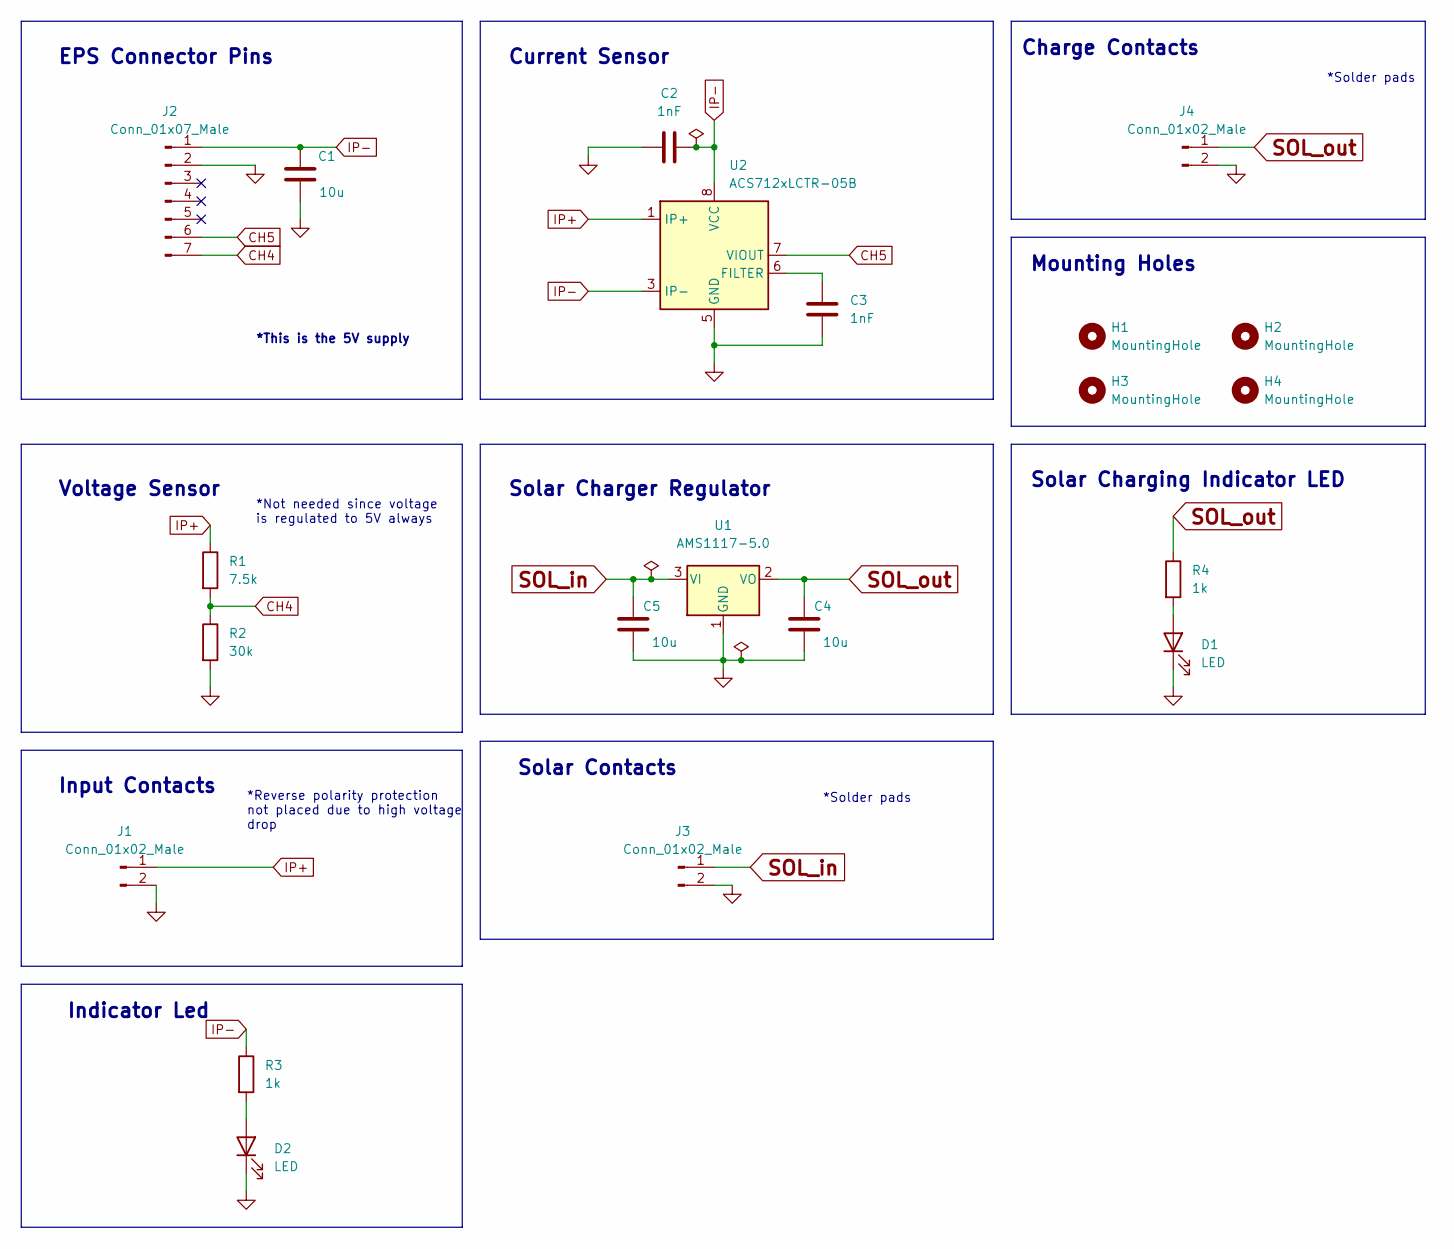
[picture p53: schematic Omarichet EPS Stack.kicad_sch]

Parts:
C1, C4, C5: 10u; C_0805_2012Metric
C2, C3: 1nF; C_0805_2012Metric
D1, D2: LED; LED_0805_2012Metric
H1, H2, H3, H4: MountingHole; MountingHole_3.2mm_M3
J1, J3, J4: Conn_01x02_Male; SolderWire-0.75sqmm_1x02_P7mm_D1.25mm_OD3.5mm_Relief
J2: Conn_01x07_Male; PinHeader_1x07_P2.54mm_Vertical
R1: 7.5k; R_0603_1608Metric
R2: 30k; R_0603_1608Metric
R3, R4: 1k; R_0603_1608Metric
U1: AMS1117-5.0; SOT-223-3_TabPin2
U2: ACS712xLCTR-05B; SOIC-8_3.9x4.9mm_P1.27mm

Connections:
CH4: J2.7, R1.2, R2.1
CH5: J2.6, U2.7 (VIOUT)
GND: C1.1, C2.1, C3.2, C4.2, C5.2, D1.1 (K), D2.1 (K), J1.2, J2.2, J3.2, J4.2, R2.2, U1.1 (GND), U2.5 (GND)
IP+: J1.1, R1.1, U2.1 (IP+), U2.2 (IP+)
IP-: C1.2, C2.2, J2.1, R3.1, U2.3 (IP-), U2.4 (IP-), U2.8 (VCC)
unnamed: C3.1, U2.6 (FILTER)
unnamed: D1.2 (A), R4.2
unnamed: D2.2 (A), R3.2
SOL_in: C5.1, J3.1, U1.3 (VI)
SOL_out: C4.1, J4.1, R4.1, U1.2 (VO)

Notes on the sheet:
Solar Charging Indicator LED
*Not needed since voltage is regulated to 5V always
*This is the 5V supply
Indicator Led
*Solder pads
Charge Contacts
Solar Charger Regulator
Solar Contacts
Input Contacts
*Reverse polarity protection not placed due to high voltage drop
Mounting Holes
Current Sensor
Voltage Sensor
EPS Connector Pins

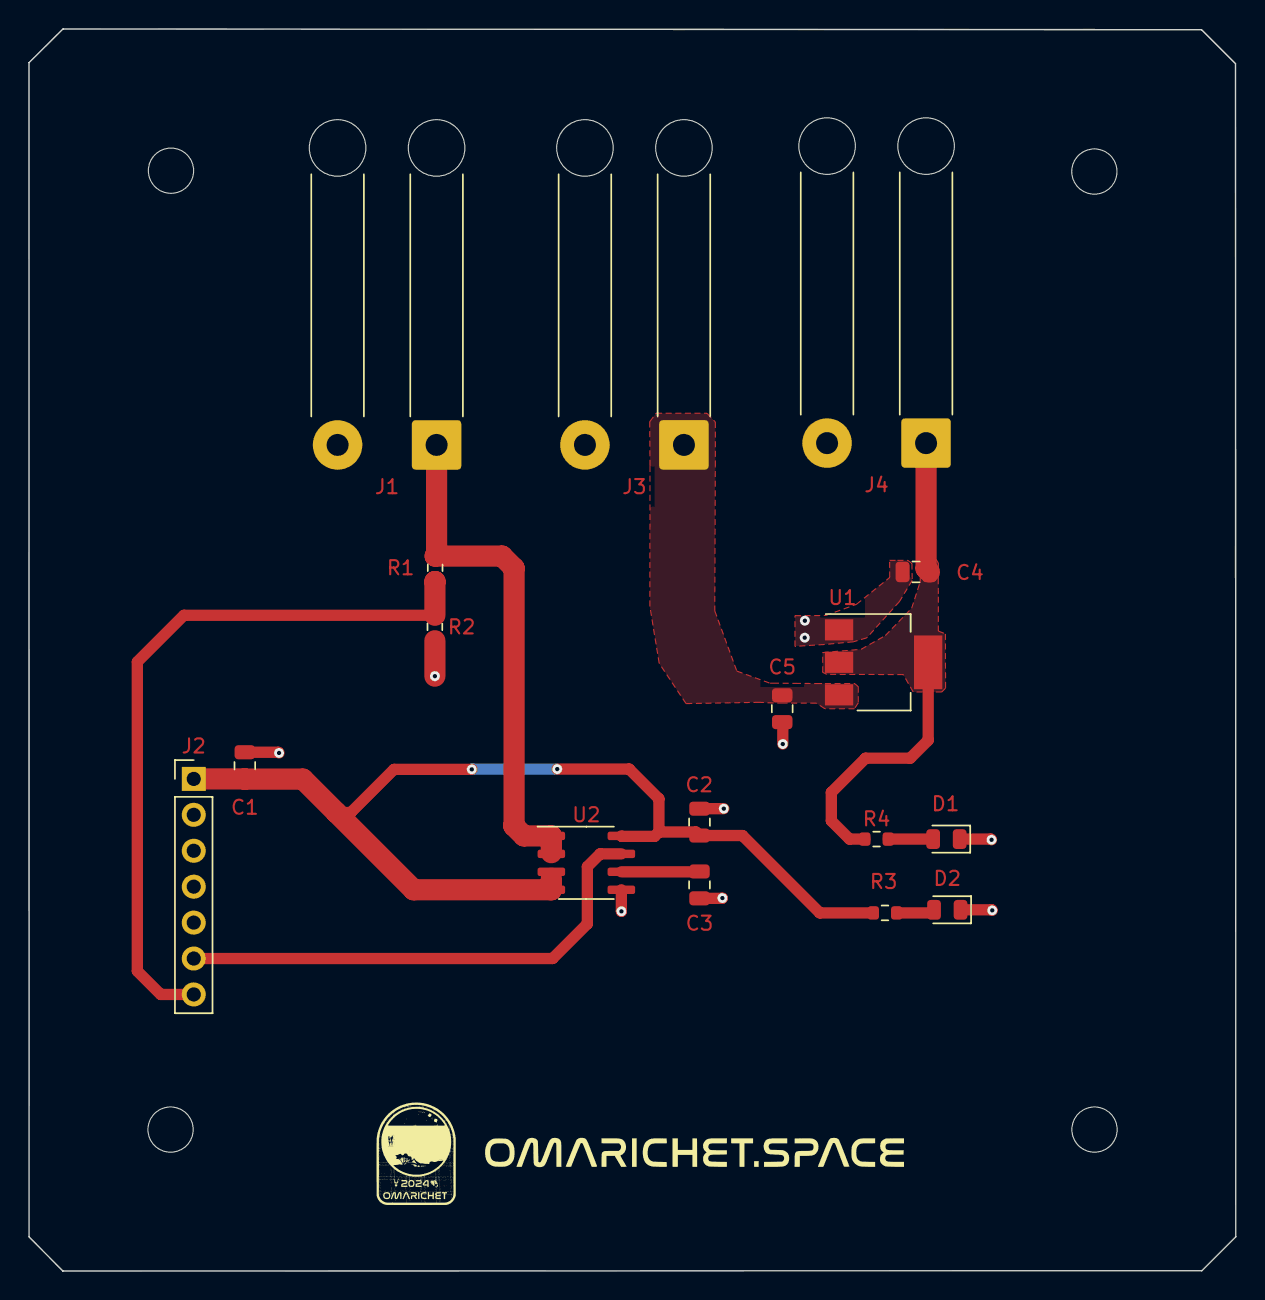
[picture p54: board Omarichet EPS Stack.kicad_pcb from above]

Board: 2 copper layers, 85.3 x 87.8 mm, 21 parts (0 on the bottom side), 10 nets.
