Meshack-Kinyua/Omarichet_Versionngs/Omarichet EduSat/Electrical/PCB designs/Omarichet Sensor Shield V1.1/Omarichet Sensor Shield 2.kicad_pcb

## KiCad design Omarichet EduSat/Electrical/PCB designs/Omarichet Sensor Shield V1.1/Omarichet Sensor Shield 2.kicad_pcb (2024-07-20, an earlier design)

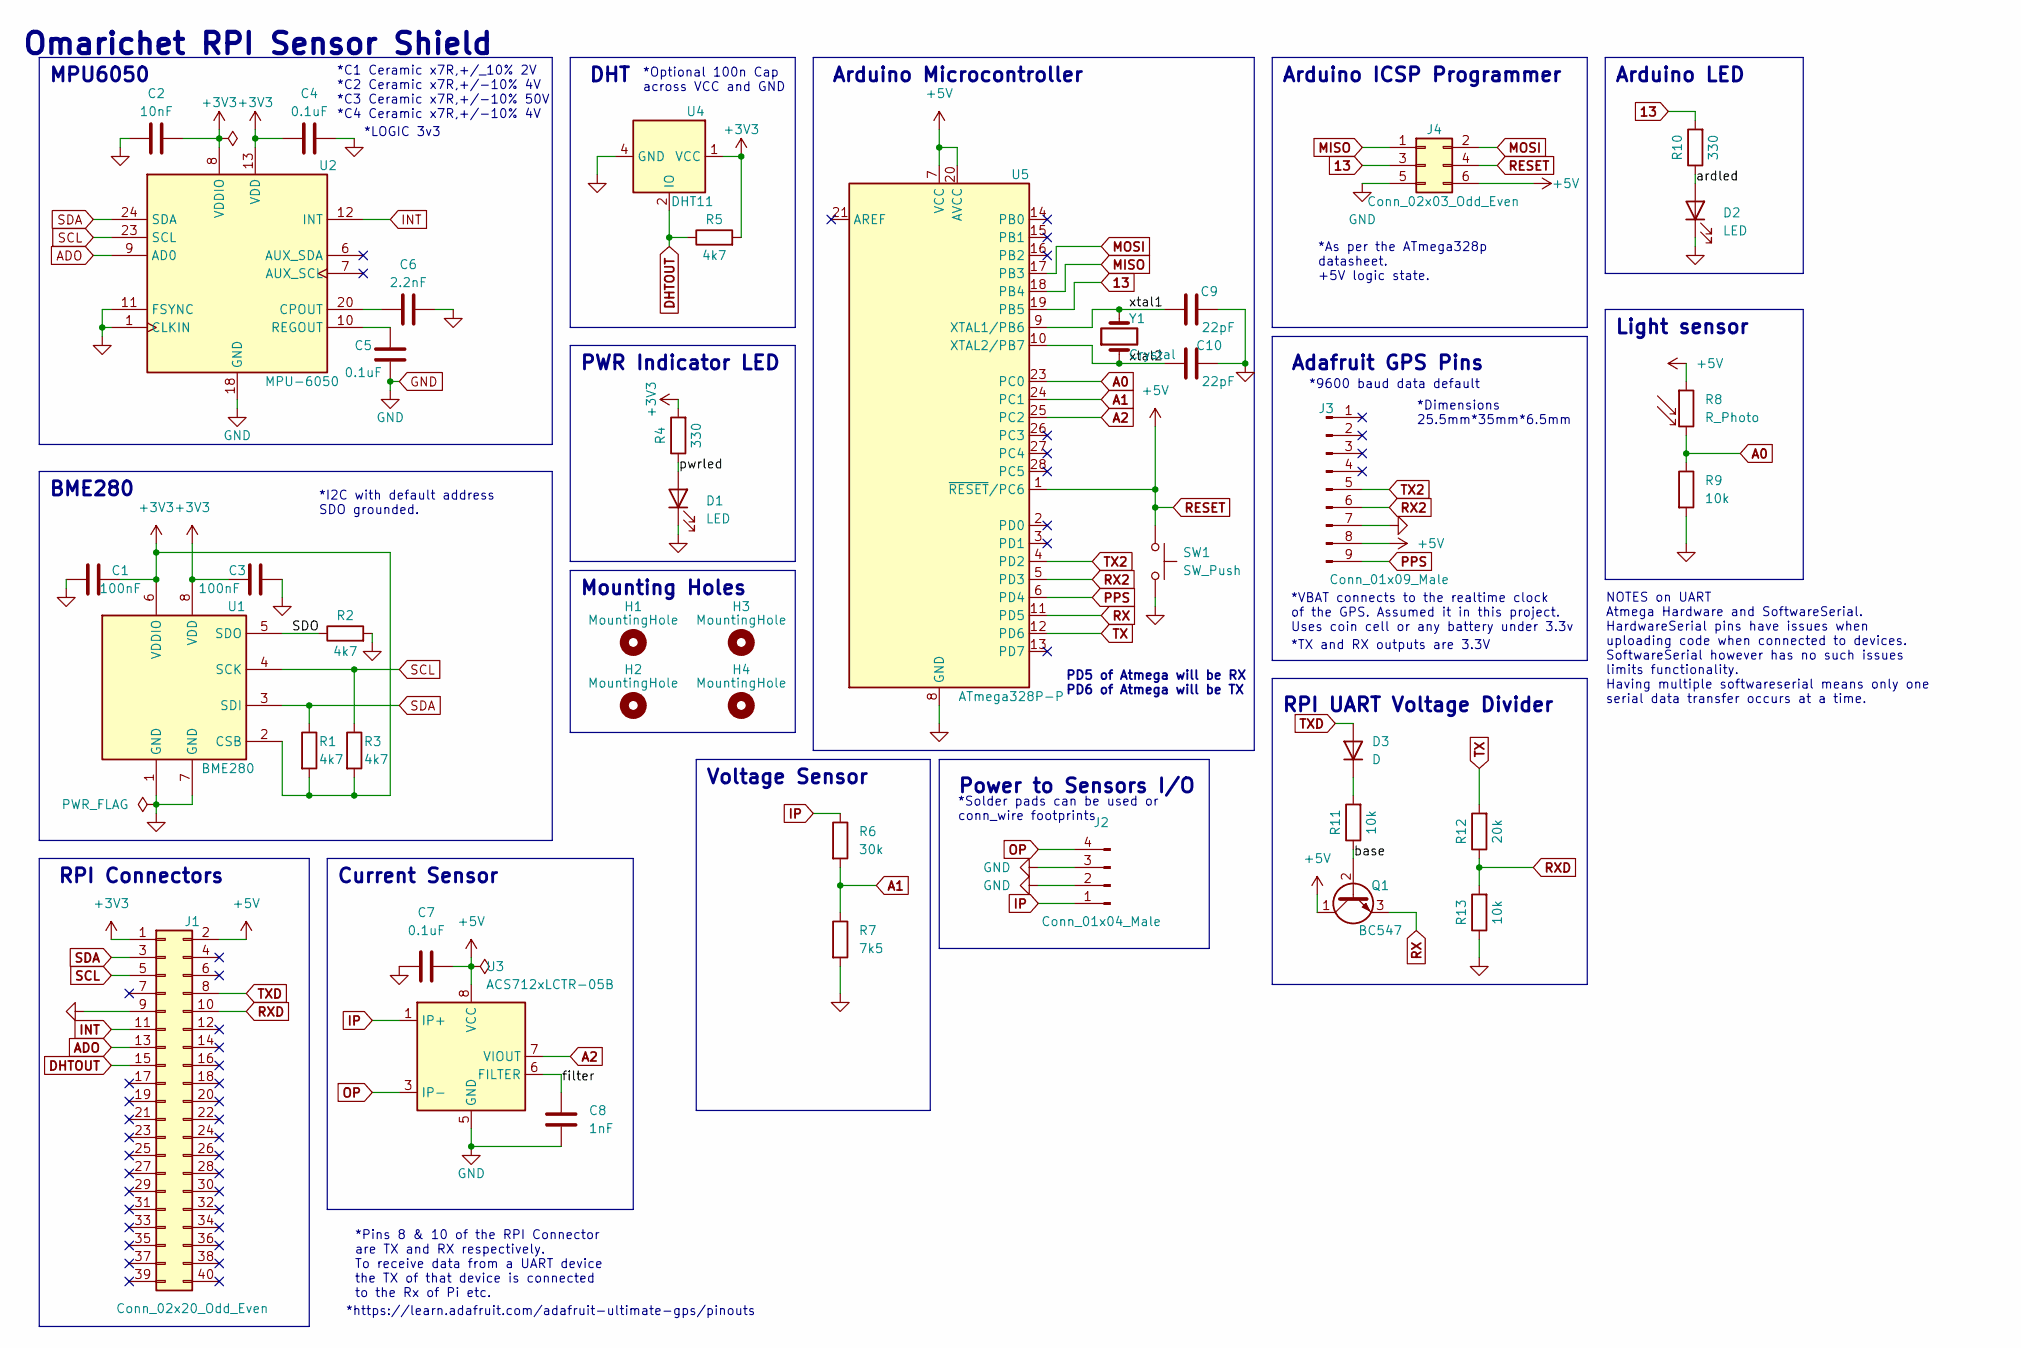
[picture p55: schematic Omarichet Sensor Shield 2.kicad_sch, Omarichet RPI sensor Shield containing various sensors.]

Parts:
C1, C3: 100nF; C_0402_1005Metric
C2: 10nF; C_0402_1005Metric
C4, C5, C7: 0.1uF; C_0603_1608Metric
C6: 2.2nF; C_0402_1005Metric
C8: 1nF; C_0402_1005Metric
C9, C10: 22pF; C_0402_1005Metric
D1, D2: LED; LED_0603_1608Metric
D3: D; D_0603_1608Metric
H1, H2, H3, H4: MountingHole; MountingHole_3.2mm_M3
J1: Conn_02x20_Odd_Even; PinSocket_2x20_P2.54mm_Vertical
J2: Conn_01x04_Male; SolderWire-0.25sqmm_1x04_P4.2mm_D0.65mm_OD1.7mm_Relief
J3: Conn_01x09_Male; PinHeader_1x09_P2.00mm_Vertical
J4: Conn_02x03_Odd_Even; PinHeader_2x03_P2.54mm_Vertical
Q1: BC547; TO-92_Inline
R1, R2, R3, R5: 4k7; R_0402_1005Metric
R4, R10: 330; R_0402_1005Metric
R6: 30k; R_0402_1005Metric
R7: 7k5; R_0402_1005Metric
R8: R_Photo; R_LDR_4.9x4.2mm_P2.54mm_Vertical
R9, R11, R13: 10k; R_0402_1005Metric
R12: 20k; R_0402_1005Metric
SW1: SW_Push; SW_PUSH_6mm
U1: BME280; Bosch_LGA-8_2.5x2.5mm_P0.65mm_ClockwisePinNumbering
U2: MPU-6050; InvenSense_QFN-24_4x4mm_P0.5mm
U3: ACS712xLCTR-05B; SOIC-8_3.9x4.9mm_P1.27mm
U4: DHT11; Aosong_DHT11_5.5x12.0_P2.54mm
U5: ATmega328P-P; DIP-28_W7.62mm
Y1: Crystal; Crystal_HC49-4H_Vertical

Connections:
13: J4.3, R10.2, U5.19 (PB5)
+3V3: C1.1, C2.2, C3.1, C4.1, J1.1, R1.2, R3.2, R4.2, R5.2, U1.2 (CSB), U1.6 (VDDIO), U1.8 (VDD), U2.8 (VDDIO), U2.13 (VDD), U4.1 (VCC)
/SDO: R2.1, U1.5 (SDO)
/ardled: D2.2 (A), R10.1
/base: Q1.2 (B), R11.1
/filter: C8.1, U3.6 (FILTER)
/pwrled: D1.2 (A), R4.1
/xtal1: C9.1, U5.9 (XTAL1/PB6), Y1.2
/xtal2: C10.1, U5.10 (XTAL2/PB7), Y1.1
A0: R8.2, R9.1, U5.23 (PC0)
A1: R6.2, R7.1, U5.24 (PC1)
A2: U3.7 (VIOUT), U5.25 (PC2)
ADO: J1.13, U2.9 (AD0)
DHTOUT: J1.15, R5.1, U4.2 (IO)
GND: C1.2, C2.1, C3.2, C4.2, C5.1, C6.2, C7.1, C8.2, C9.2, C10.2, D1.1 (K), D2.1 (K), J1.9, J2.2, J2.3, J3.7, J4.5, R2.2, R7.2, R9.2, R13.1, SW1.1, U1.1 (GND), U1.7 (GND), U2.1 (CLKIN), U2.11 (FSYNC), U2.18 (GND), U3.5 (GND), U4.4 (GND), U5.8 (GND), U5.22 (GND)
INT: J1.11, U2.12 (INT)
IP: J2.1, R6.1, U3.1 (IP+), U3.2 (IP+)
MISO: J4.1, U5.18 (PB4)
MOSI: J4.2, U5.17 (PB3)
unnamed: C5.2, U2.10 (REGOUT)
unnamed: C6.1, U2.20 (CPOUT)
unnamed: D3.1 (K), R11.2
OP: J2.4, U3.3 (IP-), U3.4 (IP-)
PPS: J3.9, U5.6 (PD4)
RESET: C7.2, J1.2, J3.8, J4.4, J4.6, Q1.1 (C), R8.1, SW1.2, U3.8 (VCC), U5.1 (~RESET/PC6), U5.7 (VCC), U5.20 (AVCC)
RX: Q1.3 (E), U5.11 (PD5)
RX2: J3.6, U5.5 (PD3)
RXD: J1.10, R12.1, R13.2
SCL: J1.5, R3.1, U1.4 (SCK), U2.23 (SCL)
SDA: J1.3, R1.1, U1.3 (SDI), U2.24 (SDA)
TX: R12.2, U5.12 (PD6)
TX2: J3.5, U5.4 (PD2)
TXD: D3.2 (A), J1.8

Notes on the sheet:
NOTES on UART Atmega Hardware and SoftwareSerial. HardwareSerial pins have issues when uploading code when connected to devices. SoftwareSerial however has no such issues limits functionality. Having multiple softwareserial means only one serial data transfer occurs at a time.
*Optional 100n Cap across VCC and GND
*LOGIC 3v3
RPI Connectors
RPI UART Voltage Divider
Arduino Microcontroller
Mounting Holes
Arduino ICSP Programmer
Omarichet RPI Sensor Shield
Current Sensor
BME280
*VBAT connects to the realtime clock of the GPS. Assumed it in this project. Uses coin cell or any battery under 3.3v
Power to Sensors I/O
*https://learn.adafruit.com/adafruit-ultimate-gps/pinouts
*9600 baud data default
PD5 of Atmega will be RX PD6 of Atmega will be TX
MPU6050
Voltage Sensor
Adafruit GPS Pins
PWR Indicator LED
*Pins 8 & 10 of the RPI Connector are TX and RX respectively. To receive data from a UART device the TX of that device is connected to the Rx of Pi etc.
*C1 Ceramic x7R,+/_10% 2V *C2 Ceramic x7R,+/-10% 4V *C3 Ceramic x7R,+/-10% 50V *C4 Ceramic x7R,+/-10% 4V
Light sensor
*TX and RX outputs are 3.3V
DHT
*As per the ATmega328p datasheet. +5V logic state.
*Dimensions 25.5mm*35mm*6.5mm
Arduino LED
*Solder pads can be used or conn_wire footprints
*I2C with default address SDO grounded.

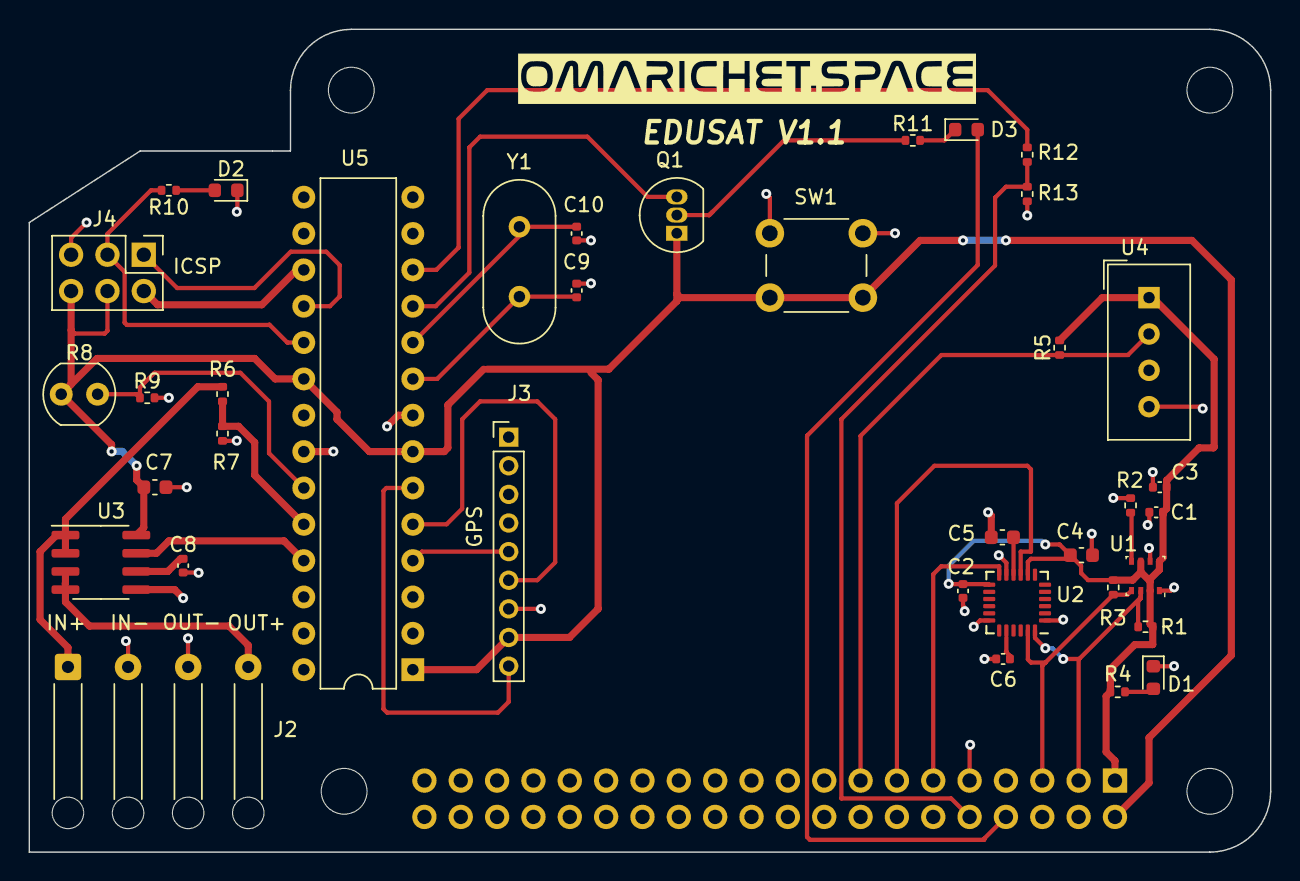
[picture p56: board Omarichet Sensor Shield 2.kicad_pcb from above]

Board: 2 copper layers, 86.8 x 57.5 mm, 42 parts (1 on the bottom side), 33 nets.
