Meshack-Kinyua/Omarichet_Versionngs/(commit log)

2024-07-13 adds pi camera documentation
2024-07-20 Omarichet's EduSat
    [105057-0001.stp, 67643-3911.stp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]
2024-07-24 updates system flowchart
2024-08-21 New version
    [EPSv3.kicad_pcb, EPSv3.kicad_sch, OBCv1.kicad_pcb, OBCv1.kicad_sch, SensorBoardv3.kicad_pcb, SensorBoardv3.kicad_sch]
2024-08-21 Another upload
    [ESP32-WROOM-32E__4MB_.step, OBCv1.kicad_pcb, OBCv1.kicad_sch, RA-02--3DModel-STEP-269445.STEP, TF-01A.step, USB4105-GF-A--3DModel-STEP-510211.STEP]
2024-08-22 v1 upload
    [430181038816.stp, 61300311821.stp, 61300511821.stp, 61300611821.stp, 61300811821.stp, 61300911821.stp, 61301221821.stp, 614004135023.stp]
2024-09-27 EPS updates
    [1042.step, EPSv3.kicad_pcb, EPSv3.kicad_sch, IRLML6344TRPBF.step]
2024-10-02 EPS Schematics
    [DFLS130L-7.step, DW06D.stp, EDI2CAP.CFG, EPSv3.kicad_pcb, EPSv3.kicad_sch, INDPM7366X300N.PcbLib, IP5306.step, IP5306.stp]
2024-10-04 More updates
    [1043.step, EPSv3.kicad_pcb, EPSv3.kicad_sch, OBCv1.kicad_pcb]
2024-10-08 EPS routing
    [EPSv3.kicad_pcb]
2024-10-09 EPS routing done
    [EPSv3.kicad_pcb]
2024-11-18 OBC updates
    [OBCv1.kicad_pcb, OBCv1.kicad_sch]
2024-11-27 EPS and OBC done
    [EPSv3.kicad_pcb, EPSv3.kicad_sch, OBCv1.kicad_pcb, OBCv1.kicad_sch]
2024-11-27 OBC Gerbers
    [OBCv1-B_Cu.gbl, OBCv1-B_Mask.gbs, OBCv1-B_Paste.gbp, OBCv1-B_Silkscreen.gbo, OBCv1-Edge_Cuts.gm1, OBCv1-F_Cu.gtl, OBCv1-F_Mask.gts, OBCv1-F_Paste.gtp]
2024-11-27 EPS & OBC Gerbers
    [EPSv3-B_Cu.gbl, EPSv3-B_Mask.gbs, EPSv3-B_Paste.gbp, EPSv3-B_Silkscreen.gbo, EPSv3-Edge_Cuts.gm1, EPSv3-F_Cu.gtl, EPSv3-F_Mask.gts, EPSv3-F_Paste.gtp]
